verma-suraj/xelulu/Eillik/Untitled design.png

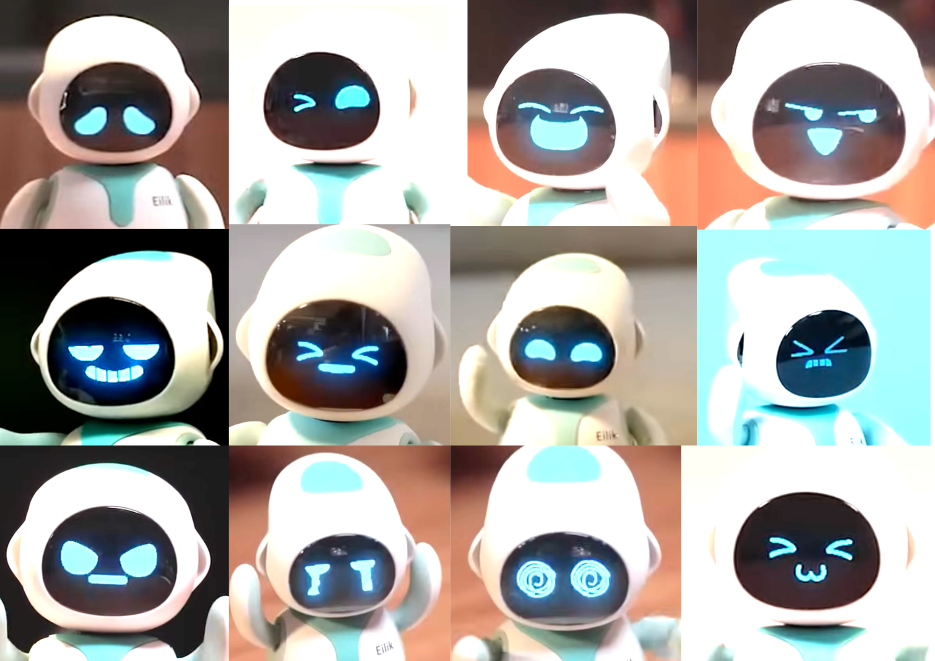
Eillik/Untitled design.png
