verma-suraj/xelulu/Sketch.png

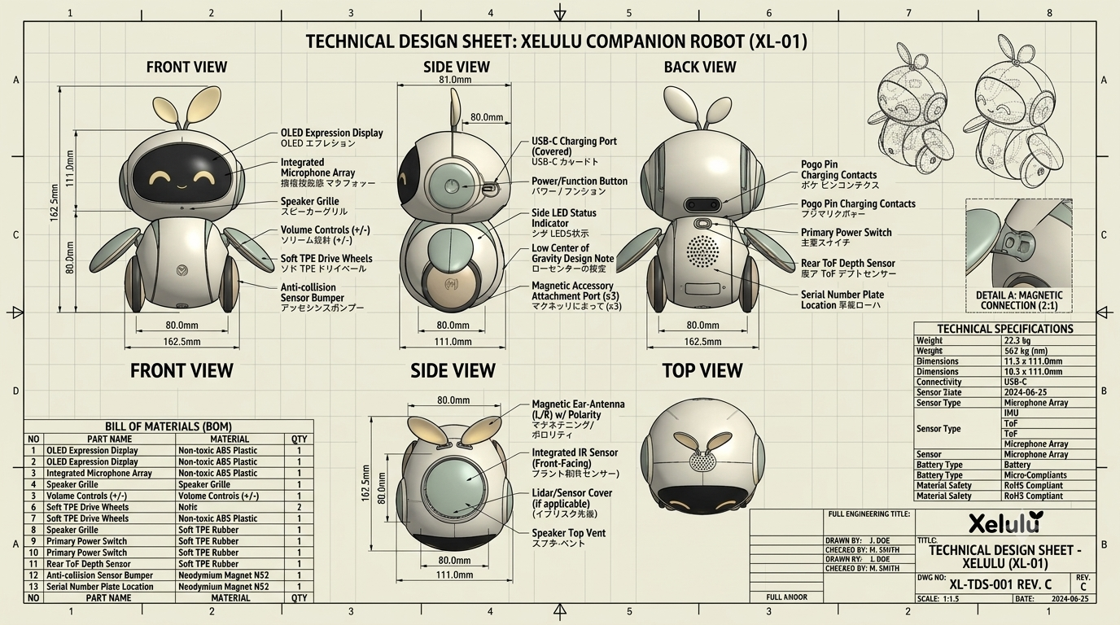
Sketch.png
