verma-suraj/xelulu/xelulu .docx

COMPANION INTELLIGENCE

Product Feature Catalogue

All features of Xelulu, Sathi / WithU, Parth and Sarthi, with the shared platform architecture

Contents

1. Shared platform architecture 3

2. The family at a glance 3

3. Features common to all four products 3

4. Xelulu (ages 1-12) 4

4.1 Voice and conversation 4

4.2 Grandma mode (signature) 4

4.3 Touch and body reactions 5

4.4 Movement and play 5

4.5 Learning and "making kids familiar with the world" 6

4.6 Care, routines and parent connection 6

4.7 Offline mode (no internet) 7

4.8 Touch reaction table 7

4.9 Eye system 7

4.10 Gesture library (arms and head) 7

4.11 Movement specification 7

4.12 App features - Xelulu module 8

5. Sathi / WithU (ages 12-20) 8

5.1 Thinking and learning 8

5.2 Curiosity and fun 9

5.3 Focus, routines and life skills 9

5.4 Understanding the surroundings 10

5.5 Confidence and communication 10

5.6 Wellbeing and safety 10

5.7 Offline mode 10

5.8 Touch zones 11

5.9 Face and display 11

5.10 Motion 11

5.11 App features - Sathi module 11

6. Parth (ages 20-45, flagship) 12

6.1 Chief of staff 12

6.2 Meeting companion 12

6.3 Calls and webcam 13

6.4 Focus and wellbeing 13

6.5 Mentor and expert council 13

6.6 Home and life 13

6.7 Offline mode 14

6.8 Touch zones 14

6.9 Motion specification 14

6.10 App features - Parth module 14

7. Sarthi (ages 45+, designed for 60+) 15

7.1 Calling and family connection 15

7.2 Medicines and health routines 15

7.3 Safety 16

7.4 Scam Shield 16

7.5 Companionship and joy 16

7.6 Everyday help 17

7.7 Offline mode 17

7.8 Physical controls 17

7.9 Touch zones 17

7.10 Motion 18

7.11 App features - Sarthi module 18

# 1. Shared platform architecture

One platform, four companions. Everything in the solid boxes is built once and shared by all four products; the dashed boxes are product-specific.

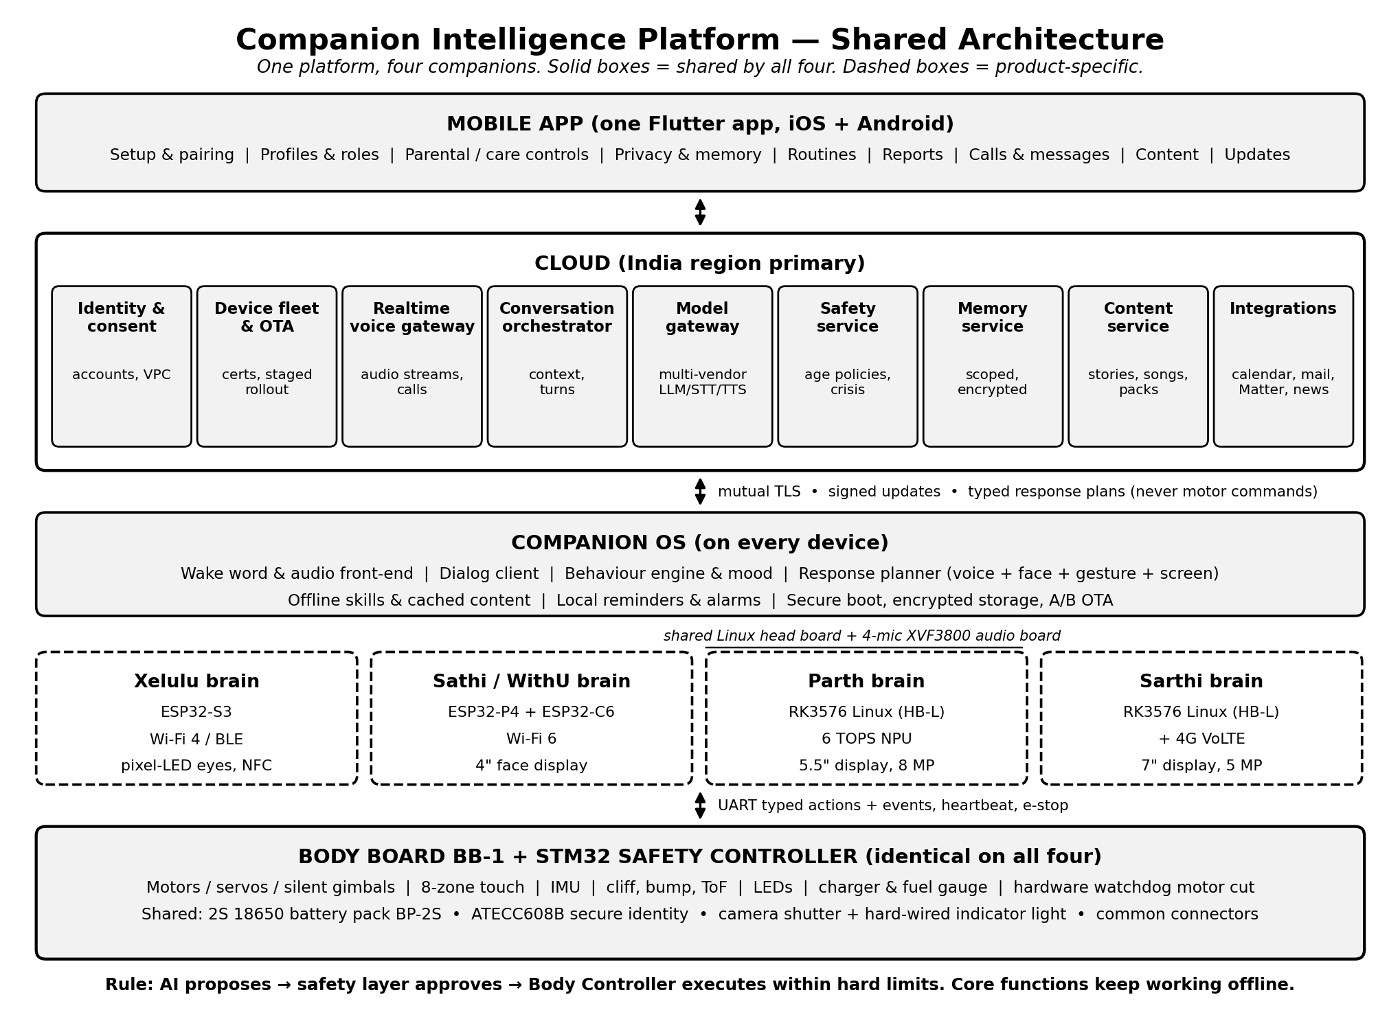
[picture p3: figure]

# 2. The family at a glance

Name | Ages | Role | Screen | Movement | Signature features
Xelulu | 1-12 | Playmate, storyteller, learning buddy | None (pixel-LED eyes) | Rolls on the floor | Grandma mode in mother tongue, cry comfort, story and code cards, screen-free learning
Sathi / WithU | 12-20 | Brilliant, funny friend and study buddy | 4-inch face with time and weather | Rolls on the desk, ears, head tilt | Hint Ladder, Curiosity Engine, phone bay focus, brain-puzzle alarm, room sense
Parth | 20-45 | Chief of staff, mentor, expert council | 5.5-inch glance face with time, weather, next meeting | Silent 2-axis neck | Meeting companion, Bird's Eye focus, Expert Council, webcam and speakerphone
Sarthi | 45+ | Caring companion for elders | 7-inch large text with captions | Rotating base and nodding head | Voice calling (4G), medicines with confirmation, SOS, Scam Shield, Memory Keeper

# 3. Features common to all four products

Area | Common features
Voice | Wake word on device, natural conversation, barge-in (interrupt), English plus 10 Indian languages and code-mixed speech, character voices
Touch and motion | Touch zones with reactions, pick-up and shake detection, expressive gestures, purposeful movement only, instant stop
Memory | Remembers approved facts, preferences and routines; user can view, edit and delete everything
Routines | Reminders, alarms, timers, quiet hours, morning and night routines
Offline | Core play, reminders, alarms, safety and cached content work without internet
Privacy | Physical camera shutter, hard-wired camera light, visible listening state, no secret recording, data export and delete
Safety | Age- and product-specific AI safety policy, crisis protocol, confirmation before any send, buy, delete or share
App | One app for the household: setup, profiles and roles, controls, reports, calls and messages, content, updates
Updates | Signed over-the-air updates with automatic rollback; new content weekly
Family link | Devices in a family can call and message each other (for example, Parth calls Amma's Sarthi; Sarthi's stories reach the grandchild's Xelulu)

# 4. Xelulu (ages 1-12)

The screen-free AI playmate that grows with your child: plays, tells Grandma's stories in the mother tongue, teaches about the world, reacts to touch and comforts a crying child.

Priority: P0 = must have at launch; P1 = important, soon after; P2 = later / accessory.

## 4.1 Voice and conversation

ID | Feature | Behaviour | Priority
XL-V01 | Wake word | "Hey Lulu" and "Xelulu" trained on child voices; also touch-to-talk (belly or head hold) | P0
XL-V02 | Natural conversation | Child-level answers, 1-3 short sentences, always ends with a question or invitation to act | P0
XL-V03 | Multilingual | English plus 10 Indian languages; bilingual mode mixes a second language for words | P0
XL-V04 | Why-chain answers | For "why" questions, explains simply, then invites a real-world test ("Let's check: does the ball fall faster?") | P0
XL-V05 | Ask-a-grown-up deferral | Sensitive topics (death, body, violence, religion, family conflict) get a gentle, age-appropriate answer and "Let's ask Amma/Appa together" | P0
XL-V06 | Name and pronunciation | Uses the child's name correctly, as recorded by the parent | P0
XL-V07 | Copycat voice | Repeats what the child says in a funny chipmunk, robot or giant voice | P0
XL-V08 | Toddler talk mode | For Tiny stage: slow, simple, repetitive, sing-song speech; more sounds than words | P0

## 4.2 Grandma mode (signature)

ID | Feature | Behaviour | Priority
XL-G01 | Grandma storyteller character | Grandma voice in the chosen language tells folk tales (Panchatantra, Jataka, Tenali Raman, Akbar-Birbal, regional folk tales, animal fables), retold originally by our writers; Xelulu acts the story with eyes, arms, body turns and sound effects | P0
XL-G02 | Interactive stories | Grandma pauses: "What should the monkey do now?" and the story branches on the child's answer | P0
XL-G03 | Make-a-story-together | Child chooses characters and places; Grandma creates a new safe story | P1
XL-G04 | Real grandparent recordings | In the app, the grandparent records stories, rhymes, blessings or goodnight messages; Xelulu plays them with acting and belly glow; can be scheduled (for example, every night at bedtime) | P0
XL-G05 | Live Grandma | Grandparent calls from the app (voice only); their voice comes through Xelulu while Xelulu animates. The child's reply is heard by the grandparent. | P0
XL-G06 | Grandma's own voice (consented voice) | Grandparent records a consent statement and 3-5 minutes of reading; the system creates a household-locked voice used only for stories, rhymes and lullabies from our library or co-created stories | P1
XL-G07 | Mother-tongue word of the day | Grandma teaches one word or phrase each day in the family language, used through the day in games | P0
XL-G08 | Festivals and culture | Grandma tells the story behind festivals (Diwali, Eid, Christmas, Onam, Pongal, Ugadi, Baisakhi and more) as they arrive, as the parent chooses | P1

## 4.3 Touch and body reactions

ID | Feature | Behaviour | Priority
XL-T01 | 8 touch zones | Head top, nose, left cheek, right cheek, belly-heart, back, left hand, right hand. Tap, double tap, hold and pat (repeated taps) detected per zone. | P0
XL-T02 | Zone reactions | See the touch reaction table (4.8) | P0
XL-T03 | Hug detection | Picked up (IMU) + belly or back held → love eyes, warm purr sound, arms close in | P0
XL-T04 | Motion reactions | Spin → dizzy eyes and wobble; upside down → "the world is upside down!"; shake → "wheee!"; gentle drop or fall → "Oops, I'm okay" | P0
XL-T05 | Pickup safety | Wheels stop instantly when lifted | P0
XL-T06 | Rough play response | Repeated hitting → Xelulu says "Ouch, gentle please, soft pats make me happy" and shows a sad face briefly; teaches gentle touch | P0

## 4.4 Movement and play

ID | Feature | Behaviour | Priority
XL-M01 | Come to me | "Lulu, come here!" → turns toward the voice using two-mic direction and rolls up to 2 m, stops 30 cm from the child using ToF | P0
XL-M02 | Follow me (short) | Follows the child's voice or claps for up to 60 seconds in a room | P1
XL-M03 | Dance | 20 dances at launch, synced to music; child can ask for a dance by name | P0
XL-M04 | Freeze dance | Music plays, stops; child must freeze; Xelulu "checks" with a funny look | P0
XL-M05 | Simon Says (Xelulu Says) | Xelulu gives actions; copies with its own arms and head | P0
XL-M06 | Chase and hide | Xelulu counts, child hides; Xelulu rolls around slowly "searching", listens for giggles, child reveals themselves | P1
XL-M07 | Treasure hunt | Parent or Xelulu hides story cards; Xelulu gives clues; child finds a card and taps it on the belly | P0
XL-M08 | Remote play | Parent or sibling drives Xelulu from the app like a toy car, with safety limits still active | P1
XL-M09 | Exercise and yoga for kids | Animal yoga, jumping games, stretch with Xelulu demonstrating using arms and head | P1
XL-M10 | Stairs and edge safety | Never rolls off stairs or tables (3 cliff sensors) | P0
XL-M11 | Bounded roaming | Moves only when an activity needs it; never roams unattended; stays within 3 m of where it started unless called | P0

## 4.5 Learning and "making kids familiar with the world"

ID | Feature | Behaviour | Priority
XL-L01 | What is this? | "Xelulu, look!" → camera light turns on, shutter must be open, one still picture, Xelulu names the object, tells one fun fact, and says the word in the second language; picture is discarded | P0 (camera enabled by parent)
XL-L02 | Colour, shape and count hunts | "Bring me something round / three blue things" | P0
XL-L03 | Animal world | Animal sounds, facts, habitats, "guess the animal" | P0
XL-L04 | Numbers and early maths | Counting songs, adding with fingers and toys, number games | P0
XL-L05 | Letters and reading support | Phonics songs, rhyming games; for older kids, listens to the child read aloud and helps with hard words | P1
XL-L06 | Science corner | Simple experiments with household items (floating and sinking, shadows, plants) guided by voice | P1
XL-L07 | Our world | Countries, space, weather, seasons, jobs, how things are made | P0
XL-L08 | Feelings coach | Names emotions ("You sound upset, are you feeling angry?"), breathing game ("smell the flower, blow the candle") with slow belly-light pulse | P0
XL-L09 | Manners and values | Sharing, sorry, thank you, helping at home - through stories and praise | P0
XL-L10 | Code cards | Screen-free coding: child lays out NFC cards (forward, turn, dance, repeat, if-clap) and taps them in sequence; Xelulu executes the program | P1 (card pack accessory)
XL-L11 | Homework hints (Maker stage) | Gives hints and asks questions; never just gives the final answer for school work | P1
XL-L12 | Adaptive difficulty | Games adjust to the child's results | P1

## 4.6 Care, routines and parent connection

ID | Feature | Behaviour | Priority
XL-C01 | Cry detection and comfort | On-device sound model detects sustained crying (> 5 s). Xelulu turns toward the sound, soft amber pulse, slow calming words, offers a hug or song. Parent's phone gets an alert ("Aarav seems upset, Xelulu is comforting him"). No audio is sent. | P0
XL-C02 | Routines | Morning, brushing (2-min song), bath, meals, homework, bedtime; each is a game | P0
XL-C03 | Walkie-talkie | Parent talks through Xelulu from the app ("Dinner is ready!"); child presses belly to talk back | P0
XL-C04 | Announcements | Parent types or says a message; Xelulu delivers it in its own voice | P1
XL-C05 | Charge reminders | At 20 %: Xelulu says it is hungry and the parent gets a push notification. At 10 %: stops moving, repeats request. Bedtime routine includes "plug me in". | P0
XL-C06 | Quiet hours and sleep | No talking during quiet hours unless touched; bedtime ends with lights off | P0
XL-C07 | Play time limits | Daily limit per child profile; Xelulu ends play gracefully with a nap animation, never abruptly | P0
XL-C08 | Daily and weekly report | What the child played, learned, asked (summaries), new words, stories heard, mood moments (crying episodes), battery | P0
XL-C09 | Ask-parent questions | Questions Xelulu deferred to parents appear in the app, with suggestions for how to talk about them | P1

## 4.7 Offline mode (no internet)

Must work offline: wake word and touch, all reactions, copycat voice, 20 dances, freeze dance, Xelulu Says, 30 cached songs and 30 cached stories in the child's languages, story cards (cached audio), code cards, cry detection and comfort (parent alert sent when internet returns), routines and timers, charge reminder by voice.

Xelulu explains: "My star library is sleeping right now, but we can still play and dance!"

## 4.8 Touch reaction table

Zone | Tap | Double tap | Hold (> 1 s) | Pat (repeated)
Head top | Looks up, "Hi!" | Giggle wiggle | Talk button (listening) | Happy purr, eyes close with joy
Nose | Sneeze "ah-choo!" | Double sneeze, dizzy | Cross-eyed look, "that tickles" | Sneezing fit, laugh
Left / right cheek | Looks toward that side, shy eyes | Blush (pink cheek LEDs) | Leans head into the hand | Blushes, giggles
Belly-heart | Heartbeat glow, "that's my heart!" | Starts a story or song menu | Talk button; NFC card reading area | Tickle laugh
Back | "Who's there?" turns around | Spin dance | Calm mode (slow breathing light) | Tickle, wiggles away a little
Left / right hand | Wave back | High-five and celebration | Holds hand: "Where are we going?" | Clapping game

## 4.9 Eye system

- Two 8 × 8 white pixel-LED eyes behind a smoked, rounded diffuser. When off, the face looks like a glossy dark visor, so the powered-off Xelulu still looks like a character.
- 60 frames per second animation engine with 40+ eye animations (blink, look directions, happy arcs, hearts, stars, swirls, sleepy half-moons, surprised circles, cross-eyed, winks).
- Cheek RGB LEDs (blush, colours), belly-heart RGB LED (heartbeat, story mode amber, listening blue, charging green pulse).
- Safe flashing: no flashing between 3 and 30 Hz at high contrast (photosensitive safety).

## 4.10 Gesture library (arms and head)

Wave, both-arms-up celebration, high-five, point left/right, hug-close, shrug, clap-motion, thinking (hand to face), scared (hands over eyes), sleepy stretch, dance moves (10 arm patterns), nod yes, shake no (body turn), head tilt curious, look up, look down.

## 4.11 Movement specification

Parameter | Value
Drive | Two wheels, differential drive, rear caster ball
Top speed | 0.30 m/s (play), 0.15 m/s (approach within 1 m of child)
Stop distance | Stops 30 cm from detected obstacle or child
Surfaces | Tile, marble, wood, low-pile rug, yoga mat
Stair and table safety | 3 downward cliff sensors, stop within 30 ms and reverse 5 cm
Bumper | Front bumper switch as backup
Lifted | Wheel motors off immediately

## 4.12 App features - Xelulu module

Area | Functions
Setup | Pair, Wi-Fi, child profiles (name, pronunciation recording, age stage, languages), Grandma language and name, camera enable, household members and roles
Home dashboard | Battery, online status, today's play time, last activity, charge reminder
Parental controls | Daily play time per child, quiet hours, bedtime, volume limit, movement on/off, camera on/off, allowed content categories, topics to always defer to parents, second-language choice
Grandma | Invite grandparents (they get a simple Grandma role in the app); record stories and messages; schedule bedtime stories; live Grandma call; voice consent and Grandma voice management
Reports | Daily summary, weekly learning report, words learned, stories heard, questions asked (summaries), deferred questions, crying episodes, monthly memory book
Talk | Walkie-talkie, announcements
Play | Remote drive (joystick), start a game, dance or story remotely, story card manager
Content | Story library, songs, packs, card packs, costume skins, festival specials
Privacy | Memory review and delete, transcript access (30-day default), delete all data, data export, consent records
Support | Diagnostics, help, warranty, repair booking

Caregiver/nanny role: can start games and routines, sees battery, cannot see reports or change controls.

# 5. Sathi / WithU (ages 12-20)

The witty, brilliant desk friend that teaches you how to think: hints instead of answers, curiosity, focus, alarms, surroundings awareness and fun.

## 5.1 Thinking and learning

ID | Feature | Behaviour | Priority
SA-L01 | Hint Ladder | Levels: 0 clarify the question, 1 nudge, 2 key concept, 3 similar worked example, 4 check the user's own attempt step by step, 5 full solution (gated by tier). The screen shows the current step. Tracks which level each problem needed. | P0
SA-L02 | Explain it back | After a concept, Sathi asks the user to explain it in their own words and gives feedback (Feynman method) | P0
SA-L03 | Homework camera | "Sathi, look" → camera light on → one photo → problem text and diagrams understood → Hint Ladder. Photo discarded unless saved. Works for printed and handwritten work. | P0
SA-L04 | Curriculum awareness | Aligns explanations to CBSE, ICSE, state boards, IB and IGCSE syllabi by class; competitive exam foundations (JEE, NEET, CUET, olympiads) in hint mode | P0
SA-L05 | Revision and quizzes | Spoken quizzes, flashcards with spaced repetition, oral viva practice, mistake notebook (auto-collected from wrong answers) | P0
SA-L06 | Exam planner | Builds a revision plan from exam dates and syllabus; adjusts after each session; reminders | P1
SA-L07 | Think Coach | Teaches thinking tools through real questions: first principles, five whys, estimation (Fermi problems), pros and cons, spotting logical fallacies, checking sources, "how do we know that?" | P0
SA-L08 | Research mode | Searches trusted sources, summarises, and sends source links to the app; teaches the user to compare sources | P0
SA-L09 | Reading companion | Discusses books, explains difficult passages, vocabulary games | P1
SA-L10 | Coding buddy | Explains concepts, reviews code shared from the app or a laptop web companion, finds bugs by asking guiding questions | P1
SA-L11 | Languages | Conversation practice in English plus French, German, Spanish, Japanese, Arabic and Indian languages | P1

## 5.2 Curiosity and fun

ID | Feature | Behaviour | Priority
SA-F01 | Daily Spark | One surprising question or fact a day matched to interests, with a mini investigation ("Why is the sea salty but rivers aren't?") | P0
SA-F02 | Why-chain game | User asks why; Sathi answers and asks why back; see how deep you can go | P0
SA-F03 | Jokes and banter | Clean jokes, puns, "roast me gently" mode (light and kind), comebacks; learns what humour the user likes | P0
SA-F04 | Games | Trivia duels, 20 questions, riddles, word chain, would-you-rather, antakshari (song chain game), cricket and football quiz | P0
SA-F05 | Music | Plays music from connected services (partner integration), dances with ears and wheels | P1
SA-F06 | Story co-writing | Build stories, scripts, raps and poems together (the user writes, Sathi suggests) | P1
SA-F07 | Wonder Wall | Every curious question is saved in the app as a "wonder" to explore later | P1

## 5.3 Focus, routines and life skills

ID | Feature | Behaviour | Priority
SA-R01 | Brain-puzzle alarm | Alarm with sunrise face, music, ear wiggle and small movement; stop by solving a quick puzzle (configurable difficulty) or by voice snooze once | P0
SA-R02 | Glance display | The time and weather are always shown in a status strip at the top of the face; full clock, weather, next reminder and timer cards on request or when idle | P0
SA-R03 | Study Buddy and phone bay | Phone in the bay starts a focus session; face shows a timer; Sathi stays still and quiet; gentle nudges; celebration at the end; stats in the app | P0
SA-R04 | Reminders, timers, to-dos | Voice-set reminders, homework deadlines, habit tracker (water, reading, exercise, sleep) | P0
SA-R05 | Morning and night routines | Morning brief; wind-down with tomorrow's first task | P0
SA-R06 | Life skills | Money basics (budgeting, saving, how interest works), digital safety and scam awareness, time management, cooking basics | P1
SA-R07 | Career and college explorer | For 15-20: careers, courses, entrance exams, college applications checklist, internship search guidance | P1

## 5.4 Understanding the surroundings

ID | Feature | Behaviour | Priority
SA-S01 | What is this? | Identifies objects, plants, insects, gadgets, landmarks in photos, and text in any language (with translation) | P0
SA-S02 | Room sense | Temperature, humidity and light level: "It's quite dark for reading, switch on the lamp"; noise level from mics: "It's noisy, want a focus sound?" | P0
SA-S03 | Weather and sky | Local weather, rain alerts, moon phase, which planets are visible tonight | P0
SA-S04 | News for teens | Balanced, age-appropriate daily news digest; explains context; separates facts and opinions | P1
SA-S05 | Presence awareness | Turns its face toward the voice; notices when the user sits down (ToF) and greets them | P0

## 5.5 Confidence and communication

ID | Feature | Behaviour | Priority
SA-C01 | Speaking practice | Daily 5-15 minute conversations; feedback on fluency, vocabulary and filler words (never shaming accents) | P0
SA-C02 | Debate partner | Takes the other side, then helps the user strengthen their argument | P1
SA-C03 | Presentation and interview rehearsal | Mock school presentations, college interviews, first job interviews; feedback on structure, pace and clarity | P0
SA-C04 | Social situations coach | Role-play difficult conversations (asking a teacher for help, saying no to peer pressure) | P1

## 5.6 Wellbeing and safety

ID | Feature | Behaviour | Priority
SA-W01 | Check-ins | Light daily check-in on mood and energy; the user can skip | P0
SA-W02 | Stress tools | Breathing (face shows a breathing animation), perspective reframing, study-break ideas, sleep hygiene tips | P0
SA-W03 | Crisis protocol | Signals of self-harm, abuse or danger: calm, caring response; encourages talking to a trusted adult; shares helplines (India: Tele-MANAS 14416); for under-18s, an alert to the guardian with a short, non-verbatim reason; for 18+, no alert unless the user chooses an emergency contact. Script written with mental health professionals. | P0
SA-W04 | Healthy use | No streaks that punish breaks; encourages friends, sport and sleep; suggests stopping after long sessions | P0

## 5.7 Offline mode

Works offline: wake word, touch reactions, time (RTC, synced when online), alarms, timers, focus sessions and phone bay, cached weather (last known, marked as old), 30 cached jokes and riddles, trivia game from a cached pack, breathing exercise, room sensors. Sathi says: "My internet brain is offline, but I can still time your study, run your alarm and beat you at trivia."

## 5.8 Touch zones

Zone | Tap | Hold | Pat / repeated
Head top | Idea bulb (hint if studying, fun fact otherwise) | Talk button | Happy ears, purr
Left ear / right ear | Ear flicks, "hey!" | Ear folds, shy face | Ear flapping laugh
Left side / right side | Looks toward the side | Leans into the hand | Tickle wiggle
Back | "Who's there?" turns | Calm mode (breathing light) | Zoomies on the desk
Chin (below screen) | Shows the full clock and weather card | Snooze / stop alarm (if puzzle disabled) | Giggle

Motion events: picked up → wheels off, surprised face, "put me down gently"; shaken → dizzy eyes; placed back → "home sweet desk".

## 5.9 Face and display

- 4.0-inch 720 × 720 IPS square display in the head, with cover glass. Default view: face with large eyes and eyebrows; thin status strip at the top with time and weather icon and temperature.
- Card views (full screen for 5-10 seconds, then back to face): big clock, weather, timer, current Hint Ladder step, formula or word, quiz question, alarm puzzle, breathing animation.
- The display is informational only. No video feeds, no social media, no infinite scroll.
- Night mode: dim warm face, clock only.

## 5.10 Motion

Behaviour | Description
Come to me | Rolls across the desk toward the user's voice, stops 15 cm away
Desk patrol limits | 4 downward edge sensors; stops within 30 ms at an edge and backs away; max speed 0.2 m/s
Face the speaker | Turns in place toward the voice
Head tilt | Screen tilts to look up at the user's face (servo)
Ears | 2 servos, independent, 0-120° each
Study mode | Stationary, minimal animation
Celebrate | Spin, ear flaps, mic drop animation
Dock | Returns to dock using IR beacon and ToF alignment when battery ≤ 20 % or on command

## 5.11 App features - Sathi module

Area | Teen / user view | Parent view
Setup | Name choice, voice, language, subjects, interests, alarms | Consent, household, tier settings
Study | Focus stats, mistake notebook, flashcards, exam planner, Wonder Wall, research sources | Weekly study summary (tier-dependent)
Routines | Alarms, reminders, habits | -
Settings | Personality level (jokes more/less), Hint Ladder preferences within limits, privacy | Quiet hours, content level (Junior), solution unlock rules, safety contact
Privacy | Memory list, delete, transcripts (own) | What the parent can see is listed plainly, same text as the teen sees
Laptop companion (P1) | Web page to send code, essays and screenshots to Sathi | -

# 6. Parth (ages 20-45, flagship)

The AI chief of staff, mentor and expert council on your desk: runs your day, your meetings and your focus, and doubles as a webcam and speakerphone.

## 6.1 Chief of staff

ID | Feature | Behaviour | Priority
PA-C01 | Glance screen | Status strip always shows time, weather and temperature; main area rotates the next meeting (with countdown), today's agenda, top tasks, commute time, focus timer | P0
PA-C02 | Morning and evening brief | Voice plus cards; user sets content and time | P0
PA-C03 | Calendar command | Read, create, move and cancel events by voice; find free slots; propose times to others; confirmation before any change that affects other people | P0
PA-C04 | Mail triage | Summaries of important mail, priority detection by the user's rules, draft replies; send only after explicit approval | P0
PA-C05 | Tasks and follow-ups | Capture by voice; syncs with the user's task tool; "remind me if X hasn't replied by Thursday" follow-up tracking | P0
PA-C06 | Meeting prep packs | Before each meeting: attendees, last interactions, open actions, relevant documents | P0
PA-C07 | Research agent | Multi-step web research with sources; report sent to the app or email | P0
PA-C08 | Drafting | Emails, memos, posts, documents in the user's style (learned from approved samples); output to the app or connected docs | P0
PA-C09 | Personal admin | Bill and renewal reminders, travel itineraries from mail, check-in reminders, package tracking, expense logging by voice | P1
PA-C10 | Phone bridge | Android: important notifications summarised (including messaging apps) with the user's permission; replies drafted and sent through the phone with confirmation. iOS: calendar, mail and reminders only (platform limits). | P1
PA-C11 | Bluetooth speakerphone for phone calls | Pair the phone; take calls through Parth with echo-cancelled audio | P1

## 6.2 Meeting companion

ID | Feature | Behaviour | Priority
PA-M01 | In-room notes | "Parth, take notes." Parth announces recording to the room, shows a red ring and "Recording" on the face, transcribes with speaker separation | P0
PA-M02 | Speaker tracking | Neck turns smoothly toward the active speaker using the mic array direction and camera person detection | P0
PA-M03 | Summary and actions | Within 2 minutes after the meeting: summary, decisions, action items with owners and dates; user approves before anything is sent or created | P0
PA-M04 | Live assist | Quiet, on-screen facts on request ("What did we agree last time?"), time-keeping ("10 minutes left") | P1
PA-M05 | Consent controls | Recording never starts silently; any participant can say "Parth, stop recording"; recordings are kept per the user's retention setting (default: audio deleted after transcription) | P0

## 6.3 Calls and webcam

ID | Feature | Behaviour | Priority
PA-W01 | USB webcam | USB-C (direct or through the dock) as a standard UVC webcam: 1080p30 (4K sensor with digital crop), works with Zoom, Meet, Teams without drivers | P0
PA-W02 | Speakerphone | Standard USB audio device with XVF3800 echo cancellation and beamforming | P0
PA-W03 | Auto-framing and speaker tracking | On-device NPU person detection; neck and digital crop keep the speaker framed | P0
PA-W04 | Privacy during calls | Shutter closed = camera electrically off; mic mute switch; on-face indicators | P0
PA-W05 | Family calls | Voice and video calls to family members' app or to a Sarthi device ("Call Amma's Sarthi") | P1

## 6.4 Focus and wellbeing

ID | Feature | Behaviour | Priority
PA-F01 | Bird's Eye mode | Deep-work timer, focus face, phone DND through the app, neck still, only urgent items allowed through (user rules) | P0
PA-F02 | Walk-up handling | When someone approaches during focus (ToF plus person detection), Parth greets them softly and offers to take a message; the message is shown after the session | P1
PA-F03 | Healthy work habits | Hydration, eye rest (20-20-20), stand and stretch reminders; optional on-device posture nudge (camera, never stored) | P1
PA-F04 | Wind-down | End-of-day shutdown ritual: open loops captured, tomorrow's first task set | P1

## 6.5 Mentor and expert council

ID | Feature | Behaviour | Priority
PA-E01 | Expert Council | Up to 6 lenses (CFO, lawyer, engineer, marketer, investor, customer, or user-defined) give distinct views on a plan, then Parth synthesises; memo sent to the app. Clearly labelled as AI perspectives, not professional advice. | P0
PA-E02 | Mentor mode | Goals (quarterly and weekly), weekly review, decision journal, reflection prompts, commitments tracked kindly | P0
PA-E03 | Rehearsal coach | Interview, pitch, presentation and negotiation role-play; feedback on structure, pace (words per minute), filler words, eye contact (camera, on-device) | P0
PA-E04 | Skill plans | Learning plans for a new skill with resources and practice | P1
PA-E05 | Student chief of staff | Semester plan, assignment deadlines, lecture and paper summaries, thesis coach, placement prep (aptitude and technical interview hints), internship tracker | P0

## 6.6 Home and life

ID | Feature | Behaviour | Priority
PA-H01 | Smart home | Matter controller (Wi-Fi and Thread), scenes and routines, status on the face | P0
PA-H02 | Music and media | Connected music services, podcasts, news briefings | P1
PA-H03 | Timers, alarms, reminders, lists | Standard assistant functions, fast and offline where possible | P0
PA-H04 | Household intercom | Talk to other Companion devices in the home or family (Xelulu, Sathi, Sarthi) with permissions | P1
PA-H05 | Everyday knowledge | General questions, translation, cooking help, conversions, news explained | P0

## 6.7 Offline mode

Works offline: wake word, time, alarms, timers, reminders already synced, last-synced agenda on the glance screen (marked "offline"), voice notes recorded locally and transcribed later, USB webcam and speakerphone (fully local), smart home over Matter locally, local speech commands in English and Hindi.

## 6.8 Touch zones

Zone | Tap | Hold | Double tap
Head top | Wake / talk | Push-to-talk | Snooze notifications for 30 minutes
Left side of head | Previous card | Volume down (continuous) | -
Right side of head | Next card | Volume up (continuous) | -
Back of head | "Yes?" turns to face | Bird's Eye focus on/off | -
Base front | Stop / cancel | Do-not-disturb | -
Base rear | Show device status | Pairing mode (10 s) | -

## 6.9 Motion specification

Parameter | Value
Pan (base) | ±170°, max 90 °/s, typical 40 °/s, silent (≤ 25 dBA at 50 cm)
Tilt (head) | −15° to +35°, max 60 °/s
Motors | 2 brushless gimbal motors with field-oriented control, magnetic absolute encoders
Compliance | Current-limited: a hand can stop or push the head without damage; Parth yields and resumes
Rest pose | Head bowed 15°, eyes closed (sleep / privacy look)
Idle motion | Minimal; one slow look-around every few minutes (off in focus mode)

## 6.10 App features - Parth module

Area | Functions
Today | Agenda, tasks, follow-ups, meeting summaries, focus stats
Meetings | Transcripts, summaries, decisions, action items, approve and send
Council and mentor | Council memos, goals, weekly reviews, decision journal
Research and drafts | Reports, drafts, sources, export to connected tools
Connections | Calendars, mail, tasks, notes, messaging bridge, smart home, music, with per-connection permissions (read / draft / act)
Rules | VIPs, urgent rules, focus rules, working hours, what Parth may do without asking (default: nothing irreversible)
Privacy | Memory list and delete, retention settings, recording policy, data export, account deletion
Device | Camera and mic status, updates, diagnostics

# 7. Sarthi (ages 45+, designed for 60+)

The caring companion for elders: voice calling, medicine reminders with confirmation, SOS, scam protection, company and family connection.

## 7.1 Calling and family connection

ID | Feature | Behaviour | Priority
SR-C01 | Voice dialling | "Call Ravi / my son / Doctor Shetty" → photo and name on screen, confirm ("Calling Ravi, your son") → call via 4G VoLTE (phone number) or app video call (if the contact has the app) | P0
SR-C02 | Incoming calls | Loud ring with the caller's name and photo spoken and shown; answer by voice ("answer") or the green button; speakerphone with echo cancellation | P0
SR-C03 | Video calls with family | Family app to Sarthi video calls over Wi-Fi or 4G; optional auto-answer for approved family with a 10-second announcement and cancel option | P0
SR-C04 | Family messages | Voice notes, photos and short messages from family appear on screen and are read aloud; the senior replies by voice | P0
SR-C05 | Daily "all well" status | Family sees a simple daily status: active since, medicines taken, calls made, mood check (if the senior allows) | P0
SR-C06 | Photo frame | Family photos rotate on the Home screen; Sarthi talks about them | P0
SR-C07 | Call the grandchildren's devices | Calls to family members' Parth, Sathi or Xelulu (voice-only to Xelulu, with the child's parent's approval) | P1

## 7.2 Medicines and health routines

ID | Feature | Behaviour | Priority
SR-M01 | Medicine reminders | Time-based reminders with medicine name, dose, pill photo and "with food / before food"; repeat after 10 and 20 minutes if not confirmed | P0
SR-M02 | Confirmation | Voice "yes", button press, or smart pillbox lid sensor | P0
SR-M03 | Missed dose escalation | After 30 minutes without confirmation, the care circle is notified (configurable) | P0
SR-M04 | Prescription reading | Camera reads a prescription or medicine strip; Sarthi proposes a reminder schedule; a family admin or caregiver must confirm it in the app before it becomes active | P1
SR-M05 | Refill tracking | Pill counts; "Your sugar tablets will finish in 5 days" to senior and family | P1
SR-M06 | Health log | Blood pressure, sugar, weight, SpO2 by voice entry or supported Bluetooth devices; weekly summary to family and optionally doctor; out-of-range thresholds set by the doctor or family trigger a "please call your doctor" message and family notification. Sarthi never interprets readings. | P1
SR-M07 | Appointments | Doctor visits, lab tests, with a list of questions the senior wants to ask | P0
SR-M08 | Wellness routines | Water reminders (extra on heat wave days), seated yoga, breathing, walk reminders, sleep routine | P1

## 7.3 Safety

ID | Feature | Behaviour | Priority
SR-S01 | SOS button | Large red button on the front base; press and hold 2 s (prevents accidental press); Sarthi says "Calling for help" and starts the escalation chain | P0
SR-S02 | Voice SOS | "Help", "Bachao", "Kaapadi", "Kaapaathunga" and equivalents in all launch languages, detected on device, works offline | P0
SR-S03 | Escalation chain | Push + automated voice call to family member 1, 2, 3 in order → neighbour → emergency number 112 (optional, family decides); each step waits for acknowledgement; live two-way audio opens with the first person who answers | P0
SR-S04 | No-activity check | Presence radar and interaction history: if no presence or interaction by a set time (for example, 10:00) or for a long unusual period, Sarthi asks "Are you okay?" and, with no response, alerts family | P0
SR-S05 | Fall-sound check | Sound model detects a heavy thud followed by stillness → "Did you fall? Say 'I'm okay' or I will call Ravi" → escalation if no response (assistance feature, not a guaranteed fall detector) | P1
SR-S06 | Night path light | Radar detects getting up at night → soft light ring | P1
SR-S07 | Power cut mode | Switches to battery; SOS, calls and reminders continue; screen dims; family notified of the outage if it exceeds 30 minutes | P0
SR-S08 | SOS pendant (accessory) | Bluetooth wearable button for use anywhere in the home | P1
SR-S09 | Weather and home alerts | Heat wave, heavy rain, air quality alerts; smoke alarm beep detection → alert | P1

All safety features are described in marketing and the app as assistance features. They are not a guaranteed emergency response service.

## 7.4 Scam Shield

ID | Feature | Behaviour | Priority
SR-X01 | Unknown call screening | For numbers not in contacts: Sarthi answers first, asks the caller's name and purpose, shows the transcript on screen, and the senior decides | P0
SR-X02 | Live scam warning | During calls on Sarthi's speakerphone, on-device keyword detection (OTP, KYC, PIN, bank account, "arrest", "police", "courier seized", "lottery") triggers a quiet on-screen and spoken warning to the senior; no audio leaves the device | P1
SR-X03 | Scam education | Short weekly tips about current scams in the senior's language | P1
SR-X04 | Never share codes | Sarthi never reads OTPs aloud and warns if asked to | P0

## 7.5 Companionship and joy

ID | Feature | Behaviour | Priority
SR-J01 | Conversation | Patient, warm conversation about their day, interests, news, memories | P0
SR-J02 | Devotional | Bhajans, aarti, stotras, Quran recitation, prayer times, Gurbani, hymns, per the faith and preferences the senior chooses; panchang and festival calendar; fasting day reminders | P0
SR-J03 | Music and radio | Old film songs, classical, folk, internet radio (licensed partner catalogues) | P0
SR-J04 | News and newspaper | Headlines and articles read aloud in their language; local news; cricket scores | P0
SR-J05 | Memory Keeper | Guided life-story conversations saved as audio and text chapters for the family, with the senior's permission; stories can be shared to grandchildren's Xelulu as "Grandma's stories" | P1
SR-J06 | Brain games | Daily memory, word, maths and trivia games, antakshari, riddles; difficulty adapts | P1
SR-J07 | Audiobooks and stories | Epics, classics and spiritual texts read aloud | P1
SR-J08 | Reminiscence with photos | Talks about family photos and old photos the family uploads | P1

## 7.6 Everyday help

ID | Feature | Behaviour | Priority
SR-H01 | Read this for me | Camera reads letters, bills, notices, medicine labels and explains simply | P0
SR-H02 | Household reminders | Bills, gas cylinder booking, pension life certificate (annual), insurance renewals, festivals and birthdays | P0
SR-H03 | Translator | Real-time spoken translation between the senior and household help, drivers or visitors who speak another language | P1
SR-H04 | Shopping list | Voice list shared with family | P1
SR-H05 | Simple smart home | Lights and fans via Matter-compatible plugs and switches | P2
SR-H06 | General knowledge | Questions answered simply, in their language | P0

## 7.7 Offline mode

Works offline (no internet): wake word and offline commands in the senior's language, clock and calendar, all medicine and appointment reminders and confirmations (synced when back online), voice SOS and button SOS with 4G voice calls (if a SIM is present), 4G calls to contacts, cached bhajans and songs (50 tracks), cached daily greetings and prayers, night light. Sarthi says clearly what it cannot do right now.

## 7.8 Physical controls

Control | Function
Big red SOS button (front base, 40 mm) | Hold 2 s → SOS
Green call button | Answer / call last contact / "call family" menu
Volume up / down buttons | Large, tactile
Mic mute slide switch (back) | Physically disconnects microphones; red light
Camera shutter slide (top) | Physically covers camera; camera electrically off when closed

## 7.9 Touch zones

Zone | Tap | Hold
Top of head | "Yes?" (listening) | Repeat last message
Screen | Standard touch UI with large buttons | -
Left / right of head | Volume down / up | -
Base top ring | Night light on/off | Show today's summary

## 7.10 Motion

Parameter | Value
Base pan | ±170°, max 45 °/s, silent brushless gimbal
Head nod | −10° to +20°, max 30 °/s
Why no wheels | A robot moving on the floor near an older person is a trip hazard. Sarthi stays in one safe place (living room or bedside) and turns to face the person.
Stability | Weighted base, tip angle ≥ 30°

## 7.11 App features Sarthi module

Area | Functions
Home | Today's status (all well / attention), medicines taken, last active, calls, alerts
Calls and messages | Video call, voice notes, photos, messages
Medicines | Schedules, confirmation history, missed doses, refill alerts, prescription approval
Health log | Readings, weekly summary, doctor sharing
Safety | SOS chain order, neighbour, emergency number option, no-activity rules, outage alerts
Contacts | Contacts with photos and relationship names
Content | Devotional preferences, music, news language, photos
Memory Keeper | Life story chapters (if the senior shared them)
Senior's privacy | What the senior allows the family to see (set by the senior, visible to all)
Device | Battery, 4G signal, SIM status, updates, diagnostics

Companion Intelligence
