verma-suraj/xelulu/Eillik/Animation sheet.png

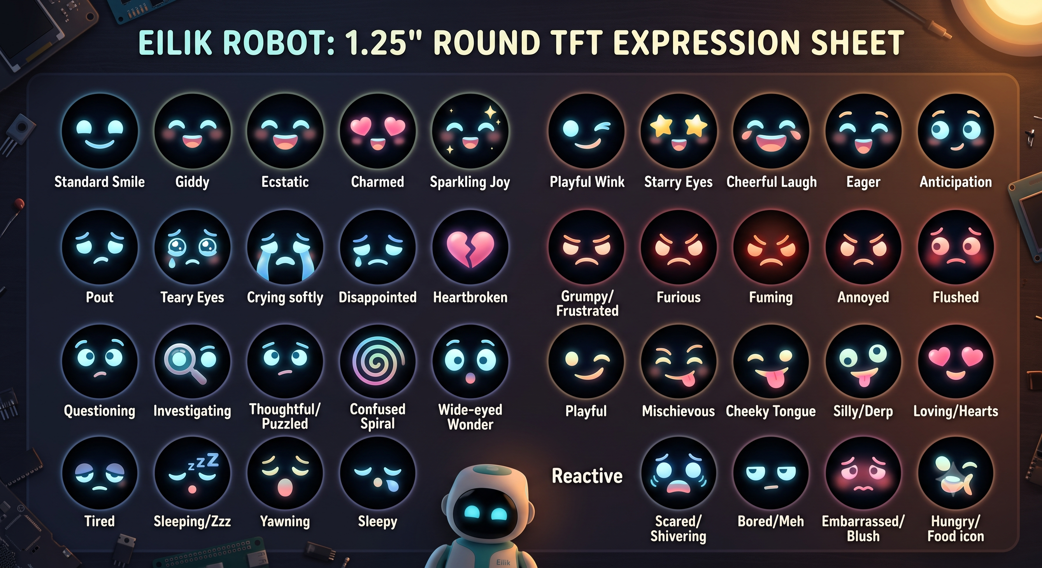
Eillik/Animation sheet.png
