verma-suraj/xelulu/Eillik/Emotion screenshots/Annoyed.png

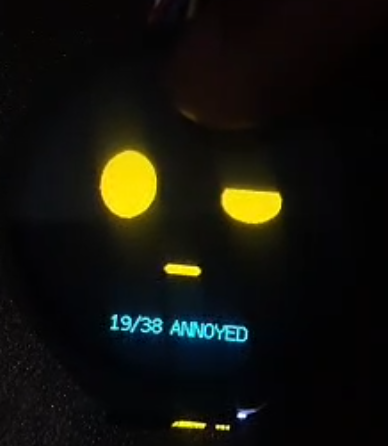
Eillik/Emotion screenshots/Annoyed.png
