verma-suraj/xelulu/Eillik/Emotion screenshots/Anticipation.png

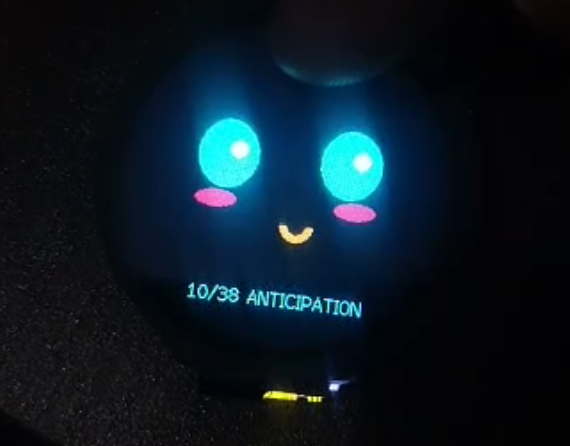
Eillik/Emotion screenshots/Anticipation.png
