verma-suraj/xelulu/Eillik/Emotion screenshots/Bored.png

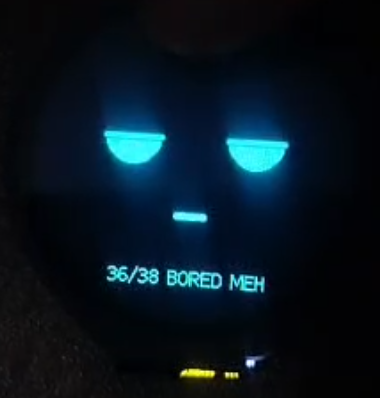
Eillik/Emotion screenshots/Bored.png
