verma-suraj/xelulu/Eillik/Emotion screenshots/Cheeky tongue.png

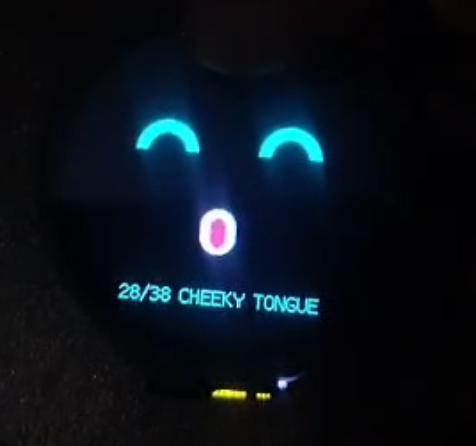
Eillik/Emotion screenshots/Cheeky tongue.png
