verma-suraj/xelulu/Eillik/Emotion screenshots/cheerful laugh.png

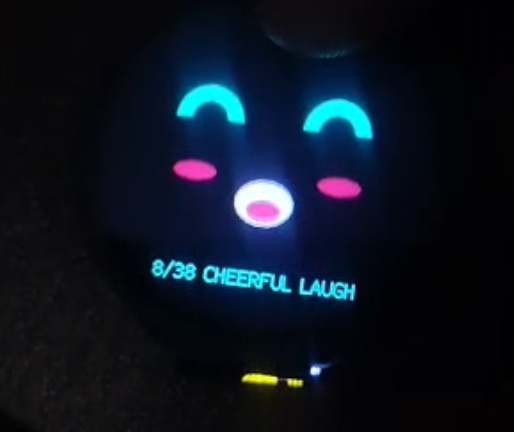
Eillik/Emotion screenshots/cheerful laugh.png
