verma-suraj/xelulu/Eillik/Emotion screenshots/Confused spiral.png

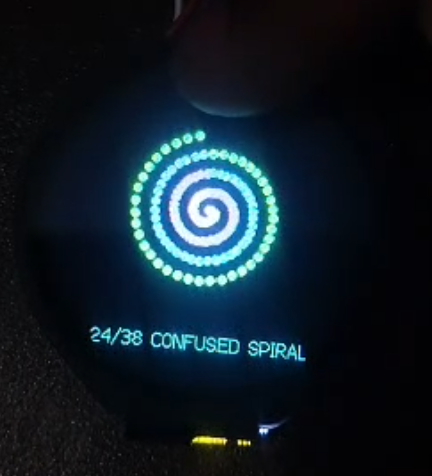
Eillik/Emotion screenshots/Confused spiral.png
