verma-suraj/xelulu/Eillik/Emotion screenshots/Disappointed.png

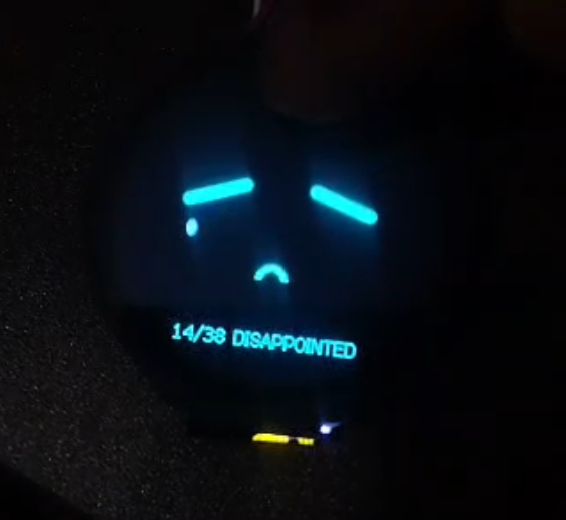
Eillik/Emotion screenshots/Disappointed.png
