verma-suraj/xelulu/Eillik/Emotion screenshots/Ecstatic.png

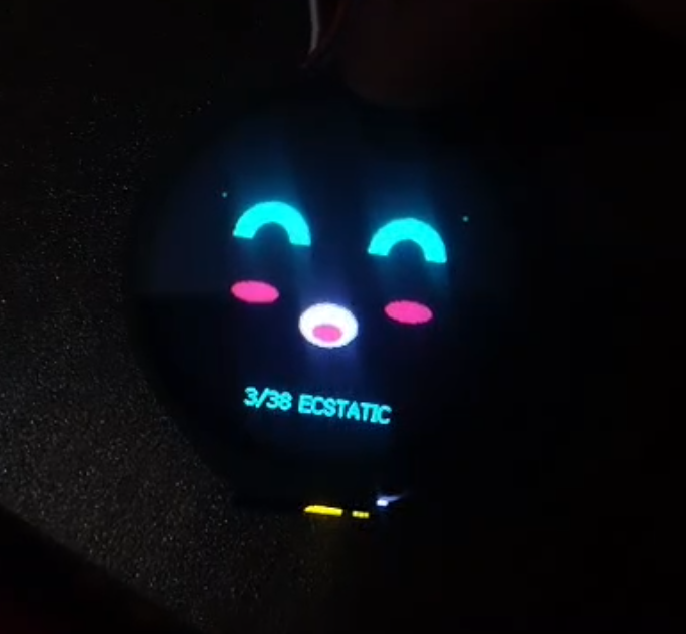
Eillik/Emotion screenshots/Ecstatic.png
