verma-suraj/xelulu/Eillik/Emotion screenshots/Embarresed.png

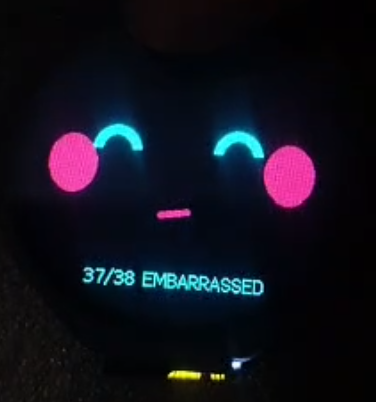
Eillik/Emotion screenshots/Embarresed.png
