verma-suraj/xelulu/Eillik/Emotion screenshots/Flushed.png

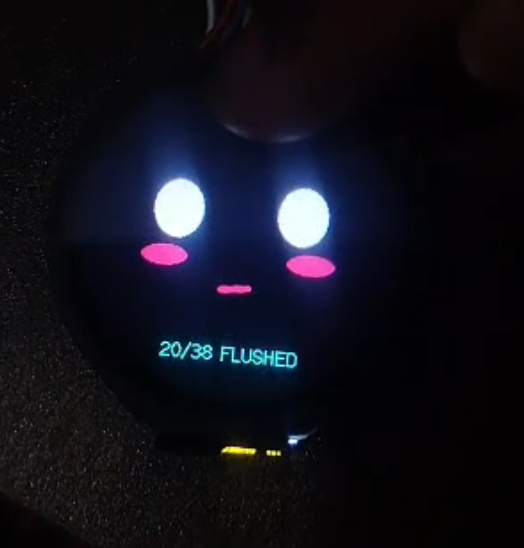
Eillik/Emotion screenshots/Flushed.png
