verma-suraj/xelulu/Eillik/Emotion screenshots/Fuming.png

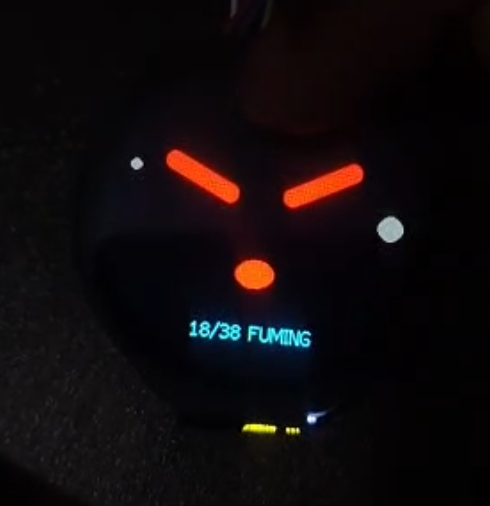
Eillik/Emotion screenshots/Fuming.png
