verma-suraj/xelulu/Eillik/Emotion screenshots/Furious.png

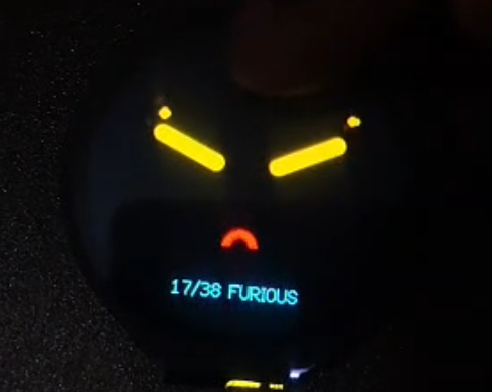
Eillik/Emotion screenshots/Furious.png
