verma-suraj/xelulu/Eillik/Emotion screenshots/Giddy.png

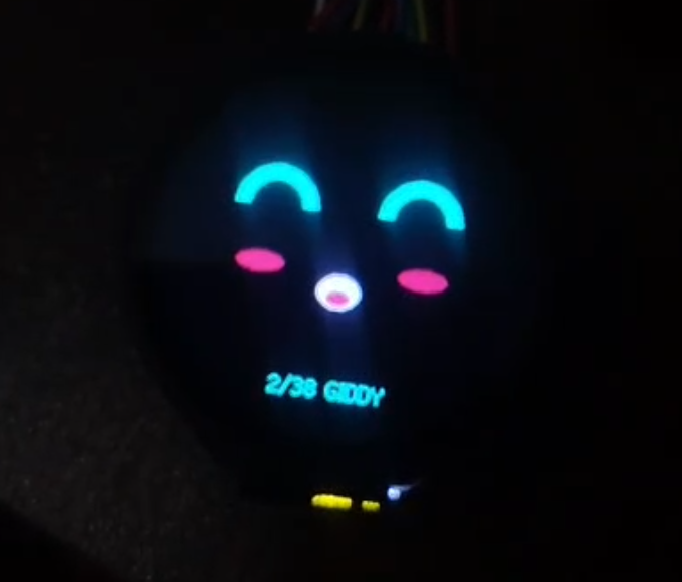
Eillik/Emotion screenshots/Giddy.png
