verma-suraj/xelulu/Eillik/Emotion screenshots/Grumpy.png

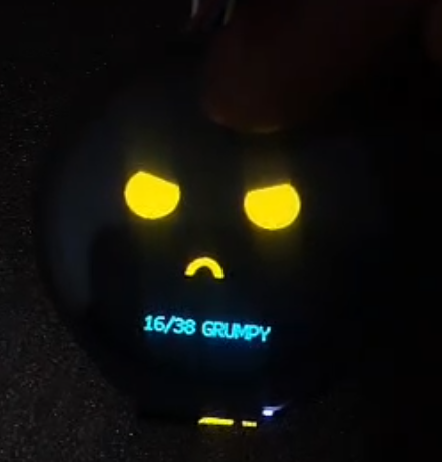
Eillik/Emotion screenshots/Grumpy.png
