verma-suraj/xelulu/Eillik/Emotion screenshots/Heartbroken.png

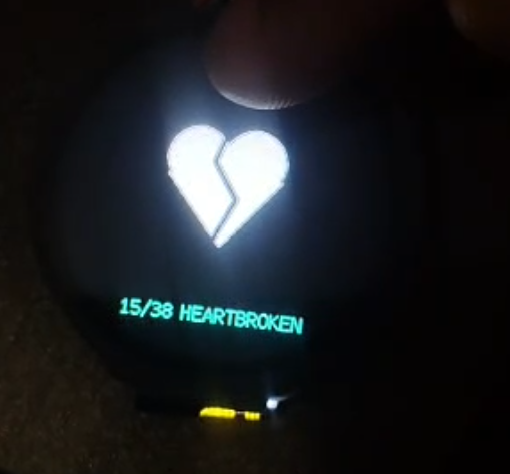
Eillik/Emotion screenshots/Heartbroken.png
