verma-suraj/xelulu/Eillik/Emotion screenshots/hungry.png

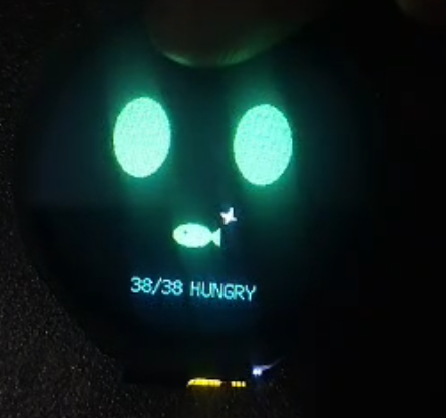
Eillik/Emotion screenshots/hungry.png
