verma-suraj/xelulu/Eillik/Emotion screenshots/investigating.png

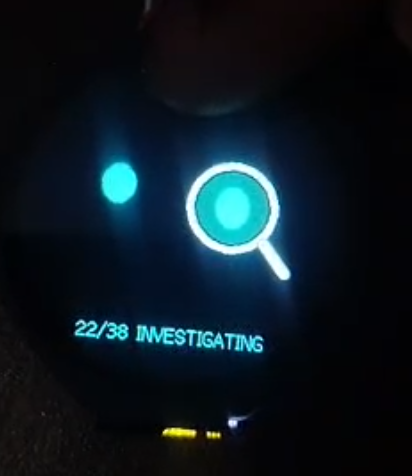
Eillik/Emotion screenshots/investigating.png
