verma-suraj/xelulu/Eillik/Emotion screenshots/Loving.png

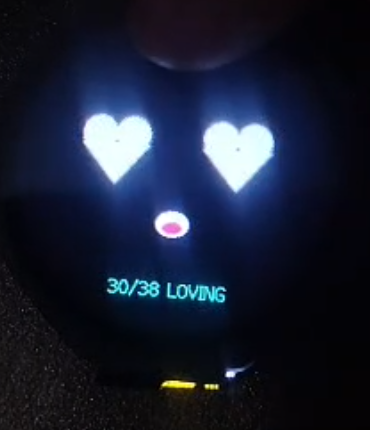
Eillik/Emotion screenshots/Loving.png
