verma-suraj/xelulu/Eillik/Emotion screenshots/Mischievous.png

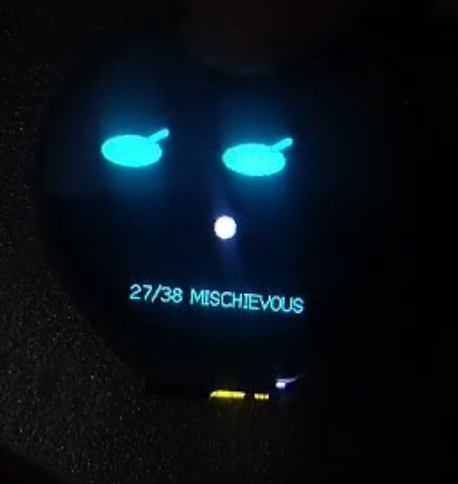
Eillik/Emotion screenshots/Mischievous.png
