verma-suraj/xelulu/Eillik/Emotion screenshots/Playful wink.png

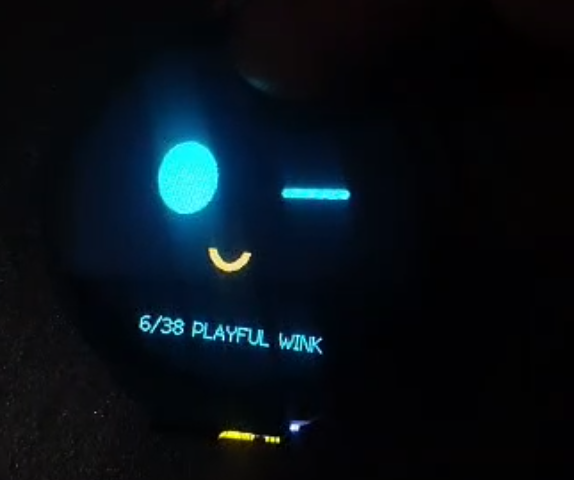
Eillik/Emotion screenshots/Playful wink.png
