verma-suraj/xelulu/Eillik/Emotion screenshots/playful.png

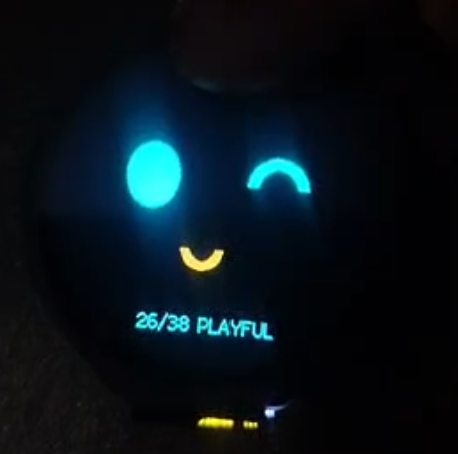
Eillik/Emotion screenshots/playful.png
