verma-suraj/xelulu/Eillik/Emotion screenshots/pout.png

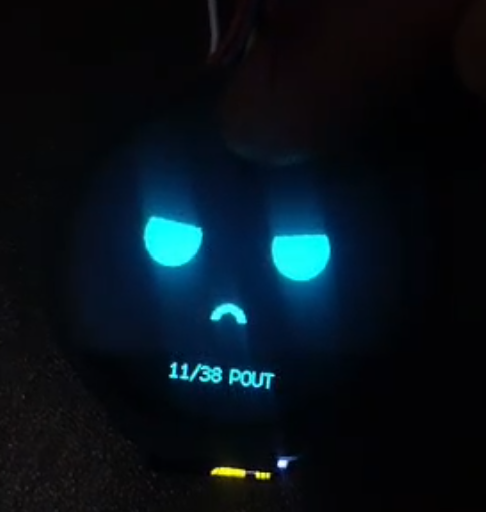
Eillik/Emotion screenshots/pout.png
