verma-suraj/xelulu/Eillik/Emotion screenshots/Questioning.png

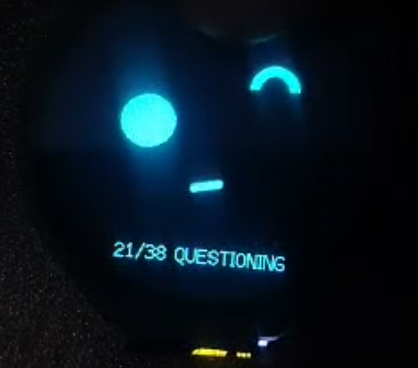
Eillik/Emotion screenshots/Questioning.png
