verma-suraj/xelulu/Eillik/Emotion screenshots/Scared.png

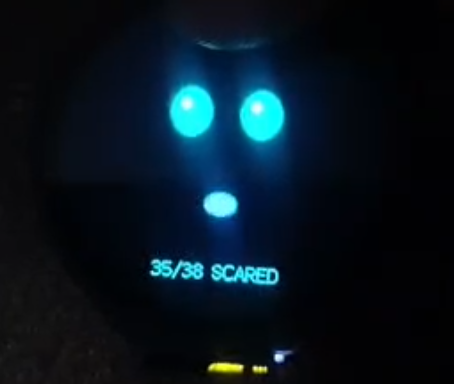
Eillik/Emotion screenshots/Scared.png
