verma-suraj/xelulu/Eillik/Emotion screenshots/Sleeping.png

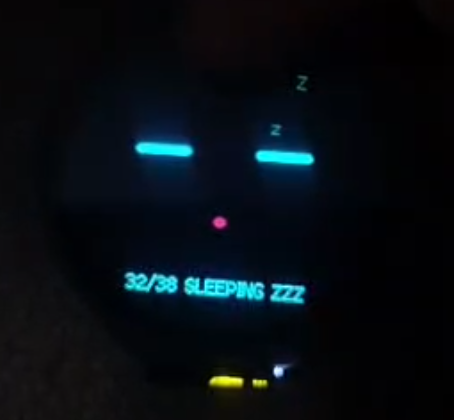
Eillik/Emotion screenshots/Sleeping.png
