verma-suraj/xelulu/Eillik/Emotion screenshots/Sleepy.png

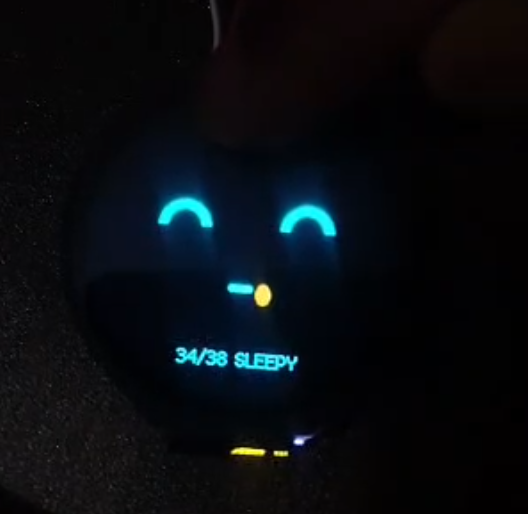
Eillik/Emotion screenshots/Sleepy.png
