verma-suraj/xelulu/Eillik/Emotion screenshots/Smile.png

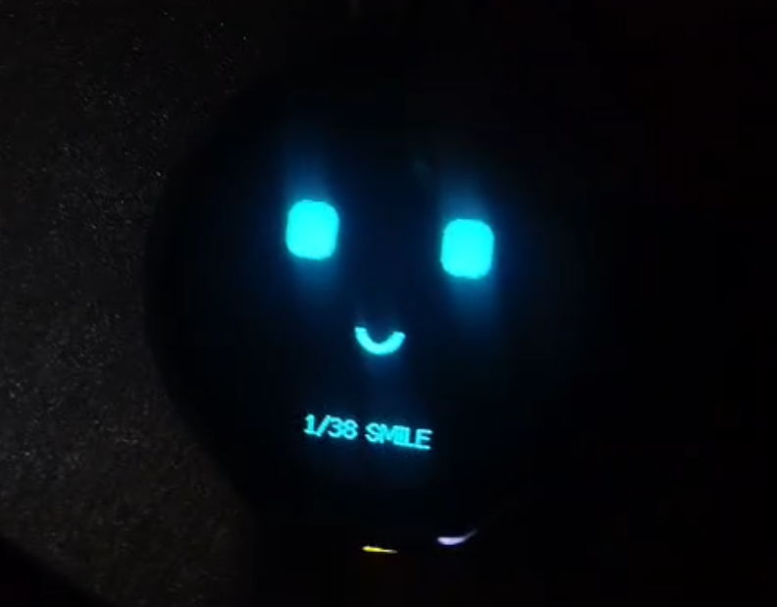
Eillik/Emotion screenshots/Smile.png
