verma-suraj/xelulu/Eillik/Emotion screenshots/Sparkling joy.png

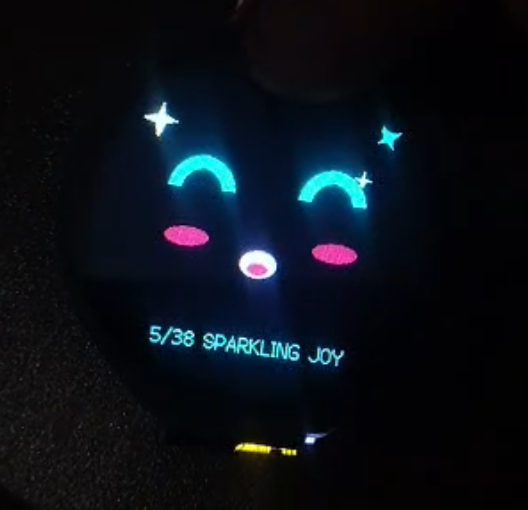
Eillik/Emotion screenshots/Sparkling joy.png
