verma-suraj/xelulu/Eillik/Emotion screenshots/teary eyes.png

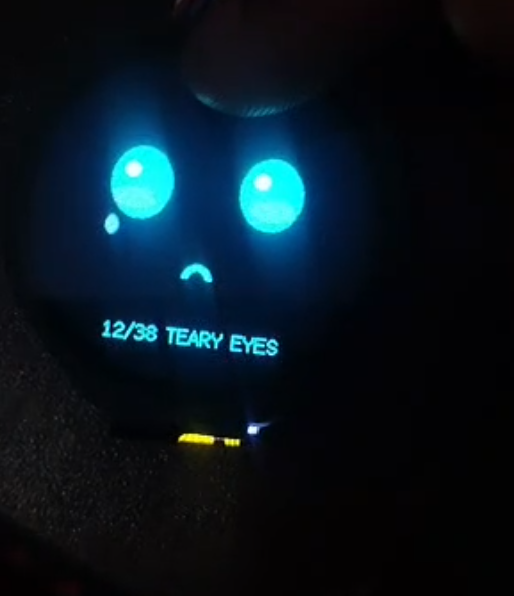
Eillik/Emotion screenshots/teary eyes.png
