verma-suraj/xelulu/Eillik/Emotion screenshots/thoughtfu;.png

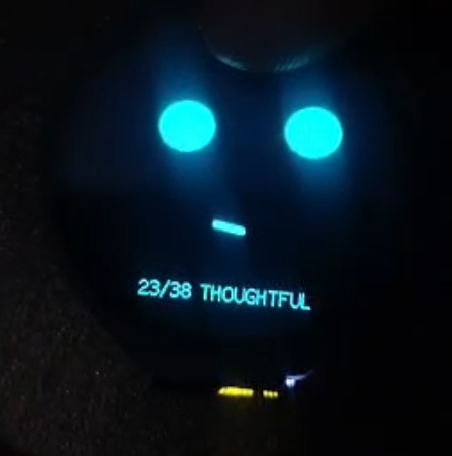
Eillik/Emotion screenshots/thoughtfu;.png
