verma-suraj/xelulu/Eillik/Emotion screenshots/tired.png

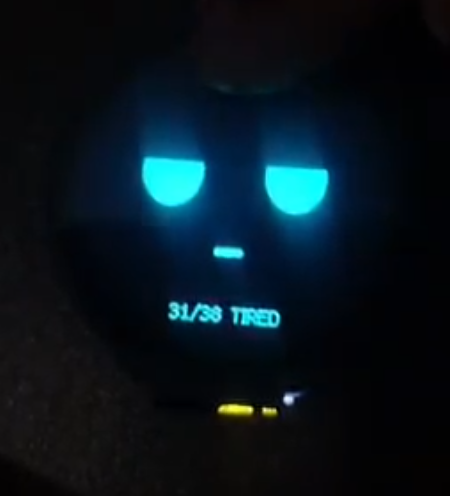
Eillik/Emotion screenshots/tired.png
