verma-suraj/xelulu/Eillik/Emotion screenshots/Wonder.png

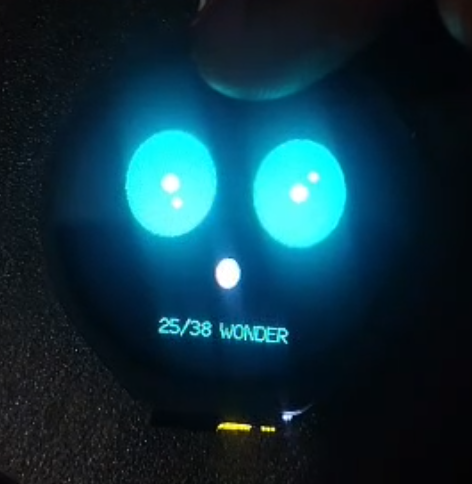
Eillik/Emotion screenshots/Wonder.png
