verma-suraj/xelulu/Eillik/Screenshot 2026-07-09 004320.png

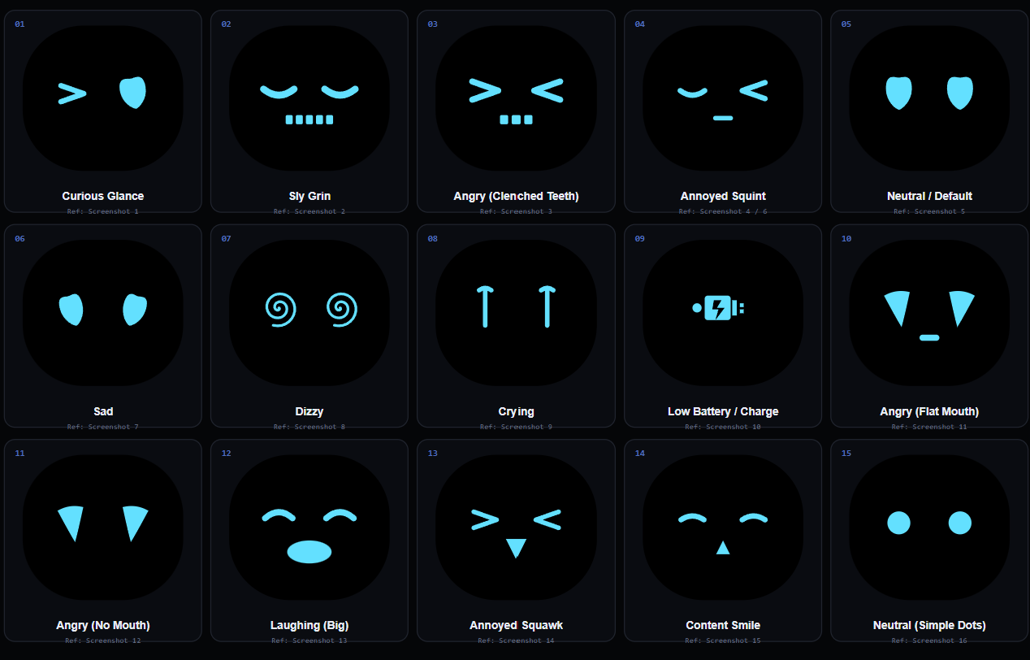
Eillik/Screenshot 2026-07-09 004320.png
