verma-suraj/xelulu/Eillik/Screenshot 2026-07-09 004344.png

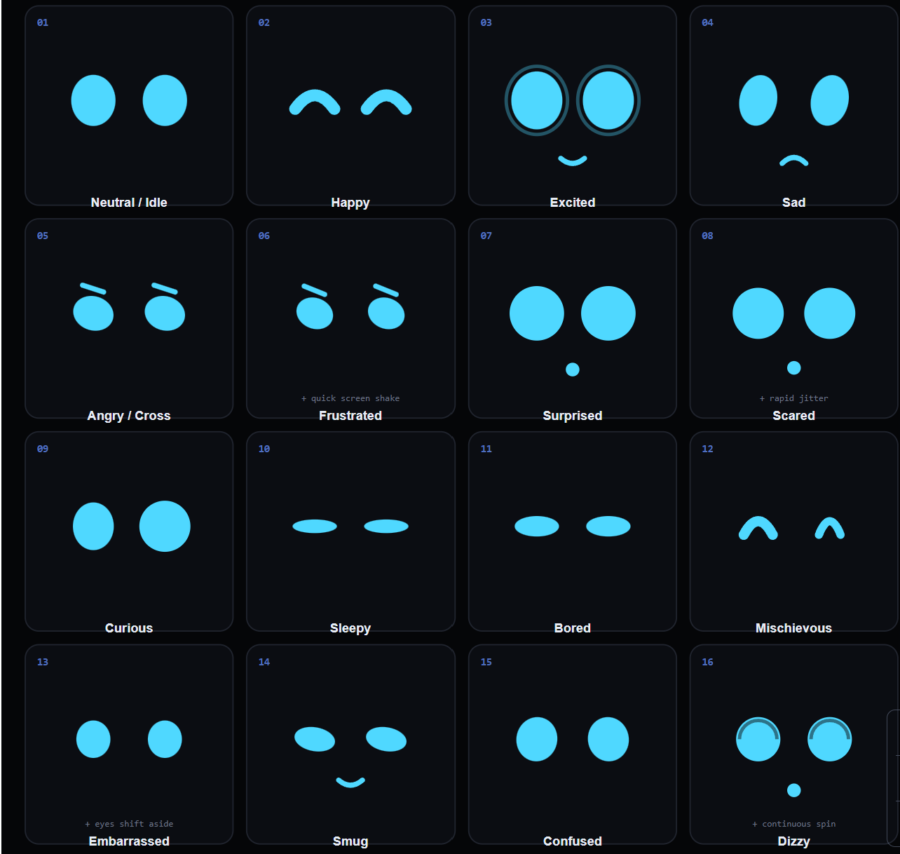
Eillik/Screenshot 2026-07-09 004344.png
