verma-suraj/xelulu/parth.jpeg

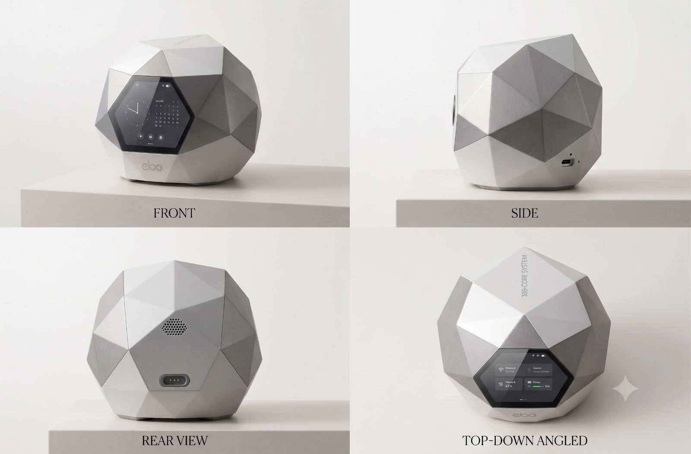
parth.jpeg
