verma-suraj/xelulu/Sarthi.jpeg

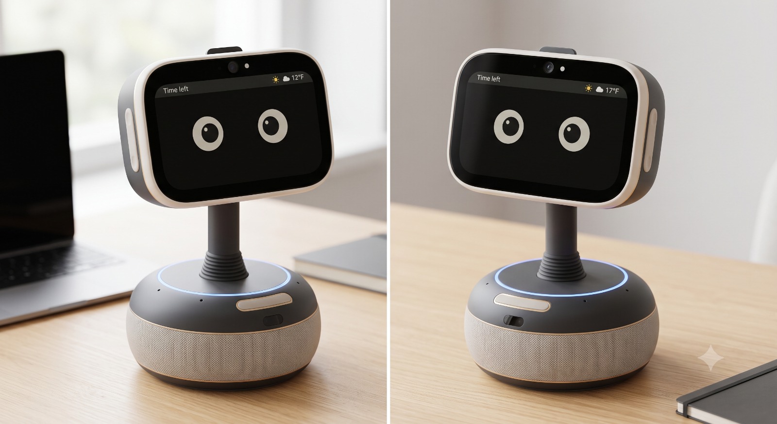
Sarthi.jpeg
