verma-suraj/xelulu/Xelulu.jpeg

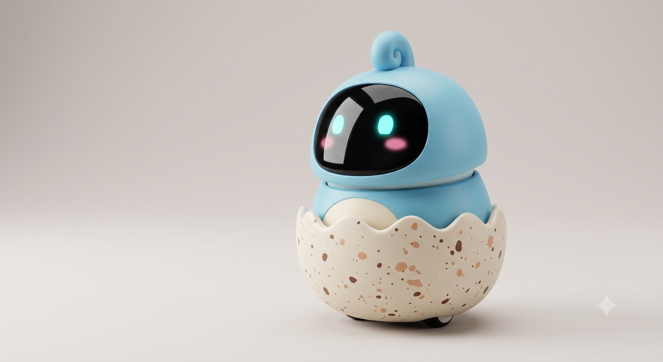
Xelulu.jpeg
