verma-suraj/xelulu/Xelulu_report_attachments_2026-11-01/01_matrix_simulator_28of28.png

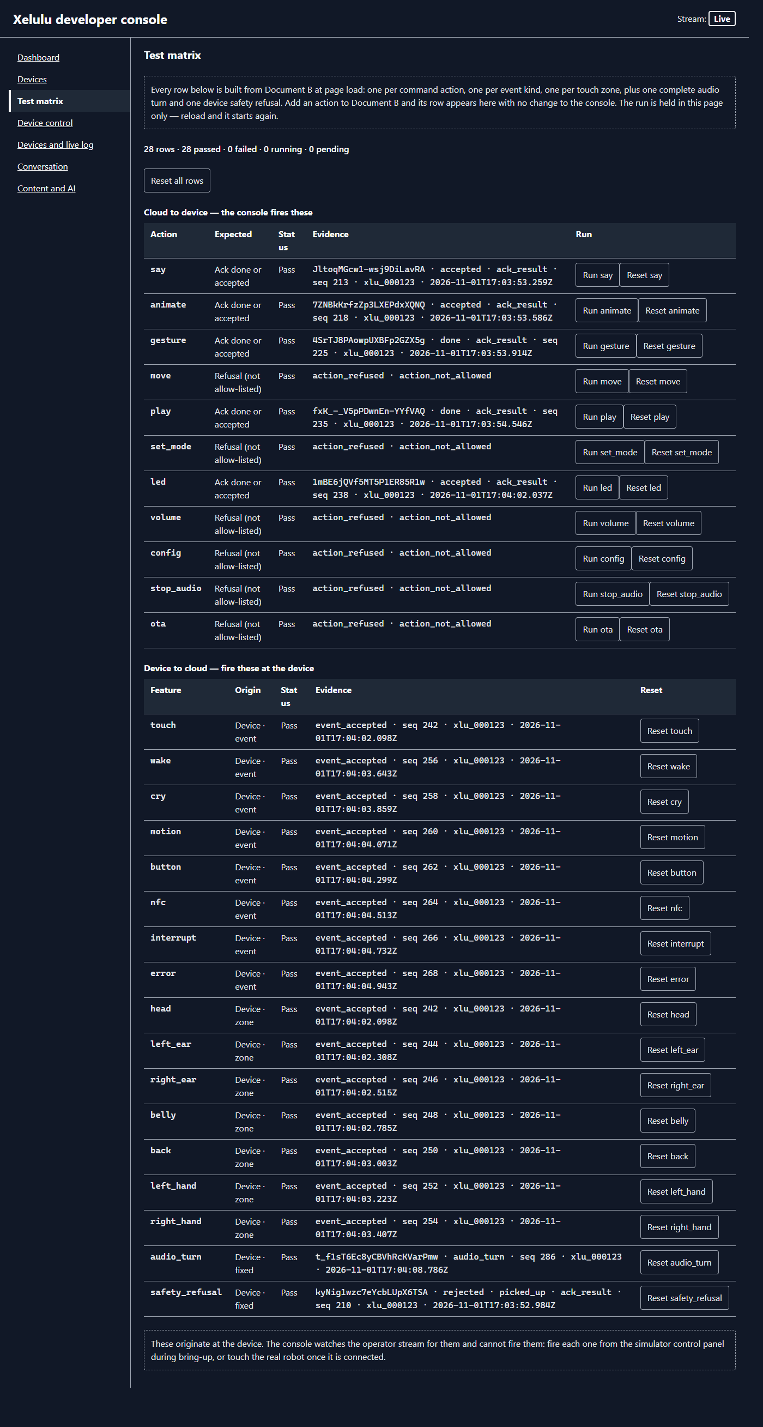
Xelulu_report_attachments_2026-11-01/01_matrix_simulator_28of28.png
