verma-suraj/xelulu/Xelulu_report_attachments_2026-11-01/02_matrix_robot_21of28.png

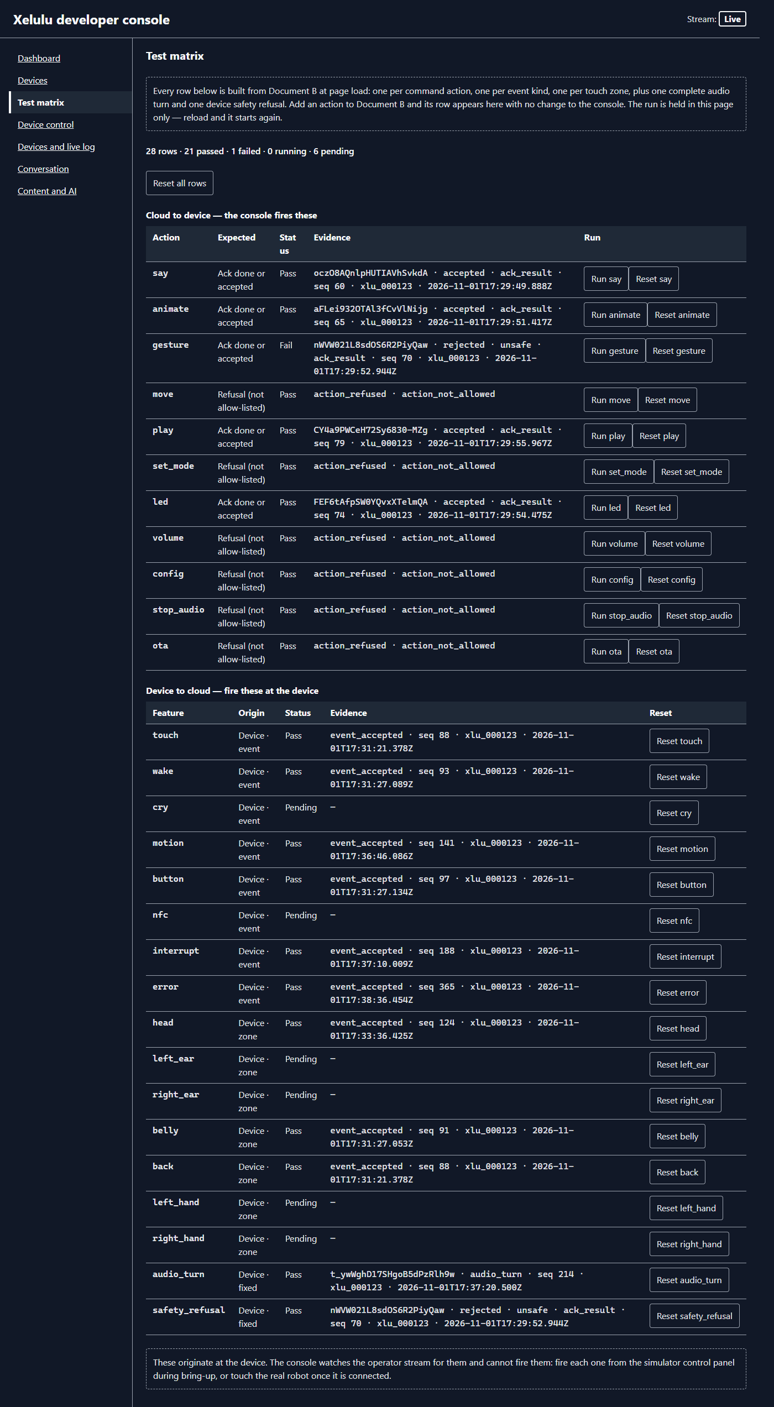
Xelulu_report_attachments_2026-11-01/02_matrix_robot_21of28.png
