verma-suraj/xelulu/Xelulu_report_attachments_2026-11-01/03_dashboard.png

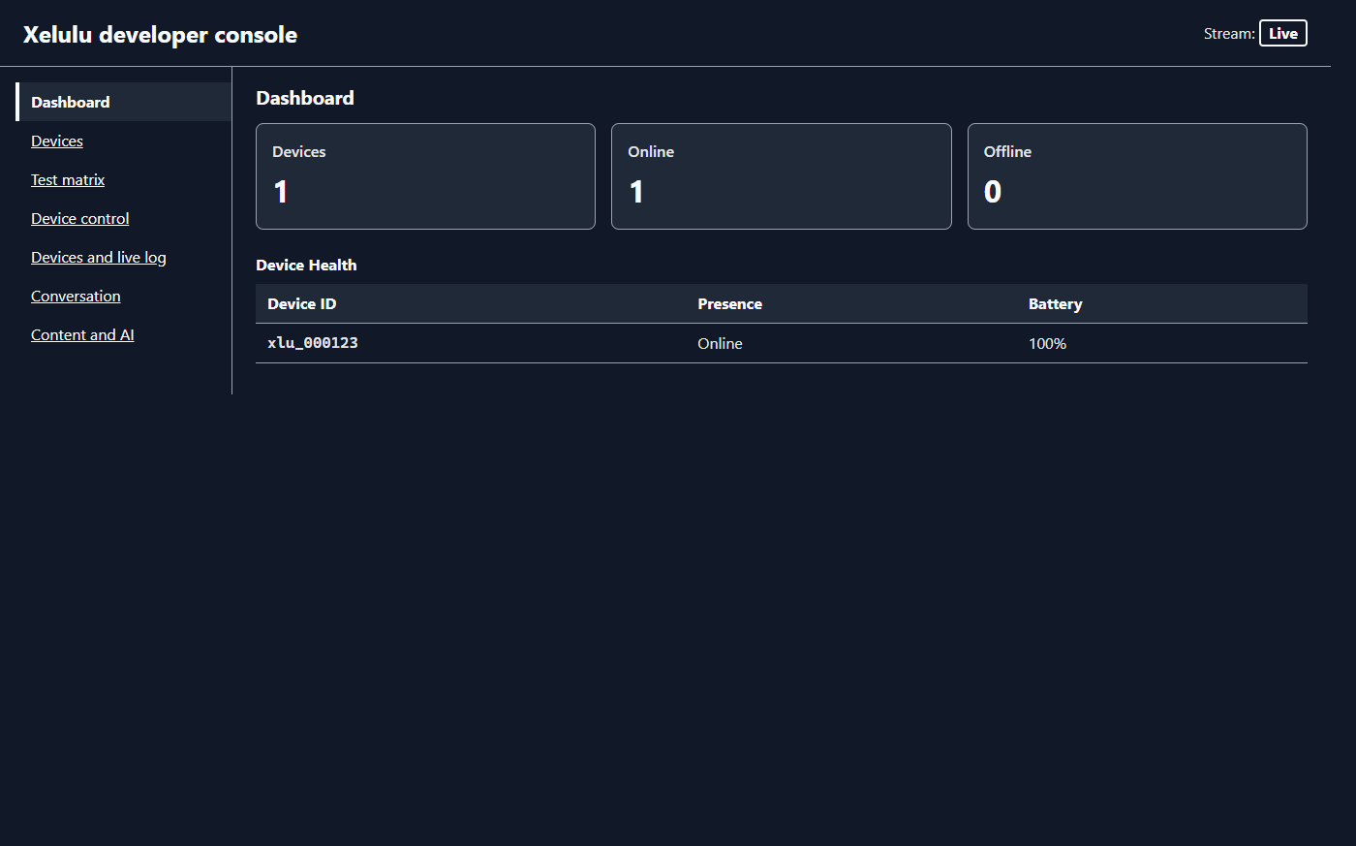
Xelulu_report_attachments_2026-11-01/03_dashboard.png
