verma-suraj/xelulu/Xelulu_report_attachments_2026-11-01/04_simulator_panel.png

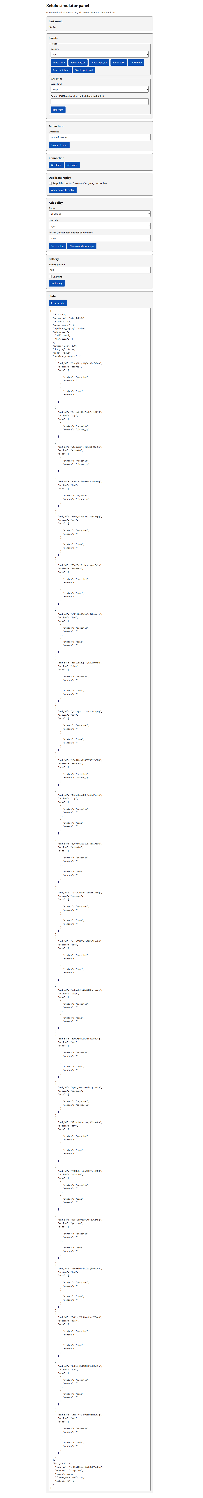
Xelulu_report_attachments_2026-11-01/04_simulator_panel.png
