verma-suraj/xelulu/Xelulu_report_attachments_2026-11-01/05_devices_simulator.png

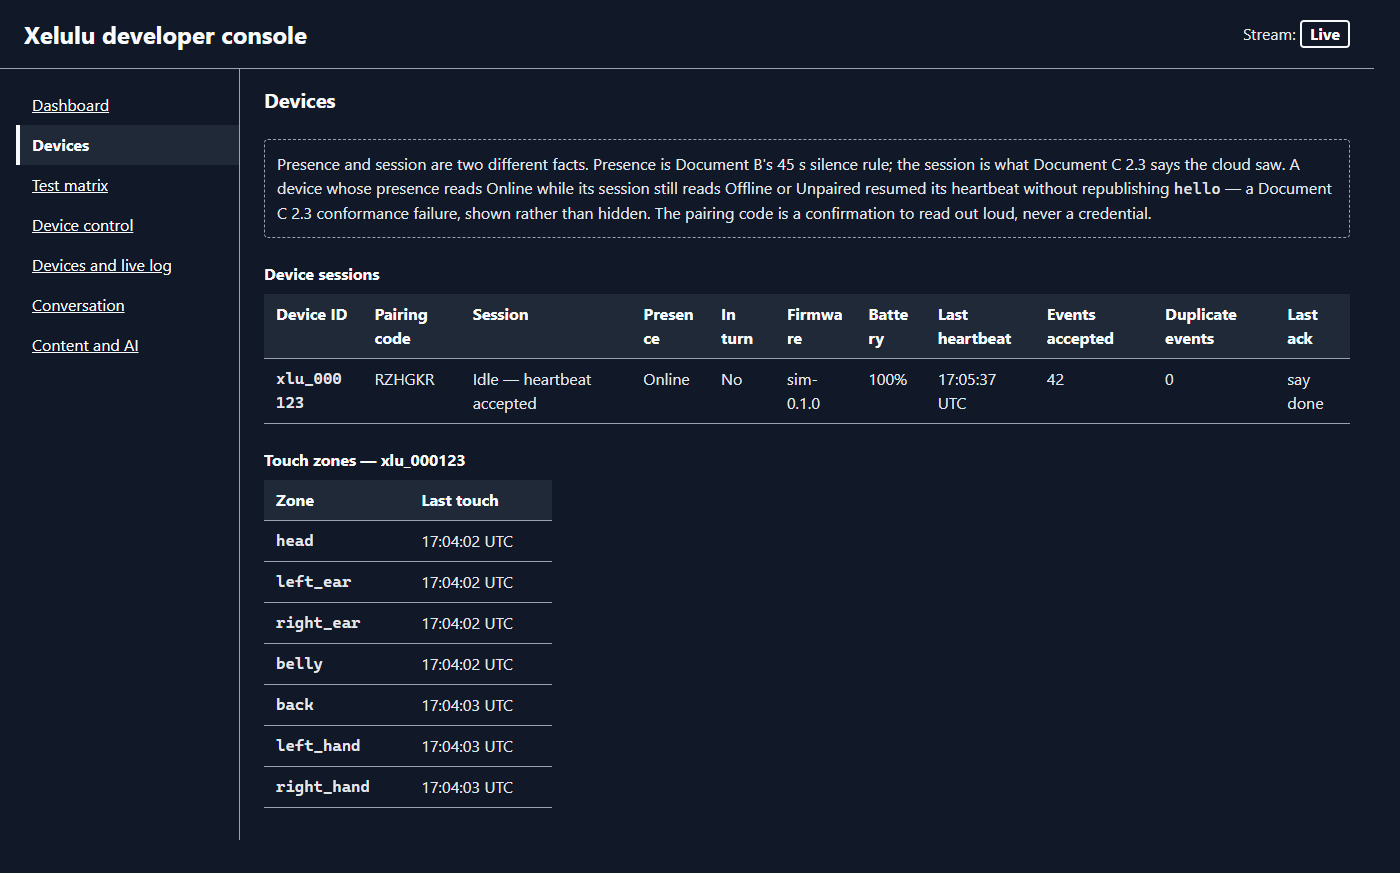
Xelulu_report_attachments_2026-11-01/05_devices_simulator.png
