verma-suraj/xelulu/Xelulu_report_attachments_2026-11-01/07_device_control.png

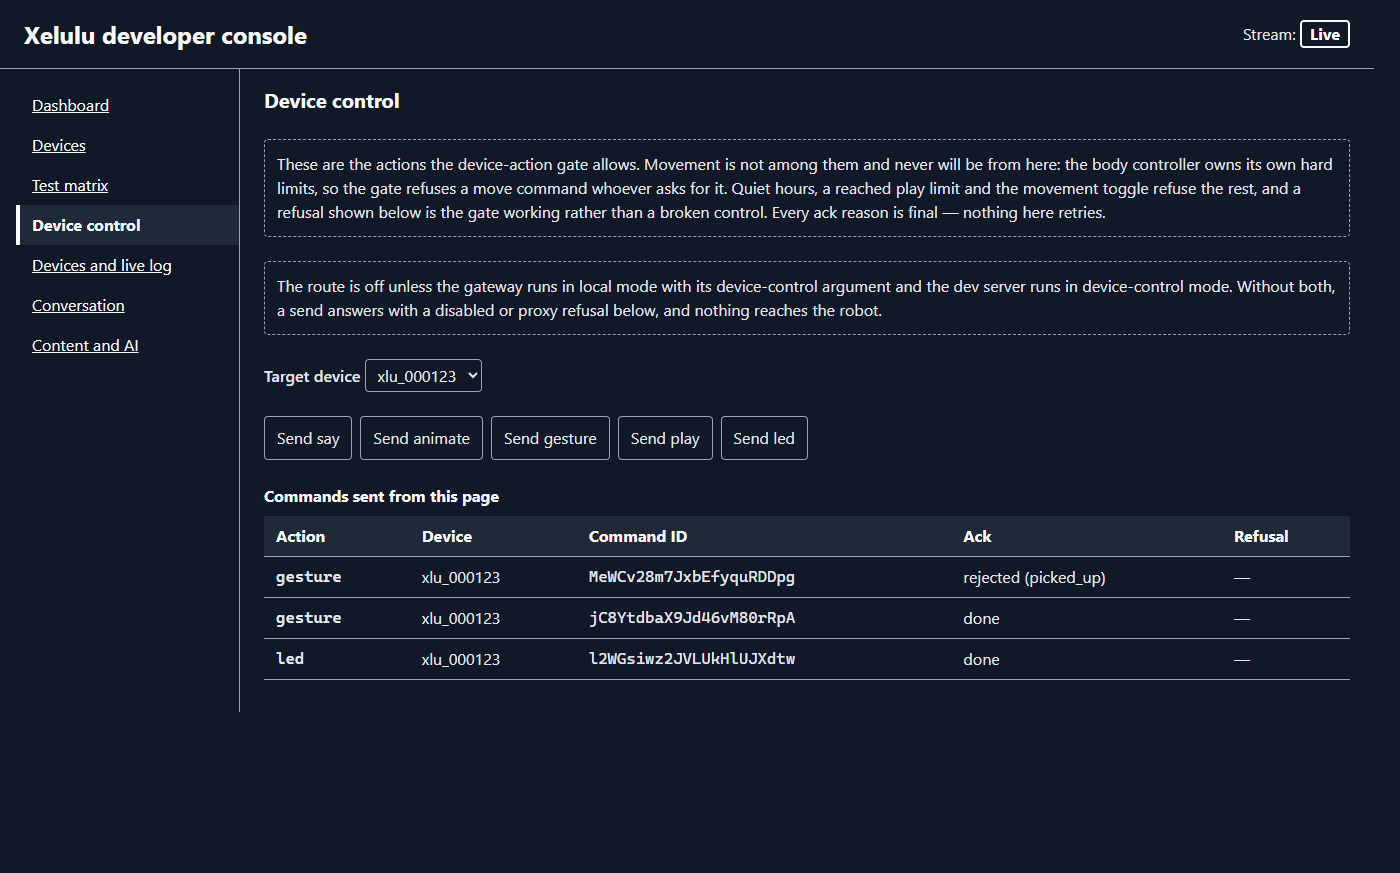
Xelulu_report_attachments_2026-11-01/07_device_control.png
