verma-suraj/xelulu/Xelulu_report_attachments_2026-11-01/08_conversation_text_hidden.png

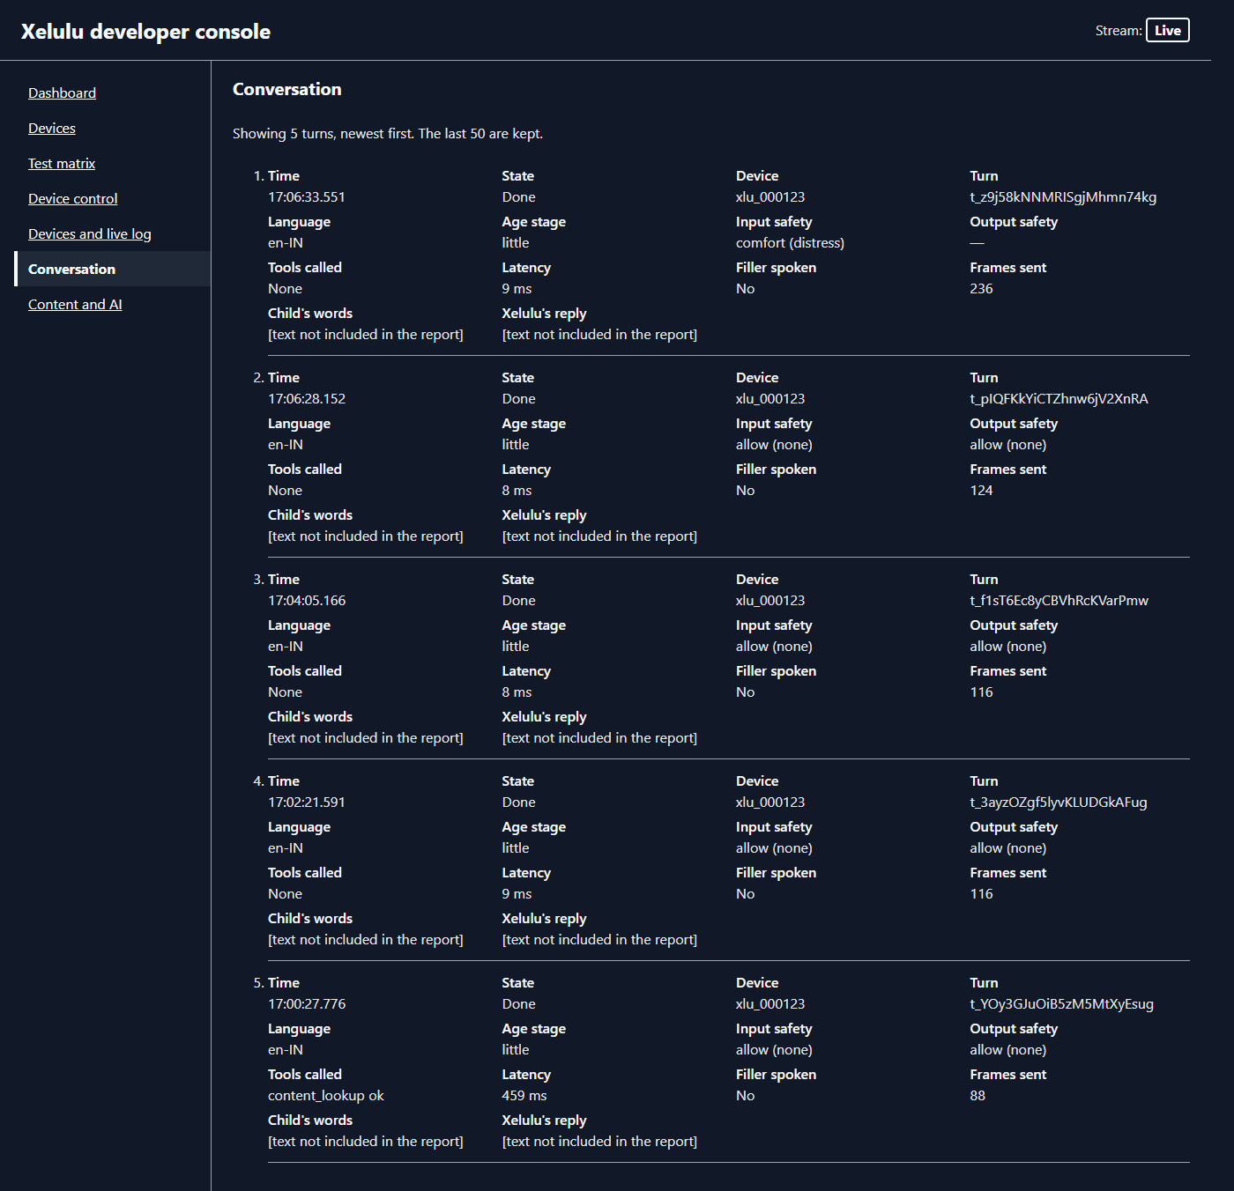
Xelulu_report_attachments_2026-11-01/08_conversation_text_hidden.png
