verma-suraj/xelulu/Xelulu_report_attachments_2026-11-01/10_content_guard_refused_draft.png

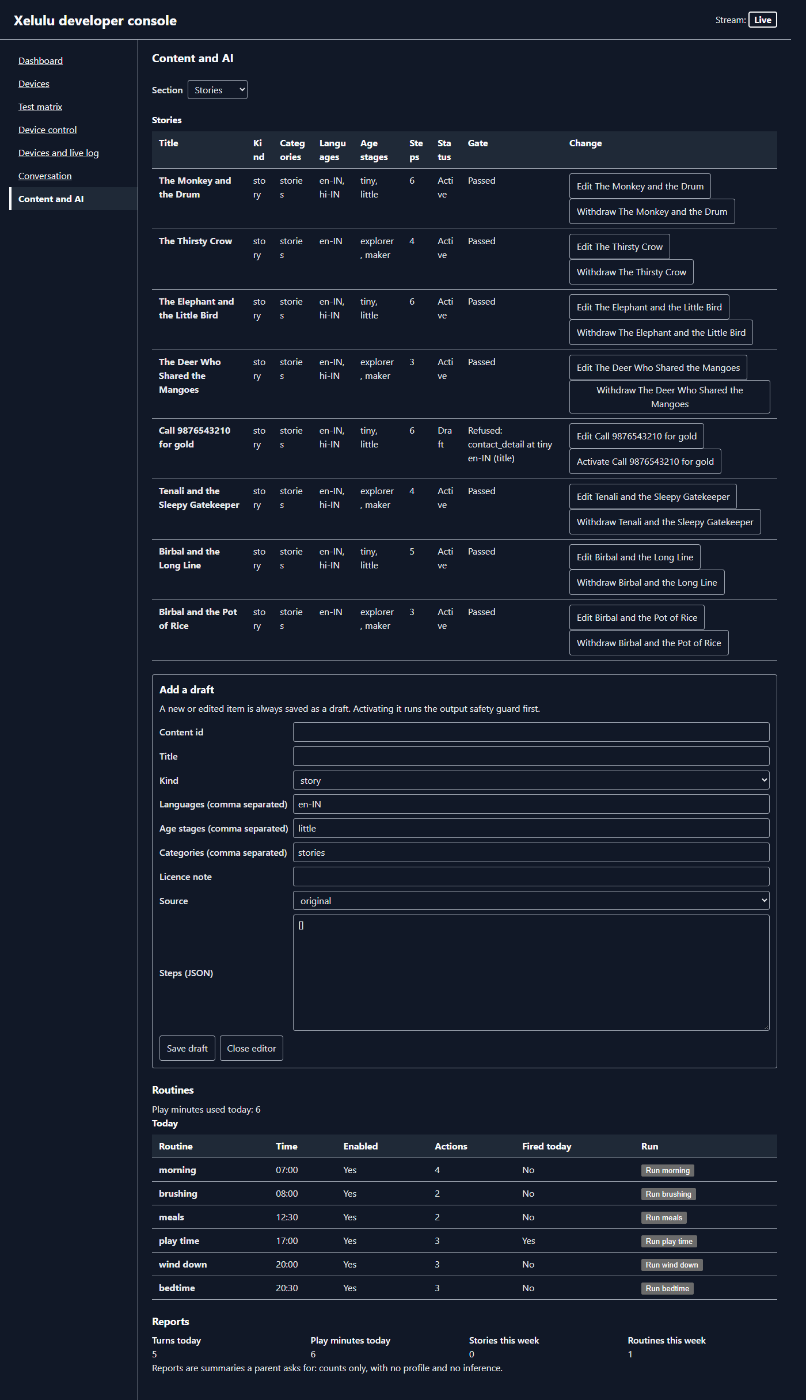
Xelulu_report_attachments_2026-11-01/10_content_guard_refused_draft.png
