verma-suraj/xelulu/Parth_BOM_ESP32S3.xlsx

Sheet: Parth BOM (ESP32-S3)
Parth - P0 BOM (ESP32-S3 cloud gateway, no camera)
Static desk companion. ESP32-S3 = gateway only (all AI in cloud). No camera. BT-Classic module handles phone calls (ESP is BLE-only). All parts IN STOCK across Robu + Robocraze, checked 14-Oct-2026 - re-confirm at order.
# | Category | Part | SKU | Qty | Unit Rs | Total Rs | Stock | Vendor | Use | Specs / notes | Buy link
1 | Gateway MCU | 7Semi ESP32-S3-DevBoardC-1 N8R8 (8MB flash + 8MB PSRAM) | - | 1 | 949 | 949 | In Stock | Robocraze | The gateway: Wi-Fi to cloud, drives the UART display + I2S audio, no local AI | ESP32-S3, 8MB flash, 8MB PSRAM, Wi-Fi + BLE, dual USB-C | Open link (https://robocraze.com/products/7semi-esp32-s3-dev-boardc-1-n8r8-wifi-bluetooth-dual-usb-c-rgb-led)
2 | Touch display | SmartElex 3.5in HMI Display, Resistive Touch, 320x480 (UART) | R213369 | 1 | 1419 | 1419 | In Stock | Robu | The glance screen + cards. Renders its own GUI from the micro-SD; the ESP drives it over a 4-pin UART (you design screens in the HMI tool). Offloads all graphics from the gateway. | 3.5in 320x480 RGB565, resistive touch, UART 115200, 5V, micro-SD, Type-C | Open link (https://robu.in/product/smartelex-basic-3-5-tft-hmi-display-with-resistive-touch/)
3 | Microphone | INMP441 I2S MEMS Microphone | - | 1 | 135 | 135 | In Stock | Robocraze | Voice capture -> streamed to cloud STT (wake word, commands, meeting notes) | I2S digital MEMS | Open link (https://robocraze.com/products/inmp441-mems-high-precision-omnidirectional-microphone-module-i2s)
4 | Speaker amp | SmartElex MAX98357A I2S Amplifier | R196218 | 1 | 194 | 194 | In Stock | Robu | Plays cloud TTS / briefings / music | I2S DAC+amp, up to 3.2W | Open link (https://robu.in/product/smartelex-i2s-audio-breakout-max98357a/)
5 | Speaker | 28mm 8 ohm Speaker (in a sealed shell cavity) | R262698 | 1 | 39 | 39 | In Stock | Robu | Audio out; loudness from amp + cavity | 28mm 8 ohm (a bigger driver gives better desk sound) | Open link (https://robu.in/product/0-5w-8ohm-trumpet-speaker-diameter-28mm/)
6 | BT calls module | Bluetooth Audio Board with USB/TF + Microphone (hands-free) | R263793 | 1 | 289 | 289 | In Stock | Robu | External BT-Classic module for phone-call audio - ESP32-S3 is BLE-only and cannot do HFP. Has an onboard mic for hands-free. CONFIRM it answers/ends calls (HFP); if not, use a BK8000L module (source externally). | BT-Classic audio + onboard mic, call buttons | Open link (https://robu.in/product/amplifier-bluetooth-board-audio-with-usb-tf-card-with-microphone/)
7 | Clock | DS3231 RTC Module (I2C, AT24C32) | 11496 | 1 | 125 | 125 | In Stock | Robu | Keeps time/alarms when offline | DS3231 I2C RTC + coin cell | Open link (https://robu.in/product/ds3231-rtc-module-precise-real-time-clock-i2c-at24c32/)
8 | Power | 5V 3A USB-C Power Supply (mains - static device) | - | 1 | 300 | 300 | Common | Robu / any | Mains powered desk device; feeds ESP32 (5V) + display + amp | 5V 3A USB-C adapter | Open link (https://robu.in/?s=5V+3A+usb+c+power+supply)
9 | Touch zones [OPTIONAL] | TTP223 Capacitive Touch Module x3 (head/base taps) | - | 3 | 35 | 105 | In Stock | Robu / any | Physical taps (wake, volume). Optional - the touch display covers most interaction | TTP223 digital-out, 3x GPIO | Open link (https://robu.in/?s=TTP223)
10 | Misc | Mic-mute switch + status LED + jumper wires | - | 1 | 80 | 80 | Common | Robu / any | Hardware mic-mute (privacy), status LED, inter-board wiring | Generic | Open link (https://robu.in/?s=jumper+wire)
 |  |  |  |  | Subtotal | 3530 |  |  | Excl [OPTIONAL] rows. Well under the Rs5000 budget target.

Sheet: Notes
Parth (ESP32-S3) - Notes & Scope
Role of the ESP32-S3 | Pure GATEWAY - no local AI. Streams mic audio to the cloud (STT->LLM->TTS), plays TTS back, and drives the HMI display. Same gateway contract as the Xelulu software spec.
Display | SmartElex 3.5in HMI (resistive touch, 320x480, UART). It is a smart display - it renders its own GUI from images on its micro-SD, and the ESP just sends values/commands over a 4-pin UART. This offloads all graphics from the gateway MCU and makes 'good graphics' easy (design screens in the HMI editor).
Two vendors | Parts split by live stock: ESP32-S3 (7Semi N8R8) + INMP441 from Robocraze (both OOS on Robu right now); display, amp, speaker, BT module, RTC from Robu. Re-confirm each at order - stock moves.
What this version does | Chief-of-staff (calendar/mail/tasks/research/drafting), briefings, glance screen + cards, meeting AUDIO notes, timers/reminders/lists, knowledge/translation, council, mentor, smart home (Matter-over-Wi-Fi), phone calls via the BT module.
What is DROPPED | Camera / webcam / video calls (no camera this version), on-camera auto-framing + posture/eye-contact coaching. Do video in the phone app, or move to an SBC build later.
Calls (BT module) | ESP32-S3 is BLE-only (no Bluetooth-Classic/HFP), so phone-call audio runs through the external BT module (onboard mic = hands-free). ESP controls it over UART and mutes its own audio during a call. CONFIRM the module supports HFP call answer/hang-up; if it is A2DP-only, swap for a BK8000L module (AliExpress/Amazon).
Smart home | Matter-over-Wi-Fi only (ESP32-S3 has no 802.15.4 Thread radio). Fine for P0.
Power | Mains-powered static device: 5V/3A USB-C supply. No battery. DS3231 keeps time offline.
MCU note | 7Semi board is N8R8 (8MB flash) vs the N16R8 we first spec'd - 8MB flash is plenty for a gateway (firmware only; content lives in the cloud and on the display's SD). 8MB PSRAM retained.
