verma-suraj/xelulu/Parth_BOM_ESP32S3_v4.xlsx

Sheet: Parth BOM (ESP32-S3)
Parth - P0 BOM (ESP32-S3 cloud gateway, battery-powered, no camera)
Static desk companion, BATTERY powered. ESP32-S3 = gateway only (all AI in cloud). No camera. BT-Classic module handles phone calls. v5 adds the HMI micro-SD (the display needs it to show anything), a 1S protection PCB + inline fuse for the Li-ion pack, and a CR2032 for the RTC. Every part verified on its product page and IN STOCK - except the N16R8 board (OOS on Robu+Robocraze; sourced from Graylogix - verify at checkout; verified N8R8 fallback included).
# | Category | Part | SKU | Qty | Unit Rs | Total Rs | Stock | Vendor | Use | Specs / notes | Buy link
1 | Gateway MCU | ESP32-S3-DevKitC-1 N16R8 (16MB flash + 8MB PSRAM) | - | 1 | 515 | 515 | In stock (listing) - verify at checkout | Graylogix | The gateway: Wi-Fi to cloud, drives the UART display + I2S audio. No local AI. | ESP32-S3 N16R8, 16MB flash, 8MB PSRAM, Wi-Fi+BLE. Robu + Robocraze are OOS for N16R8 - hence a 3rd vendor. | Open link (https://www.graylogix.in/product/node-mcu-esp32-s3-n16r8-devkit)
2 | Gateway MCU [VERIFIED FALLBACK] | 7Semi ESP32-S3-Dev-BoardC-1 N8R8 | - | 1 | 949 | 949 | In Stock (verified) | Robocraze | Use if N16R8 is unavailable: 8MB flash is plenty for a GATEWAY (no local AI - firmware only). | ESP32-S3 N8R8, 8MB flash + 8MB PSRAM, dual USB-C | Open link (https://robocraze.com/products/7semi-esp32-s3-dev-boardc-1-n8r8-wifi-bluetooth-dual-usb-c-rgb-led)
3 | Touch display | SmartElex 3.5in HMI Display, Resistive Touch, 320x480 (UART) | R213369 | 1 | 1419 | 1419 | In Stock | Robu | Glance screen + cards. Renders its own GUI from the micro-SD; the ESP drives it over a 4-pin UART. Offloads all graphics from the gateway. | 3.5in 320x480 RGB565, resistive touch, UART 115200, 5V 650mA, micro-SD, Type-C | Open link (https://robu.in/product/smartelex-basic-3-5-tft-hmi-display-with-resistive-touch/)
4 | MicroSD card | MicroSD Card 16GB Class 10 (for HMI GUI assets) | - | 1 | 199 | 199 | In Stock | Robu | REQUIRED by the SmartElex HMI - stores its GUI pages/images; the display loads them on power-up. Without this the screen has no UI. | 16GB Class 10, FAT32 | Open link (https://robu.in/?s=microsd+16gb+class+10)
5 | Microphone | INMP441 I2S MEMS Microphone | - | 1 | 135 | 135 | In Stock | Robocraze | Voice capture -> streamed to cloud STT (wake word, commands, meeting notes) | I2S digital MEMS | Open link (https://robocraze.com/products/inmp441-mems-high-precision-omnidirectional-microphone-module-i2s)
6 | Speaker amp | SmartElex MAX98357A I2S Amplifier | R196218 | 1 | 194 | 194 | In Stock | Robu | Plays cloud TTS / briefings / music | I2S DAC+amp, up to 3.2W | Open link (https://robu.in/product/smartelex-i2s-audio-breakout-max98357a/)
7 | Speaker | 30mm 8 ohm Speaker GSPK3005TN (with cable) | R256738 | 1 | 91 | 91 | In Stock | Robu | Audio out; loudness from amp + sealed cavity | 30mm 8 ohm, JST cable | Open link (https://robu.in/product/gspk3005tn-8r0-5w-l300s-2-54t/)
8 | BT calls module | Bluetooth Audio Board with USB/TF + Microphone (hands-free) | R263793 | 1 | 289 | 289 | In Stock | Robu | External BT-Classic module for phone-call audio - ESP32-S3 is BLE-only and cannot do HFP. Has an onboard mic. CONFIRM it answers/ends calls (HFP); else use a BK8000L module. | BT-Classic audio + onboard mic, call buttons | Open link (https://robu.in/product/amplifier-bluetooth-board-audio-with-usb-tf-card-with-microphone/)
9 | Clock | DS3231 RTC Module (without battery) | - | 1 | 209 | 209 | In Stock | Robocraze | Keeps time/alarms during a power cut (Wi-Fi NTP re-syncs on boot). | DS3231 I2C RTC | Open link (https://robocraze.com/products/ds3231-real-time-clock-module-for-raspberry-pi-without-battery)
10 | Clock backup | CR2032 3V Lithium Coin Cell (for DS3231) | - | 1 | 25 | 25 | In Stock | Robu | Backup for the RTC - keeps it ticking across power-offs and battery swaps | CR2032 3V lithium | Open link (https://robu.in/?s=cr2032)
11 | Battery (main power) | LG INR18650MJ1 3400mAh 18650 Li-Ion | 1098719 | 2 | 409 | 818 | In Stock | Robu | MAIN POWER. 2 cells in PARALLEL = 1S2P ~6800mAh (~4-5h runtime; the 3.5in backlight is the main drain). 1 cell = ~2h, cheaper. | 3.7V 3400mAh 18650 | Open link (https://robu.in/product/lg-18650-mj1-3400mah-3c-li-ion-battery/)
12 | Charge + 5V boost | 10W 5V Charge and Discharge Booster Module | R260472 | 1 | 459 | 459 | In Stock | Robu | Charges the 1S pack AND boosts to the stable 5V rail that runs the ESP + display + amp. Supports run-while-charging. | 5V output, 10W (~2A), charge + discharge | Open link (https://robu.in/product/10w-charge-and-discharge-booster-module-output-5v/)
13 | Charge port | USB Type-C Breakout (sink, with CC resistors) | R122667 | 1 | 99 | 99 | In Stock | Robu | Type-C charging socket feeding 5V into the charge+boost module | USB-C female, CC pulldowns for 5V sink | Open link (https://robu.in/product/usb-type-c-breakout-board-downstream-connection/)
14 | Battery holder | 2 x 18650 Cell Box with Wire (wire cells in PARALLEL = 1S2P) | R260089 | 1 | 89 | 89 | In Stock | Robu | Holds the 2 cells. Wire them in PARALLEL (both + together, both - together) for 1S2P. | 2x 18650, leaded | Open link (https://robu.in/product/2-x-18650-blm-cell-box-with-wire-without-cover-2/)
15 | Power switch | KCD1-8-101 Rocker Switch SPST (6A) | R133123 | 1 | 17 | 17 | In Stock | Robu | Main ON/OFF on the battery line | SPST, 6A rocker | Open link (https://robu.in/product/kcd1-8-101-rocker-switch-spst-2pinon-off/)
16 | Battery protection | 1S Li-ion Protection PCB (DW01A + 8205A, 3A) | - | 1 | 30 | 30 | In Stock | Robu | In series between the 1S2P pack and the booster. Raises the discharge cutoff to a cell-friendly ~2.75-2.9V (the IP5306 inside the booster cuts out around 2.5V, which shortens cell life). Protects the LG MJ1 pack from over-discharge and short-circuit. | 1S, 3A continuous, DW01A+8205A | Open link (https://robu.in/?s=1s+li-ion+protection+board)
17 | Safety fuse | 2A Inline Fuse + Holder (on the battery line) | - | 1 | 35 | 35 | In Stock | Robu | Hard short-circuit protection on the pack. 1S2P LG MJ1 cells can dump >20A into a dead short - the protection PCB trips first, this is backup. | 2-3A automotive mini blade or 5x20mm + inline holder | Open link (https://robu.in/?s=fuse+holder+inline)
18 | Touch zones [OPTIONAL] | TTP223 Capacitive Touch Module x3 (head/base taps) | - | 3 | 35 | 105 | In Stock | Robu | Physical taps (wake, volume). Optional - the touch display covers most interaction. | TTP223 digital-out, 3x GPIO | Open link (https://robu.in/?s=TTP223)
19 | Misc | Mic-mute switch + status LED + jumper wires | - | 1 | 80 | 80 | Common | Robu | Hardware mic-mute (privacy), status LED, inter-board wiring | Generic | Open link (https://robu.in/?s=jumper+wire)
 |  |  |  |  | Subtotal | 4703 |  |  | Excl [OPTIONAL]/[FALLBACK] rows. Under the Rs5000 budget.

Sheet: Notes
Parth (ESP32-S3) - Notes & Scope
N16R8 availability | N16R8 dev boards are OUT OF STOCK on Robu, Robocraze, Probots and Compoindia right now (each checked on its product page). They are listed at Graylogix (Rs515) and Amazon (ROBOTICSSIGN ~Rs1190) - the sheet uses Graylogix; verify stock at checkout. If you cannot get N16R8, the 7Semi N8R8 (Robocraze, verified in stock, Rs949) is a drop-in: for a pure GATEWAY (no local AI) 8MB flash is plenty - the extra flash of N16R8 is only useful for local models/assets, which this device does not run.
Power - battery (your change) | Main power is a 1S2P 18650 pack (2x LG MJ1 in PARALLEL = 3.7V ~6800mAh). The 10W Charge+Discharge module charges the pack (via the Type-C port) AND boosts to the 5V rail for the ESP + display + amp. No wall adapter. Runtime ~4-5h (the 3.5in backlight dominates); drop to 1 cell for ~2h and lower cost, or add cells for more.
Battery protection (v5) | Added a 1S protection PCB (DW01A+8205A) in SERIES between the pack and the booster, plus an inline 2A fuse. Why: the IP5306 inside the booster module has built-in 1S protection, but its over-discharge cutoff sits around ~2.5V - too low for cell health. The protection PCB raises the cutoff to ~2.75-2.9V and acts as a hard short-circuit cut-off. Wire order: pack B+ -> fuse -> PCB(B+) ... PCB(P+) -> switch -> booster(BAT+). Pack B- -> PCB(B-), PCB(P-) -> booster(BAT-).
HMI micro-SD (v5) | The SmartElex 3.5in HMI is a smart display: its GUI pages/images live on its own micro-SD card and it loads them on power-up. The display will not show anything without the card. 16GB Class 10 FAT32 is standard.
Role of the ESP32-S3 | Pure GATEWAY - no local AI. Streams mic audio to the cloud (STT->LLM->TTS), plays TTS back, and drives the HMI display over UART. Same gateway contract as the Xelulu software spec.
Display | SmartElex 3.5in HMI (resistive touch, 320x480, UART). A smart display - it renders its own GUI from images on its micro-SD, and the ESP just sends values over a 4-pin UART. Offloads all graphics from the gateway and makes good-looking screens easy (design them in the HMI editor).
What this version does | Chief-of-staff (calendar/mail/tasks/research/drafting), briefings, glance screen + cards, meeting AUDIO notes, timers/reminders/lists, knowledge/translation, council, mentor, smart home (Matter-over-Wi-Fi), phone calls via the BT module.
What is DROPPED | Camera / webcam / video calls (no camera this version), on-camera auto-framing + posture/eye-contact coaching. Do video in the phone app, or move to an SBC build later.
Calls (BT module) | ESP32-S3 is BLE-only (no Bluetooth-Classic/HFP). The external BT module (onboard mic = hands-free) handles phone-call audio; the ESP controls it over UART. CONFIRM it supports HFP (answer/hang-up); if A2DP-only, swap for a BK8000L module.
Two+ vendors | Split by live stock: ESP32-S3 N16R8 from Graylogix; mic + RTC from Robocraze; display, amp, speaker, BT module, battery, power, switch from Robu. Re-confirm each at order - stock moves fast.
