verma-suraj/xelulu/Xelulu_BOM_OOS_Replacements.xlsx

Xelulu - Out-of-Stock Items & In-Stock Replacements
In-stock replacements for the 5 OOS parts + a perf board. All verified on their Robu product pages 05-Oct-2026. [ROUND ALT]/[TRIAL ALT] rows are optional (not in the subtotal). Re-confirm at order - Robu stock churns fast.
# | Replaces (OOS item) | OOS SKU | In-stock replacement | SKU | Qty | Unit Rs | Total Rs | Stock | Notes | Buy link
1 | Face display (2.1in round) | R123199 | SmartElex 2 inch IPS TFT LCD 240x320 SPI (ST7789P3) | R257748 | 1 | 909 | 909 | In Stock | Bigger, rectangular - mounts behind the visor mask. RECOMMENDED replacement. | Open link (https://robu.in/product/smartelex-2-inch-ips-tft-lcd-module/)
2 | Face display (round option) | R123199 | GoldenMorning GC9A01 1.28in ROUND 240x240 SPI [ROUND ALT] | R123209 | 1 | 509 | 509 | In Stock | Use only if you want an actual round display - but small (32mm). | Open link (https://robu.in/product/goldenmorning-gc9a01-7p-240x240-spi-1-28-inch-round-display-module/)
3 | ToF sensor (VL53L0X) | 699621 | GY-53 VL53L0X Laser ToF Distance Sensor | 130217 | 4 | 579 | 2316 | In Stock | Same VL53L0X chip, I2C (2 front + 2 cliff). Bigger/pricier than the compact one but in stock. | Open link (https://robu.in/product/gy-53-vl53l0x-laser-tof-flight-time-ranging-sensor-module-serial-port-pwm-output/)
4 | I2S microphone (INMP441) | 975775 | GY-SPH0645LM4H I2S MEMS Microphone | R263799 | 2 | 539 | 1078 | In Stock | I2S digital MEMS, dual mic. Note: SPH0645 is left-justified I2S = a one-line config change vs INMP441. | Open link (https://robu.in/product/gy-sph0645lm4h-i2s-digital-audio-interfaces-mems-microphone-sensor/)
5 | Speaker (D57 57mm) | R266499 | 28mm 8 ohm Trumpet Speaker | R262698 | 1 | 39 | 39 | In Stock | Compact driver; loudness from the amp + a sealed shell cavity. | Open link (https://robu.in/product/0-5w-8ohm-trumpet-speaker-diameter-28mm/)
6 | Speaker (louder option) | R266499 | GSPK3005TN 30mm 8 ohm Speaker (w/ cable) [TRIAL ALT] | R256738 | 1 | 91 | 91 | In Stock | 2nd driver to trial for a bit more volume. | Open link (https://robu.in/product/gspk3005tn-8r0-5w-l300s-2-54t/)
7 | Servo bus buffer (74HC125) | R186666 | 1k Resistor (replaces the buffer) - 74HC125 optional when restocked | (1k res) | 1 | 10 | 10 | In Stock (resistor) | The 74HC125 is OPTIONAL: a 1k resistor does the half-duplex job (ESP32 TX ->1k-> servo signal, signal -> RX). All 74HC125 variants are OOS on Robu now; source 74HC125/74LVC125 later or from another vendor. | Open link (https://robu.in/?s=74HC125)
8 | Perf board (for assembly) | (new) | 7 x 9 cm Universal PCB Prototype Board (double-sided) | 44231 | 1 | 59 | 59 | In Stock | To mount/solder the modules together for the build. | Open link (https://robu.in/product/79-cm-universal-pcb-prototype-board-double-sided/)
 |  |  |  |  |  | Subtotal | 4411 |  | Primary replacements only (ex [ROUND ALT]/[TRIAL ALT]).
