verma-suraj/xelulu/Xelulu_BOM_v5_2S.xlsx

Sheet: Xelulu BOM
Xelulu - Hardware Bill of Materials (BOM)
P0 prototype - mostly Robu.in; servo controller (FE-URT-1) from Evelta.in. 2S (7.4V) power. Stock checked 05-Oct-2026 (Robu stock moves fast - re-confirm at order). Prices incl. GST, approx.
# | Category | Component / Part (buyable name) | SKU | Qty | Unit Rs | Total Rs | Stock (05 Oct 26) | Use in Xelulu | Key specs | Interface / pins | Buy link | Vendor
1 | Compute | ESP32-S3 Devkit (ESP32-S3-WROOM-1 N16R8, 16MB Flash + 8MB PSRAM) | R263505 | 1 | 839 | 839 | Listed in stock (product page had a site error - re-check at order) | Brain: face animation, audio, wake word, motion, Wi-Fi/BLE | Dual-core LX7 240MHz, 512KB SRAM, 8MB PSRAM, 16MB flash, Wi-Fi4+BLE5 | USB-UART; drives all buses | Open link (https://robu.in/product/esp32-s3-devkit-esp32-s3-wroom-1-n16r8/) | Robu.in
2 | Compute | uEDesign uES3 ESP32-S3 WROOM1 N16R8 Dev Board | R264648 | 1 | 720 | 720 | In Stock | Drop-in backup if the Espressif devkit is unavailable | Same ESP32-S3-WROOM-1 N16R8 | USB-UART | Open link (https://robu.in/product/uedesign-ues3-esp32-s3-wroom1-n16r8-microcontroller-development-board/) | Robu.in
3 | Display | SmartElex 2 inch IPS TFT LCD 240x320 SPI (ST7789P3) | R257748 | 1 | 909 | 909 | In Stock | The face / all expressions, mounted behind the dark visor mask. IPS = wide angle; eye-safety in driver (see Notes) | 2.0in IPS, 240x320, ST7789P3, 400cd/m2, 4-wire SPI | SPI (SCLK,MOSI,CS,DC,RST,BL) | Open link (https://robu.in/product/smartelex-2-inch-ips-tft-lcd-module/) | Robu.in
4 | Display | GoldenMorning 2.1 inch Round IPS 480x480 SPI / DWIN 2.1in round | R123199 | 1 | 1969 | 1969 | Out of Stock (buy when restocked) | Preferred round face look; currently OOS everywhere. SmartElex 2in is the in-stock stand-in | 2.1in round IPS 480x480 | SPI (GoldenMorning) / UART (DWIN DGUS) | Open link (https://robu.in/product/goldenmorning-round-circle-tft-screen-display-480x480-spi-2-1-inch-round-tft-lcd-display/) | Robu.in
5 | Drive | N20 6V 200RPM Micro Metal Gear Motor With Encoder | 476696 | 2 | 589 | 1178 | In Stock | Two driven wheels (differential drive) + odometry | 6V 200RPM, metal gearbox, quadrature encoder | TB6612 PWM + encoder A/B (PCNT) | Open link (https://robu.in/product/n20-6v-200rpm-micro-metal-gear-motor-with-encoder/) | Robu.in
6 | Drive | 34mm Mini Car N20 Motor Rubber Small Wheel | 699504 | 2 | 59 | 118 | In Stock | Wheels for the two N20 drive motors | 34mm rubber tyre, N20 D-shaft | Mechanical | Open link (https://robu.in/product/34mm-mini-car-n20-motor-wheel-rubber-small-wheel/) | Robu.in
7 | Drive | MINI 3PI Car N20 Caster Robot Ball Wheel | 62858 | 2 | 39 | 78 | In Stock | Two casters for stability (front + rear) | Small N20 ball caster | Mechanical (passive) | Open link (https://robu.in/product/mini-3pi-car-n20-caster-robot-ball-wheel/) | Robu.in
8 | Drive | Motor Driver TB6612FNG Module (Ultra Small) | 43846 | 1 | 149 | 149 | In Stock | Drives the two N20 drive motors (efficient MOSFET H-bridge) | TB6612FNG, 1.2A cont / 3.2A peak per ch, 2.5-13.5V | PWMA/AIN1/AIN2 + PWMB/BIN1/BIN2 + STBY | Open link (https://robu.in/product/motor-driver-tb6612fng-module-performance-ultra-small-volume-3-pi-matching-performance-ultra-l298n/) | Robu.in
9 | Actuators | Waveshare SC09 2.3kg Dual-axis Serial Bus Servo, Two-way Feedback | 1592663 | 3 | 1088 | 3264 | In Stock | Head pan (1) + two arms (2); precise closed-loop angle control. All 3 share ONE serial bus | 4.8-8.4V (runs at 5V), angle 300deg/1024 (~0.29deg), position+load feedback | Serial bus (half-duplex, daisy-chained) | Open link (https://robu.in/product/waveshare-2-3kg-dual-axis-serial-bus-servo/) | Robu.in
10 | Actuators | SN74HC125N buffer (or just a 1k resistor) - ESP32 UART to the servo bus | R186666 | 1 | 130 | 130 | In Stock | No controller module needed in the robot. The SC09 bus is half-duplex: ESP32 TX -> 1k resistor -> servo signal wire, servo signal -> ESP32 RX, and power the servos from the 5V/6V rail. A 74HC125 buffer makes it cleaner/more robust. Assign each servo a unique bus ID once (from the ESP32, or the optional FE-URT-1). | SN74HC125N DIP-14 (or 1k resistor); ESP32 half-duplex UART | ESP32 UART <-> servo bus | Open link (https://robu.in/product/sn74hc125n-texas-instruments-buffer-74hc125-2-v-to-6-v-dip-14/) | Robu.in
11 | Actuators | Feetech FE-URT-1 (USB bus programmer - PC setup/ID-assignment only) | FE-URT-1 | 1 | 1160 | 1160 | Evelta.in - optional | OPTIONAL bench tool: easiest way to assign servo IDs + test from a PC before assembly. NOT needed in the robot - the ESP32 can set IDs and drive the bus directly. | Feetech FE-URT-1, 4.8-25V, USB+TTL | PC <-> servo bus (setup only) | Open link (https://evelta.com/feetech/) | Evelta.in
12 | Sensing | VL53L0X TOF Laser Distance Sensor (compact ~25x13mm) | 699621 | 4 | 119 | 476 | In Stock | 2x front (collision, come-to-me, stop at 30cm) + 2x downward (cliff/edge) | VL53L0X, ~30-2000mm, I2C, small | I2C (all 4 via TCA9548A mux) | Open link (https://robu.in/product/vl53l0x-tof-based-lidar-laser-distance-sensor/) | Robu.in
13 | Sensing | CJMCU TCA9548A I2C 8-Channel Multiplexer | 421239 | 1 | 79 | 79 | In Stock | Lets the 4 identical ToF sensors share one I2C bus | 8-channel I2C switch, 5V tolerant | I2C | Open link (https://robu.in/product/cjmcu-tca9548a-i2c-8-channel-multiple-extensions-development-board/) | Robu.in
14 | Sensing | GY-87 (MPU6050) 10DOF Sensor Module | 12038 | 1 | 459 | 459 | In Stock | Tilt + shake + pickup/hug + fall detection | MPU6050 accel+gyro (GY-87 adds mag+baro), I2C | I2C | Open link (https://robu.in/product/mpu6050hmc5883lbmp180-10dof-3-axis-gyro-3-axis-acceleration-3-axis-magnetic-field-air-pres/) | Robu.in
15 | Sensing | Adafruit MPR121 12-Key Capacitive Touch (I2C) | R176053 | 1 | 1389 | 1389 | In Stock | All 5 touch zones (head, back, belly, 2 hands) via one I2C chip | 12 electrodes, I2C | I2C + IRQ | Open link (https://robu.in/product/adafruit-capacitive-touch-sensor-breakout-mpr121/) | Robu.in
16 | Sensing | TTP223 Capacitive Touch Module x5 (one per zone) | (common) | 5 | 35 | 175 | In Stock (ubiquitous) | Cheaper touch: 5 single-zone modules instead of MPR121; uses 5 GPIO | TTP223, digital out, 2.0-5.5V | 5x GPIO | Open link (https://robu.in/?s=TTP223) | Robu.in
17 | Audio | INMP441 MEMS Omnidirectional Microphone Module (I2S) | 975775 | 2 | 149 | 298 | In Stock | Dual mic: wake word + sound-direction for 'come to me' | I2S digital MEMS | I2S-RX (shared bus, L/R) | Open link (https://robu.in/product/inmp441-mems-high-precision-omnidirectional-microphone-module-i2s/) | Robu.in
18 | Audio | SmartElex I2S Audio Breakout - MAX98357A | R196218 | 1 | 194 | 194 | In Stock | Drives the speaker: voice, songs, stories, SFX | I2S DAC+amp, up to ~3.2W | I2S-TX | Open link (https://robu.in/product/smartelex-i2s-audio-breakout-max98357a/) | Robu.in
19 | Audio | 28mm 8 ohm Trumpet Speaker | R262698 | 1 | 39 | 39 | In Stock | Loudness from amp (up to 3.2W) + sealed back-cavity in the shell (laptop trick) | 28mm round, 8 ohm | Analog (from amp) | Open link (https://robu.in/product/0-5w-8ohm-trumpet-speaker-diameter-28mm/) | Robu.in
20 | Audio | GSPK3005TN 30mm 8 ohm Round Speaker (w/ cable) | R256738 | 1 | 91 | 91 | In Stock | 2nd option for sound trials | 30mm round, 8 ohm, 85dB, JST cable | Analog (from amp) | Open link (https://robu.in/product/gspk3005tn-8r0-5w-l300s-2-54t/) | Robu.in
21 | Audio | D57 57mm 8 ohm 92dB Round Speaker | R266499 | 1 | 116 | 116 | Out of Stock (restock) | 3rd option - highest sensitivity (92dB) if more volume needed | 57mm round, 8 ohm, 92dB | Analog (from amp) | Open link (https://robu.in/product/d57h13mm-8-ohm-05w-92plus-minus3db-round-speaker/) | Robu.in
22 | Storage | DFRobot Fermion MicroSD Card Module | R123771 | 1 | 499 | 499 | In Stock | Holds the offline cached library (30 songs + 30 stories, animations) | SPI microSD breakout | SPI (shared, own CS) | Open link (https://robu.in/product/dfrobot-fermion-microsd-card-module-for-arduino-breakout/) | Robu.in
23 | Power | Type-C to 2S 8.4V 4A Booster Charger Module | 1794301 | 1 | 329 | 329 | In Stock | Charges the 2S pack from any 5V Type-C charger (boosts 5V to 8.4V, 4A CC/CV). Charge while off/idle. | Type-C in, 8.4V 4A out, for 2S | Type-C -> battery | Open link (https://robu.in/product/18650-polymer-lithium-ion-charger-type-c-to-2s-8-4v-4a-booster-module/) | Robu.in
24 | Power | 2S 20A 18650 Lithium Battery Protection Board (BMS) | 618338 | 1 | 149 | 149 | In Stock | Protects the series pack: over-charge / over-discharge / short-circuit (balance optional with matched cells) | 2S, 20A, 7.4/8.4V | Across the 2S pack | Open link (https://robu.in/product/2s-20a-18650-lithium-battery-protection-board/) | Robu.in
25 | Power | XY-3606 DC-DC Buck Converter 5V 5A (7-30V in) | 975683 | 1 | 139 | 139 | In Stock | Steps 2S (7.4-8.4V) down to the 5V rail for display, amp, motors (TB6612), servos (SC09 @5V, within 4.8-8.4V) and logic. 5A = sufficient current (fixes the 2A concern) | 5V out, 5A, DC-DC buck | 2S -> 5V rail | Open link (https://robu.in/product/24v-12v-to-5v-5a-power-module-dc-dc-xy-3606-power-converter/) | Robu.in
26 | Power | AMS1117-3.3 LDO Module (5V -> 3.3V, 800mA) | 28373 | 1 | 19 | 19 | In Stock | Clean 3.3V rail for sensors/display logic (keeps the ESP32 board's own LDO unloaded) | AMS1117-3.3, 5V->3.3V, up to 800mA | 3.3V rail | Open link (https://robu.in/product/ams1117-3-3v-power-supply-module/) | Robu.in
27 | Power | LG INR18650MJ1 3400mAh Li-Ion 3.6V | 1098719 | 2 | 409 | 818 | In Stock | 2 cells in SERIES = 2S 7.4V ~3400mAh (~25Wh), ~6-8h. For LONGER life use 4 cells (2S2P, ~6800mAh, ~12-16h) | 3.6V 3400mAh 18650, ~12.2Wh each | Battery (2S series) | Open link (https://robu.in/product/lg-18650-mj1-3400mah-3c-li-ion-battery/) | Robu.in
28 | Power | KCD1-8-101 Rocker Switch SPST (6A) | R133123 | 1 | 17 | 17 | In Stock | Main ON/OFF on the battery line (breaks battery->system) | SPST, 6A rating, panel-mount rocker | Battery line | Open link (https://robu.in/product/kcd1-8-101-rocker-switch-spst-2pinon-off/) | Robu.in
29 | Consumables | 2 x 18650 Cell Box with Wire (SERIES = 2S) | R260089 | 1 | 89 | 89 | Verify at order | Holds the 2 cells in series for 2S (a standard 2-slot holder IS series - correct here). BMS solders across the pack. | 2x 18650, leaded | Battery (2S) | Open link (https://robu.in/product/2-x-18650-blm-cell-box-with-wire-without-cover-2/) | Robu.in
30 | Consumables | Dupont Jumper Wire 40pc sets - F-F + M-F + M-M (3 sets) | 7449 | 3 | 60 | 180 | Verify at order | Signal/prototype connections between the boards | 20cm, 2.54mm, 40pin each | Wiring | Open link (https://robu.in/product/20cm-dupont-wire-color-jumper-cable-2-54mm-1p-1p-female-female-40pcs/) | Robu.in
31 | Consumables | 24AWG 2-Core Silicone Wire (Red-Black) | R164423 | 1 | 99 | 99 | Verify at order | Battery / motor / 5V power runs (flexible, heat-resistant) | 24AWG, 2-core, silicone, 600V | Power wiring | Open link (https://robu.in/product/24awg-multicore-insulated-cable2-cores-silicone/) | Robu.in
32 | Consumables | 127pc Black Heat Shrink Tube Assortment Kit | R267290 | 1 | 146 | 146 | Verify at order | Insulate solder joints / battery + motor wires | Assorted diameters | Wiring | Open link (https://robu.in/product/127pcs-black-heat-shrinkable-tube-kit-plastic-bag/) | Robu.in
33 | Consumables | Solder Wire 0.5mm 50g (+ get rosin flux) | 51943 | 1 | 289 | 289 | Verify at order | Soldering the amp/display/switch/speaker/BMS/headers | 0.5mm, 50g | Assembly | Open link (https://robu.in/product/solder-wire-0-5mm-50g-b-type-35-tin-content/) | Robu.in
34 | Consumables | 460pc JST XH2.54 Connector Kit (2/3/4-pin) | R256633 | 1 | 329 | 329 | Verify at order | Detachable plugs for battery, motors, servos, display | JST-XH 2.54mm, 2/3/4P housings + crimps | Wiring | Open link (https://robu.in/product/460pcs-jst-xh2-54mm-2-3-4p-connector-terminal-kit/) | Robu.in
35 | Consumables | Double-sided foam tape + zip ties + M2 screws/standoffs (assorted) | - | 1 | 200 | 200 | Buy locally / any vendor | Mounting boards/motors/display inside the shell; strain relief | Assorted | Mechanical | Open link (https://robu.in/?s=m2+standoff) | Local/any
 |  |  |  |  | Subtotal (1 unit) | 12901 |  | Primary parts only (ex BACKUP/UPGRADE/ALT/TRIAL rows). Includes consumables. 2S power + FE-URT-1 servo controller.

Sheet: Notes & Decisions
Xelulu BOM - Notes, Power Plan & Open Decisions
Architecture | One ESP32-S3 runs everything. Conversation/STT/TTS are cloud-streamed, so no Linux SoC needed - compact, cheap, low-power. On-device: wake word (ESP-SR), cry detection, 60fps sprite face (LVGL), audio, motion.
Servos - no controller needed | You do NOT need a controller module in the robot. The SC09 is a half-duplex serial-bus servo: wire ESP32 TX -> 1k resistor -> servo signal, servo signal -> ESP32 RX, power servos from the 5V/6V rail, chain all 3 on the one bus. A 74HC125 buffer (Rs130) makes it cleaner. Each servo needs a unique bus ID (1/2/3) - set once from the ESP32, or more easily with the OPTIONAL Feetech FE-URT-1 (Evelta, ~Rs1160) + Feetech PC software. The FE-URT-1 is a bench convenience, not a build part.
Touch sensitivity - configurable | Yes: the MPR121 is an I2C controller with PER-ZONE programmable touch/release thresholds, filtering and baseline tracking - tune each pad in firmware (e.g. head vs belly vs hands, or for different shell thickness). That tunability is why it beats the simpler TTP223 (sensitivity fixed by a hardware capacitor).
Power - 2S recommended (why) | Recommend 2S (7.4V), not 1S. Everything runs off a 5V rail at ~3-5A peak (audio+motors+servos+display together). A BUCK from 7.4V delivers that cleanly/efficiently; a BOOST from 1S (3.7V) at the same current runs hot, sags, and injects noise into the audio/sensor rail (bad with a speaker on the same supply), and pulls ~5A from the cell to make 3A at 5V. 2S + buck = cleaner, lower-worry. (1S2P + a 5V 5A boost is possible for fewest parts, but it's the weaker rail.)
Power rails - 2S build | 2x LG MJ1 in SERIES = 7.4V + a 2S BMS. A 5V/5A buck (XY-3606) feeds display, amp, microSD, motors (TB6612) and servos (SC09 runs fine at 5V, within 4.8-8.4V); AMS1117-3.3 makes 3.3V for sensors. 5A at 5V fixes the earlier 2A shortfall. Want servos/motors stronger? Add a 6V buck off the 2S.
Charging (2S, Type-C) | Type-C -> 2S 8.4V 4A Booster Charger: plug any 5V Type-C charger, it boosts to 8.4V and CC/CV-charges the 2S pack at up to 4A. Charges while the robot is off/idle (fine for the bedtime 'plug me in'). The old 1S '5V charge+boost' idea is dropped - it could not supply enough current for 2S.
Consumables (build end-to-end) | Added: 18650 2-cell holder (SERIES = 2S), Dupont jumpers (F-F/M-F/M-M), 24AWG silicone power wire, heat-shrink kit, solder (+flux), JST-XH connector kit, and mounting misc (foam tape/zip ties/M2 standoffs). You'll also want a soldering iron, wire stripper/cutter and a small screwdriver set (tools, not in BOM). Consumable prices are approximate - these are generic and widely stocked.
Switches (you asked) | Main power = KCD1 SPST rocker (6A) on the battery line (hard ON/OFF). The ESP32 devkit already has EN(reset) + BOOT buttons for programming. Touch-to-talk uses the belly touch zone, so no separate talk button is needed.
Battery life | 2x LG MJ1 3400mAh in 1S2P = ~6800mAh (~24.5Wh). Mixed bursty play avg ~3.5-4.5W -> ~6-8h; idle much longer. Add a 3rd cell (1S3P ~10200mAh) for more. Needs a 2-slot 18650 holder (add in CAD).
Servo = best angle control | SC09 serial-bus servo: closed-loop, 300deg/1024 (~0.29deg) accuracy, position+load feedback, 4.8-8.4V (runs at 5V). Quiet (not silent-silent); angle control is excellent and torque is plenty for light arms/head.
Display + eye safety | 2.0in IPS (ST7789) behind the dark visor - good graphics, wide viewing angle. The round 2.1in 480x480 (nicer face) is OOS everywhere right now; buy when restocked. Eye-safety is in OUR driver: (1) flicker-free backlight (constant DC or >20kHz PWM); (2) brightness capped + auto-dim; (3) warm/low-blue gentle palette; (4) no flashing 3-30Hz.
Speaker (small + loud) | 3 drivers listed for trials (28mm in stock, 30mm in stock, 57mm/92dB on restock). Real loudness = MAX98357 amp (up to 3.2W) + a SEALED back-cavity printed into the shell (how laptops get loud from tiny drivers). Pick the one that sounds best in the enclosure.
Touch | Primary = Adafruit MPR121 (1 I2C chip, all 5 zones) - the cheap MPR121 clones were all OOS, so this is the in-stock single-chip option (Rs1389). Cheap alt = 5x TTP223 modules (~Rs35 each, ubiquitous) using 5 GPIO - swap in to cut cost.
Stock reality | Robu's stock moves fast and its search listings are NOT reliable for stock - every part here was checked on its product page on 05-Oct-2026. Re-confirm the cart when you actually order; OOS rows (orange) have in-stock stand-ins already chosen as the primary.
I2C bus (shared) | IMU + MPR121 touch + TCA9548A (-> 4 ToF). Servos on the serial bus (not I2C), motors on TB6612 PWM.
Collision / cliff | 2x VL53L0X front + 2x VL53L0X down (qty 4, one line), all behind the TCA9548A mux. No bumper. Validate cliff on your actual floor surfaces.
DECISION STILL OPEN - NFC | Treasure-hunt (XL-M07, P0) + code cards (P1) need an NFC reader (PN532, I2C) under the belly. Not in this BOM yet - include for P0 or defer? Only remaining hardware decision.
Prototype vs production | Every line is a dev board / breakout - correct for the prototype. Production = a custom PCB integrating these ICs (ESP32-S3, TB6612, MPR121, MAX98357, ...) into one compact board, with the servo half-duplex buffer and rails on-board.
