verma-suraj/xelulu/Parts/Bla_Bla/ball-caster-12mm-2.snapshot.7/casterballwheel.JPG

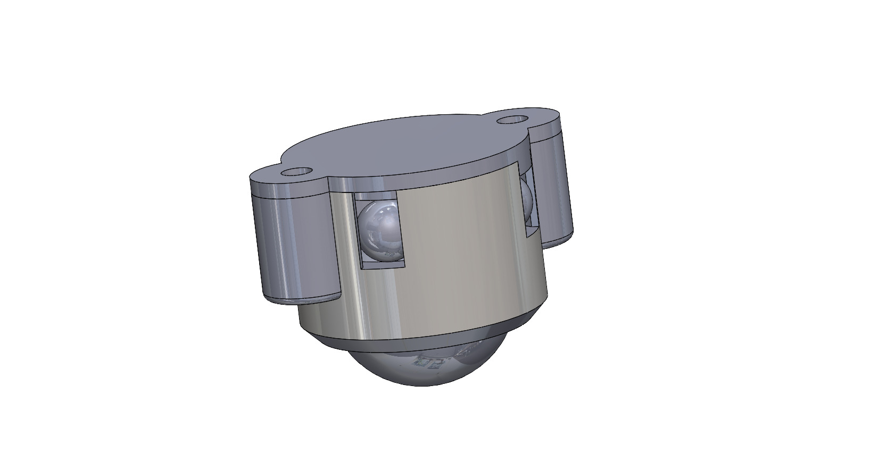
Parts/Bla_Bla/ball-caster-12mm-2.snapshot.7/casterballwheel.JPG
