verma-suraj/xelulu/Parts/Bla_Bla/SC09-Servo-details-size.jpg

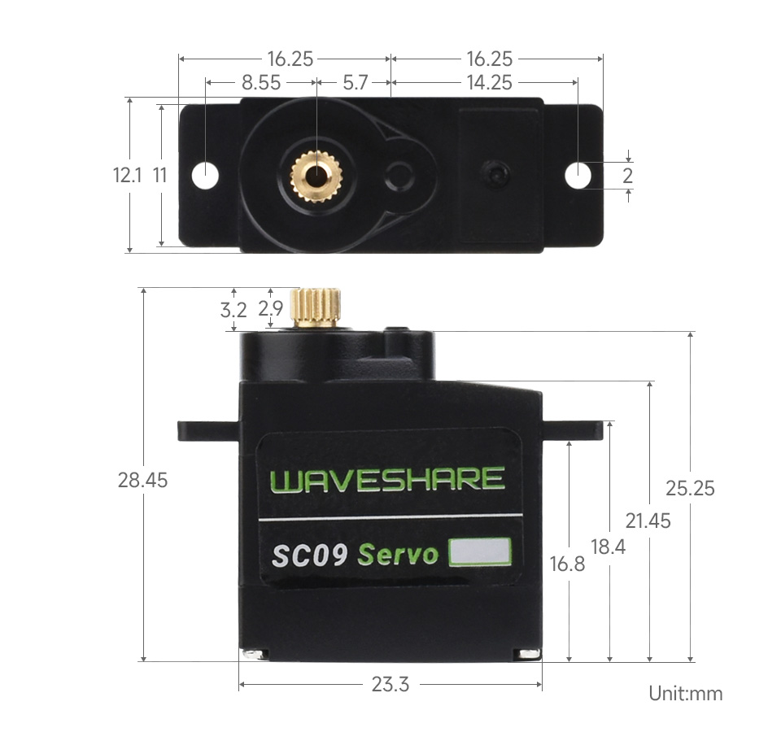
Parts/Bla_Bla/SC09-Servo-details-size.jpg
