verma-suraj/xelulu/Parts/{76B17839-15DD-4251-8FE0-5554E5CCB7D2}.png

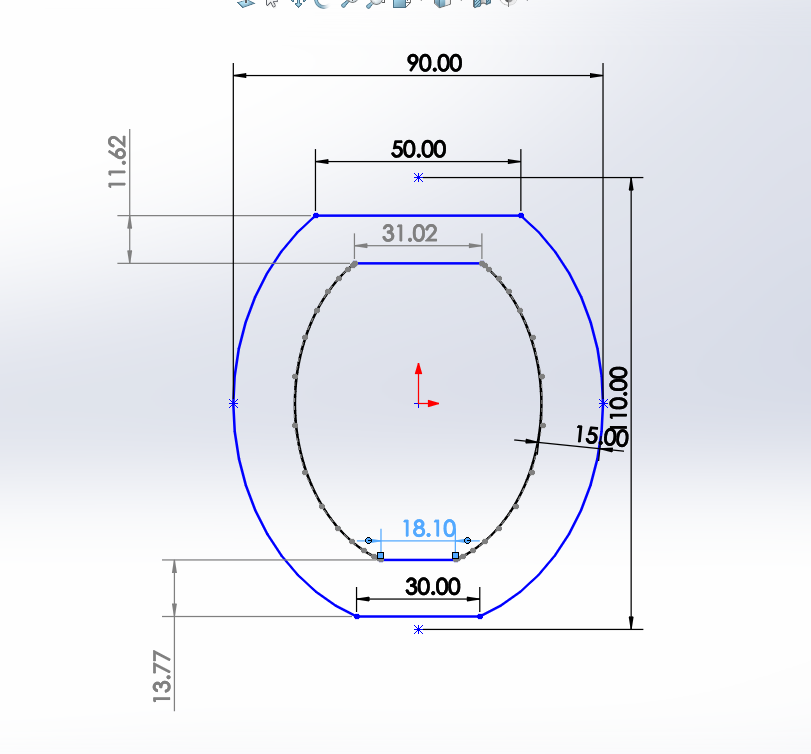
Parts/{76B17839-15DD-4251-8FE0-5554E5CCB7D2}.png
