verma-suraj/xelulu/Parts/Bla_Bla/ball-caster-12mm-2.snapshot.7/Main.SLDASM

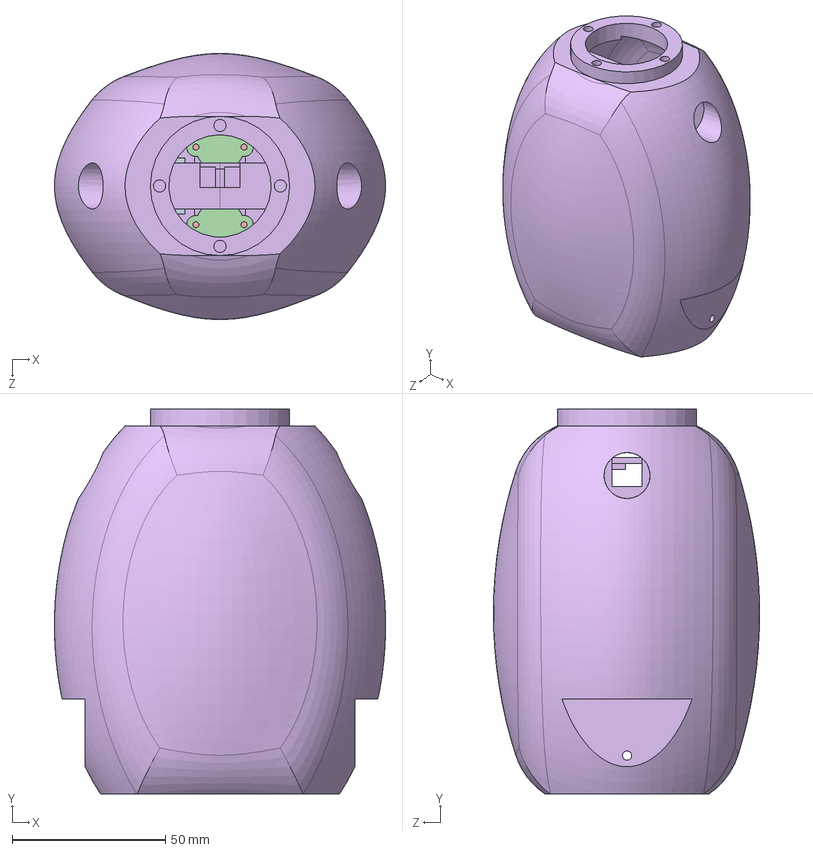
[picture p61: CAD file, 2026-11-01]
Parts/Bla_Bla/ball-caster-12mm-2.snapshot.7/Main.SLDASM
108.0 x 125.5 x 86.8 mm
bn
casterballwheelbody x 2
casterballwheellid x 2
4mmball x 8
12mmball x 2
MotorMount_Bottom
