verma-suraj/xelulu/Parts/Assem5.SLDASM

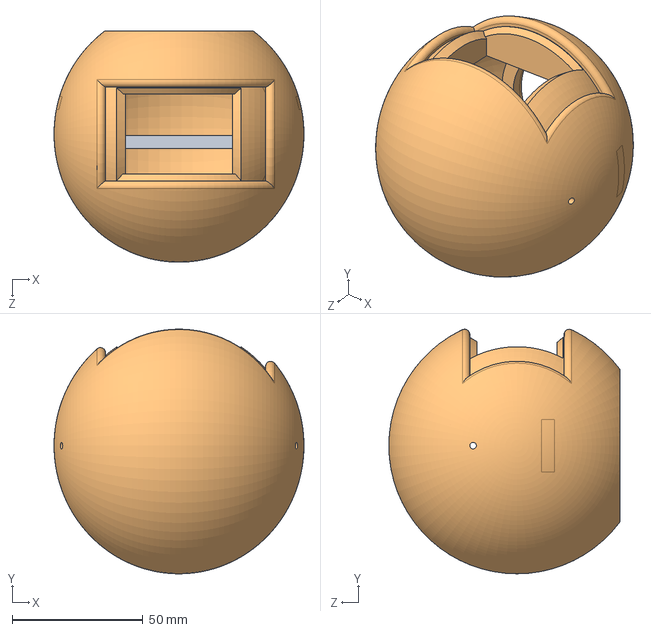
[picture p62: CAD file, 2026-11-01]
Parts/Assem5.SLDASM
95.5 x 93.4 x 88.4 mm
Head
ServoMount_Head
