verma-suraj/xelulu/Parts/Final/Final.SLDASM

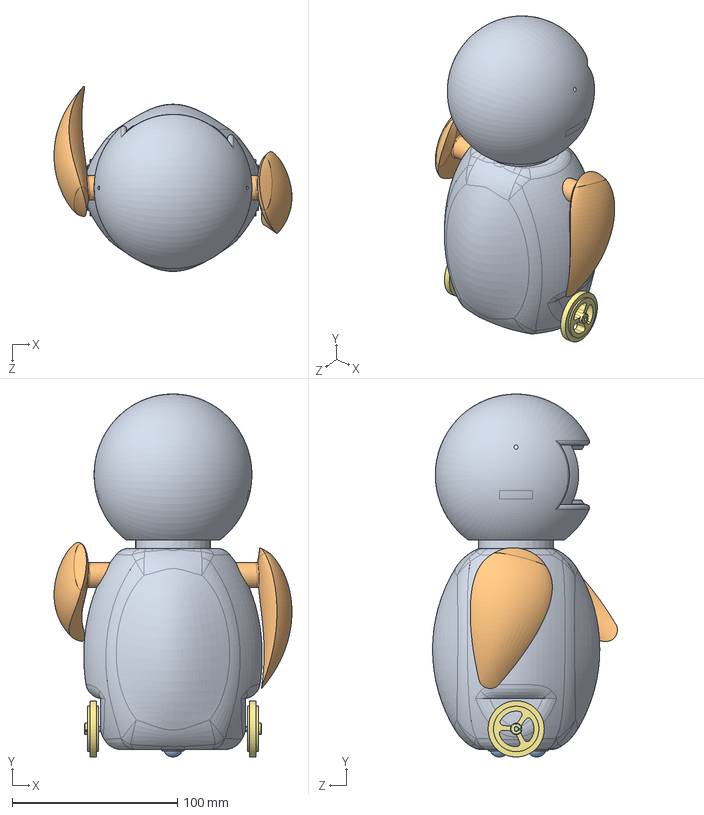
[picture p63: CAD file, 2026-11-01]
Parts/Final/Final.SLDASM
143.9 x 219.6 x 111.9 mm
N20 DC MOTOR x 2
Roda 34 mm x 2
casterballwheelbody x 2
casterballwheellid x 2
4mmball x 8
12mmball x 2
Arms x 2
Head
