verma-suraj/xelulu/Parts/Bla_Bla/ball-caster-12mm-2.snapshot.7/casterballwheel.SLDASM

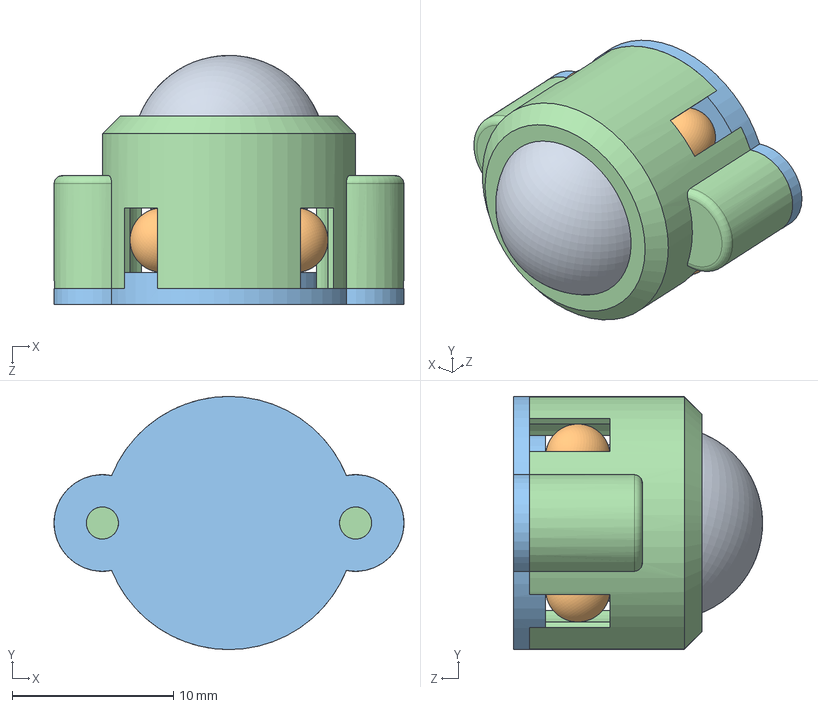
[picture p64: CAD file, 2026-11-01]
Parts/Bla_Bla/ball-caster-12mm-2.snapshot.7/casterballwheel.SLDASM
21.7 x 15.7 x 15.5 mm
casterballwheelbody
casterballwheellid
4mmball x 4
12mmball
