verma-suraj/xelulu/Parts/Assem1.SLDASM

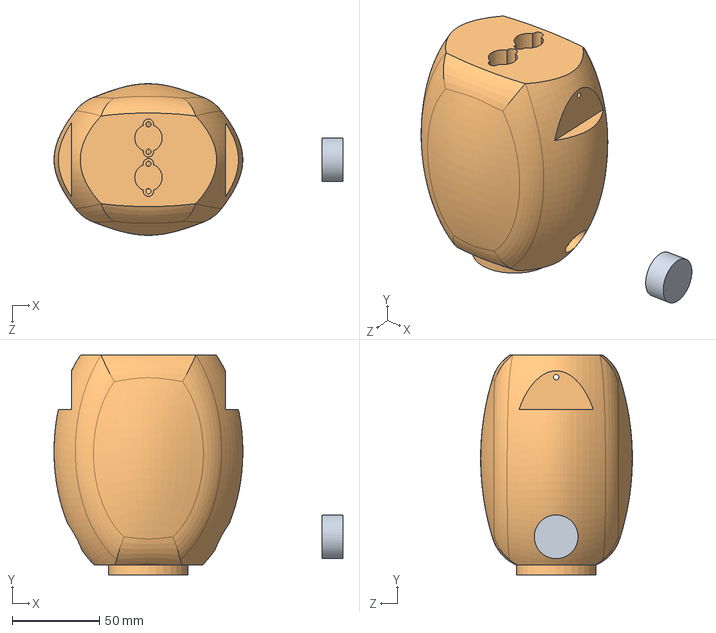
[picture p65: CAD file, 2026-11-01]
Parts/Assem1.SLDASM
165.2 x 125.5 x 86.8 mm
bn
idk x 2
