verma-suraj/xelulu/Parts/Main.SLDASM

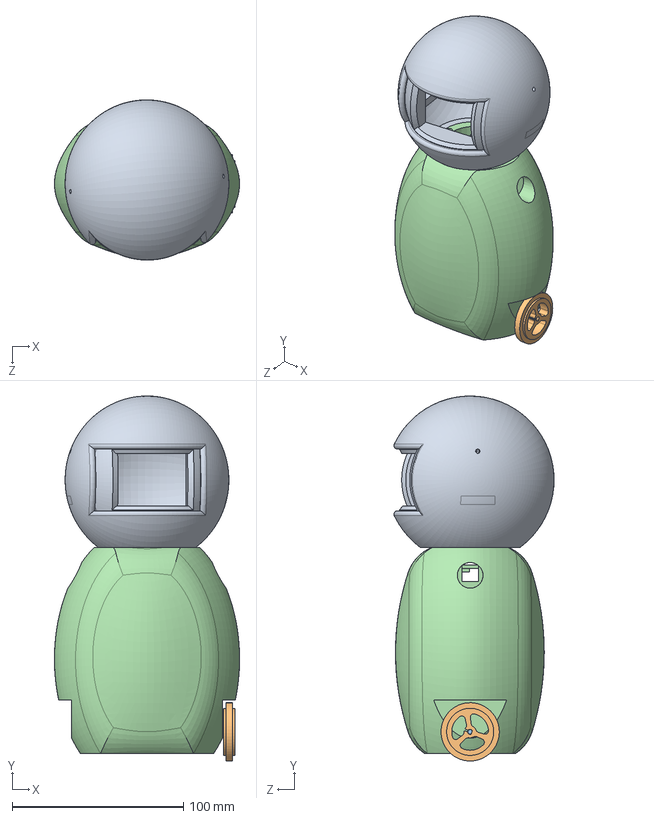
[picture p66: CAD file, 2026-11-01]
Parts/Main.SLDASM
108.0 x 212.8 x 93.4 mm
bn
N20 DC MOTOR
Roda 34 mm
Head
