verma-suraj/xelulu/Parts/Assem2.SLDASM

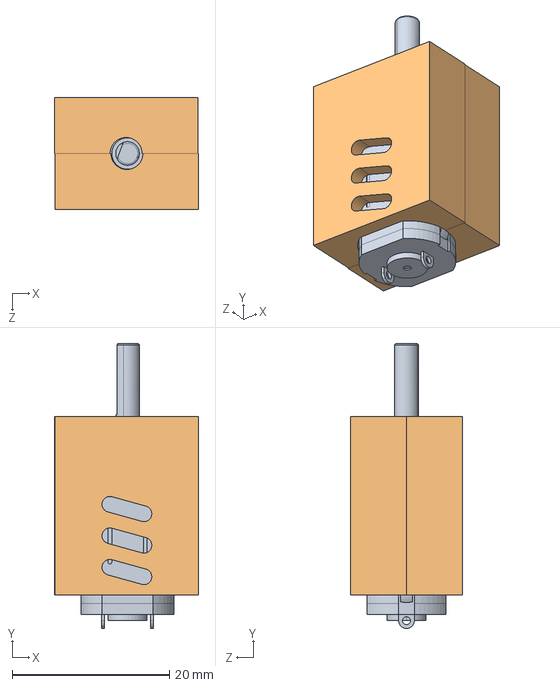
[picture p67: CAD file, 2026-11-01]
Parts/Assem2.SLDASM
18.3 x 36.2 x 14.2 mm
MotorMount_Bottom x 2
N20 DC MOTOR
