verma-suraj/xelulu/Parts/Bla_Bla/MotorMount_Bottom.STL

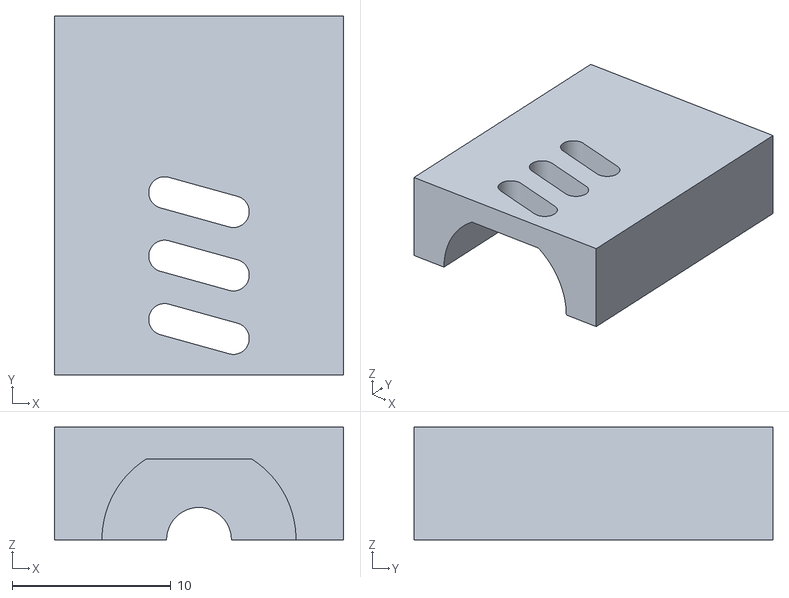
[picture p68: CAD file, 2026-11-01]
Parts/Bla_Bla/MotorMount_Bottom.STL
18.2 x 22.6 x 7.10
