verma-suraj/xelulu/Parts/Bla_Bla/STl/Belly.STL

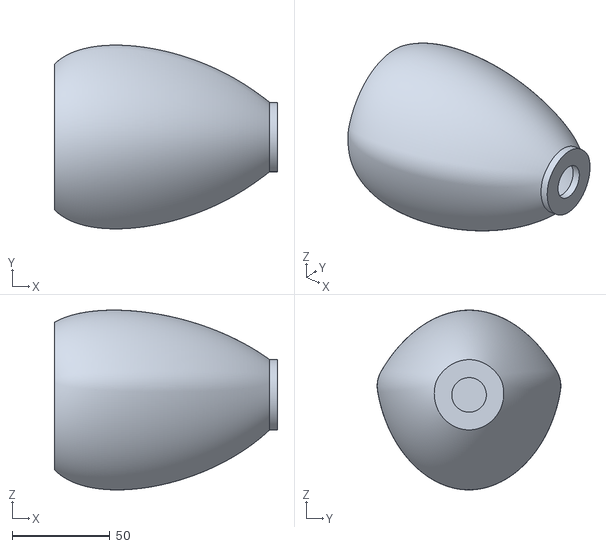
[picture p69: CAD file, 2026-11-01]
Parts/Bla_Bla/STl/Belly.STL
114.0 x 93.9 x 91.9
