verma-suraj/xelulu/Parts/Final/N20 DC MOTOR.SLDPRT

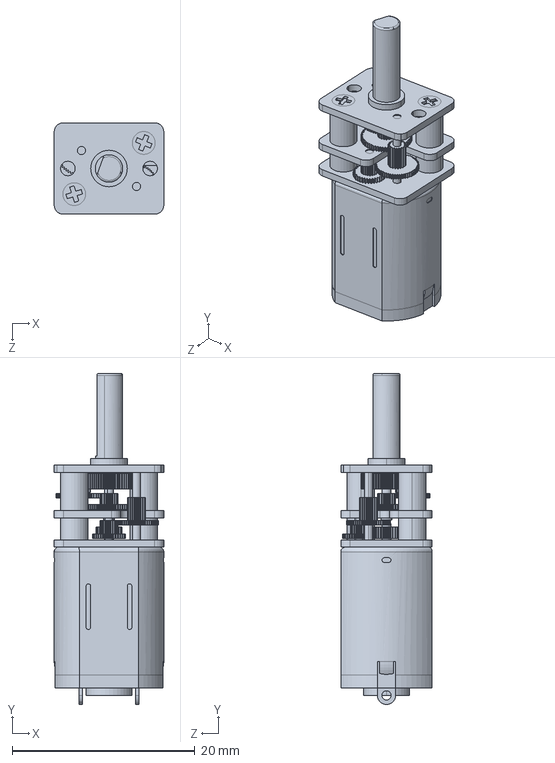
[picture p70: CAD file, 2026-11-01]
Parts/Final/N20 DC MOTOR.SLDPRT
12.0 x 36.2 x 10.0 mm
