verma-suraj/xelulu/Parts/STL/head_front2.STL

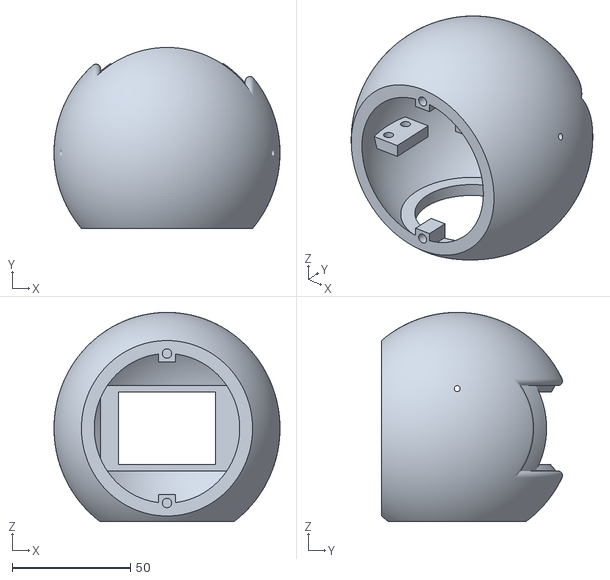
[picture p71: CAD file, 2026-11-01]
Parts/STL/head_front2.STL
95.5 x 76.5 x 88.4
