verma-suraj/xelulu/Parts/Bla_Bla/ball-caster-12mm-2.snapshot.7/casterballwheelbody.SLDPRT

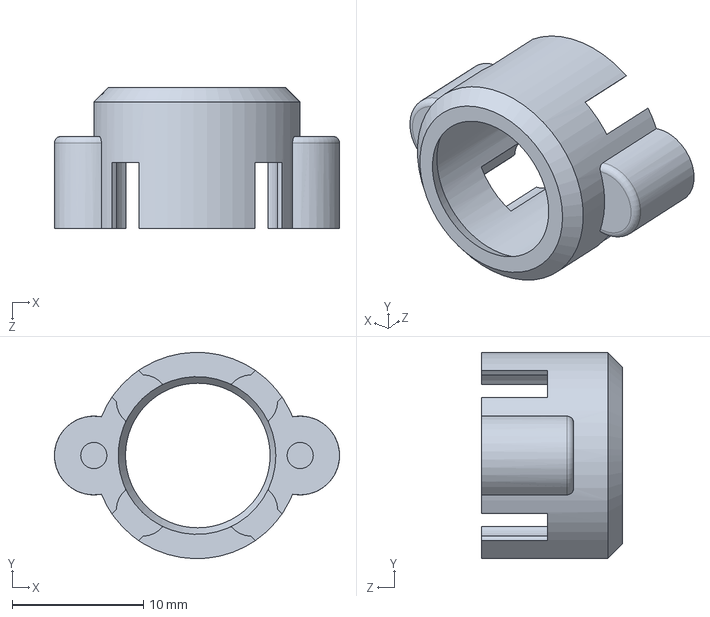
[picture p72: CAD file, 2026-11-01]
Parts/Bla_Bla/ball-caster-12mm-2.snapshot.7/casterballwheelbody.SLDPRT
21.7 x 15.7 x 10.7 mm
