verma-suraj/xelulu/Parts/Final/Mount1.SLDPRT

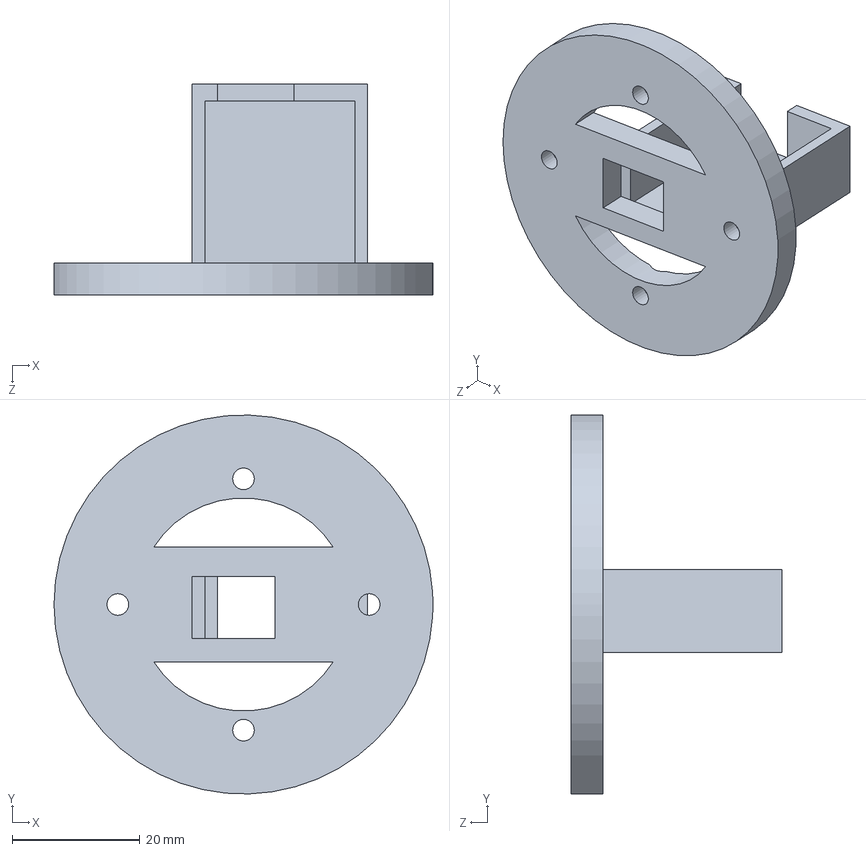
[picture p73: CAD file, 2026-11-01]
Parts/Final/Mount1.SLDPRT
59.4 x 59.4 x 33.0 mm
