verma-suraj/xelulu/Parts/Bla_Bla/ball-caster-12mm-2.snapshot.7/casterballwheellid.SLDPRT

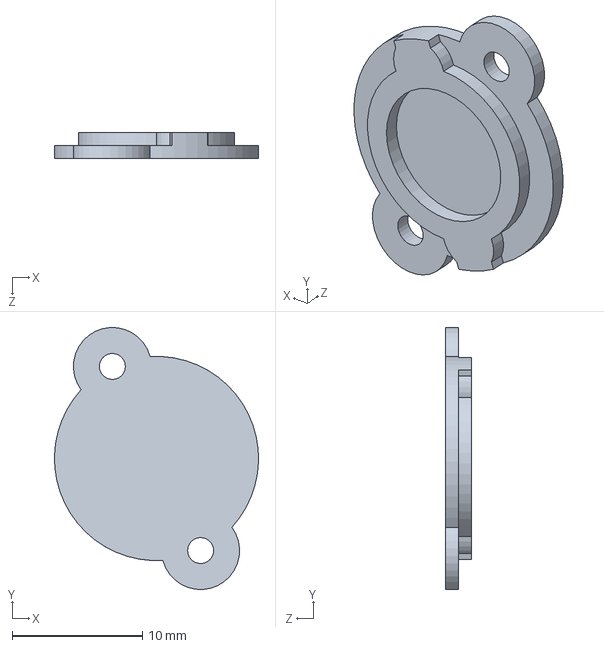
[picture p74: CAD file, 2026-11-01]
Parts/Bla_Bla/ball-caster-12mm-2.snapshot.7/casterballwheellid.SLDPRT
15.7 x 20.1 x 2.00 mm
