verma-suraj/xelulu/Parts/Final/Mount2.SLDPRT

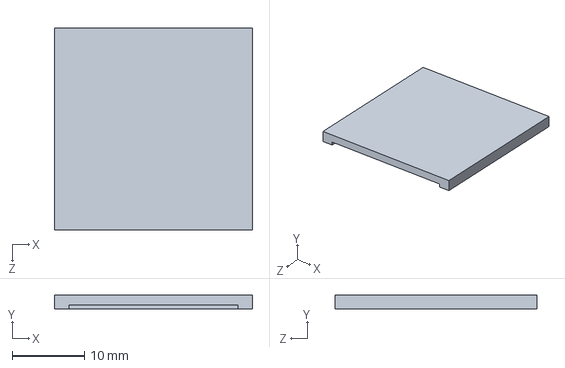
[picture p75: CAD file, 2026-11-01]
Parts/Final/Mount2.SLDPRT
27.5 x 2.00 x 28.0 mm
