verma-suraj/xelulu/Parts/1.STL

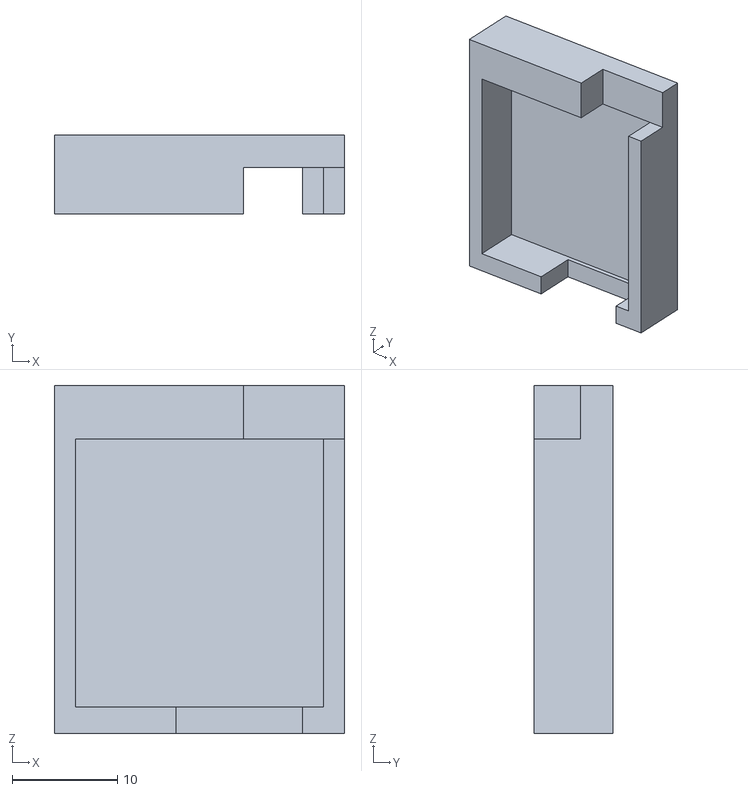
[picture p76: CAD file, 2026-11-01]
Parts/1.STL
27.5 x 7.50 x 33.0
