verma-suraj/xelulu/Parts/Bla_Bla/ball-caster-12mm-2.snapshot.7/12mmball.SLDPRT

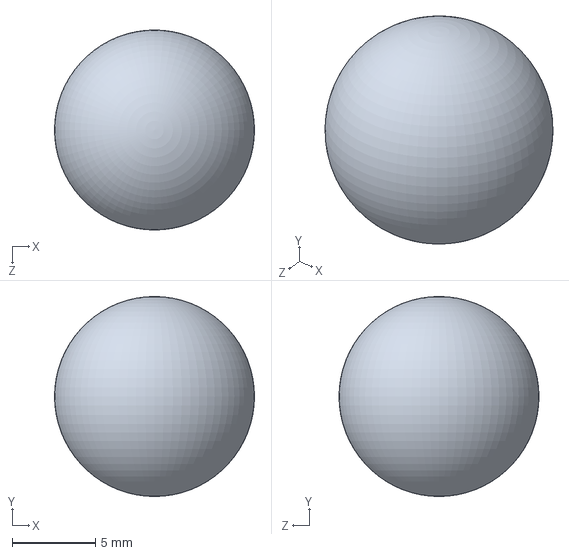
[picture p77: CAD file, 2026-11-01]
Parts/Bla_Bla/ball-caster-12mm-2.snapshot.7/12mmball.SLDPRT
12.0 x 12.0 x 12.0 mm
