verma-suraj/xelulu/Parts/Bla_Bla/ball-caster-12mm-2.snapshot.7/4mmball.SLDPRT

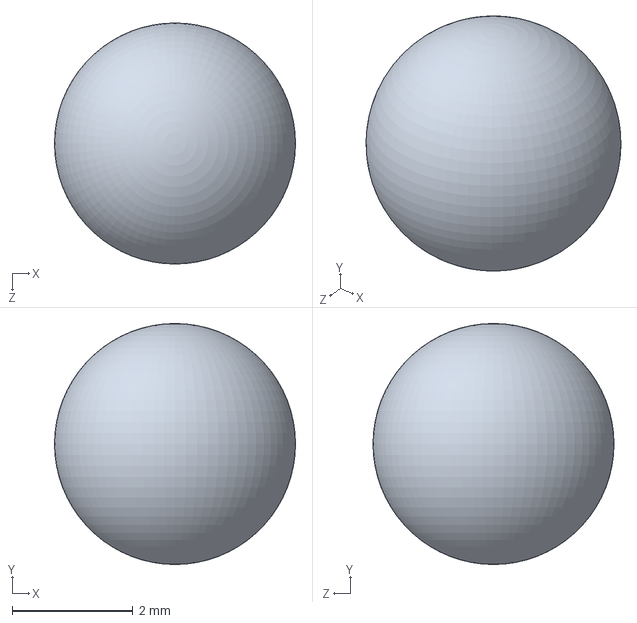
[picture p78: CAD file, 2026-11-01]
Parts/Bla_Bla/ball-caster-12mm-2.snapshot.7/4mmball.SLDPRT
4.00 x 4.00 x 4.00 mm
