verma-suraj/xelulu/Parts/MotorMount_Top.SLDPRT

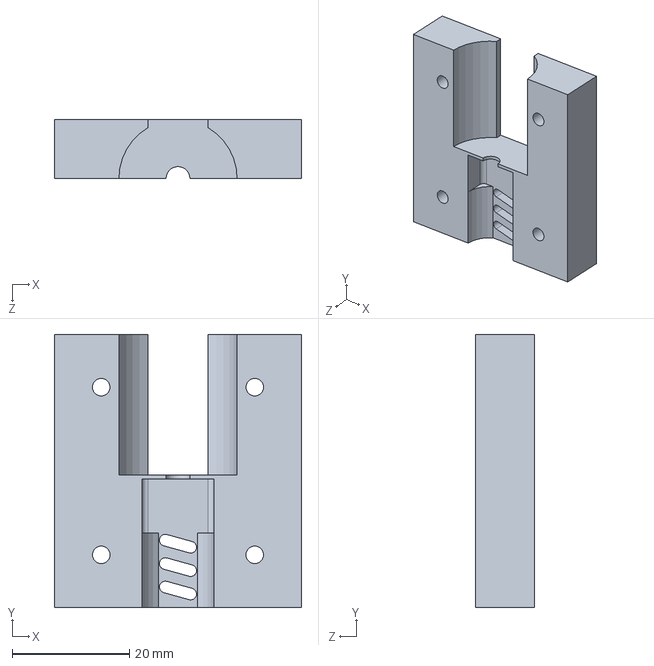
[picture p79: CAD file, 2026-11-01]
Parts/MotorMount_Top.SLDPRT
42.2 x 46.6 x 10.1 mm
