verma-suraj/xelulu/Parts/Final/Arms.SLDPRT

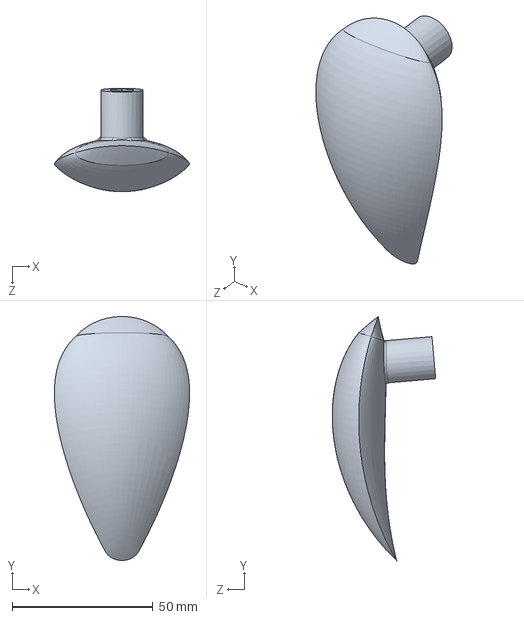
[picture p80: CAD file, 2026-11-01]
Parts/Final/Arms.SLDPRT
48.0 x 86.7 x 36.7 mm
