verma-suraj/xelulu/Parts/Final/Roda 34 mm.SLDPRT

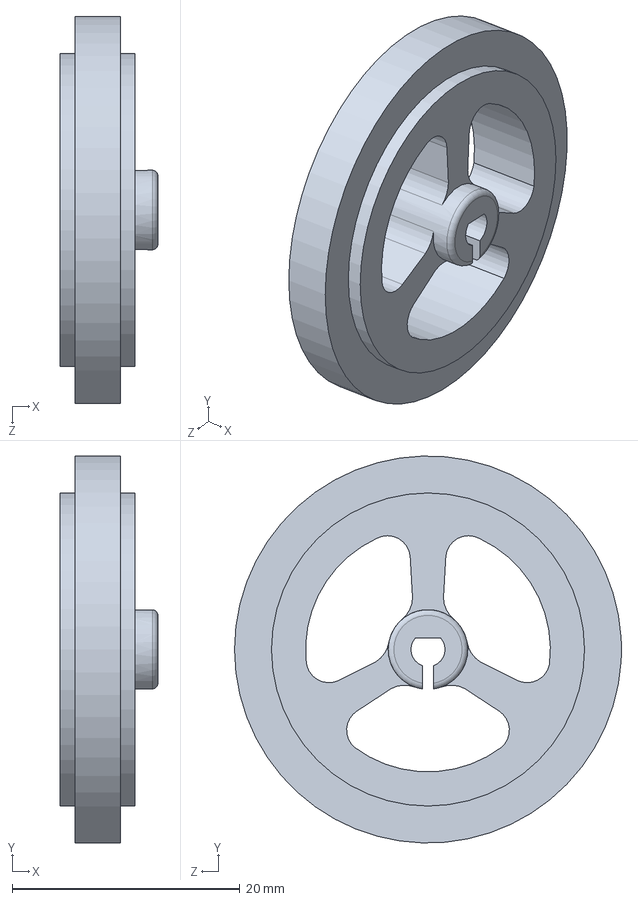
[picture p81: CAD file, 2026-11-01]
Parts/Final/Roda 34 mm.SLDPRT
8.60 x 34.0 x 34.0 mm
