verma-suraj/xelulu/Parts/hand_3.SLDPRT

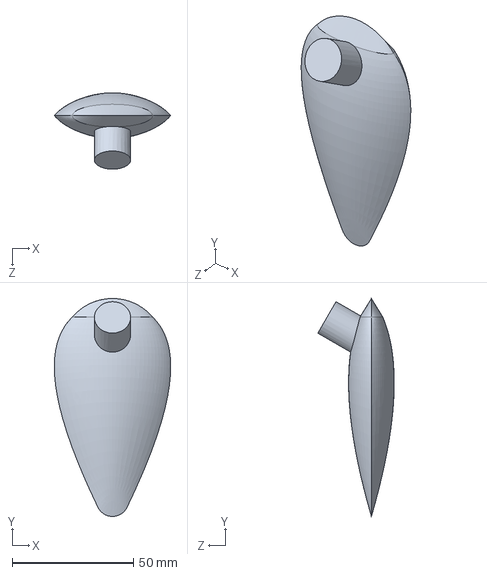
[picture p82: CAD file, 2026-11-01]
Parts/hand_3.SLDPRT
48.0 x 89.9 x 31.5 mm
