verma-suraj/xelulu/Parts/Final/Head.SLDPRT

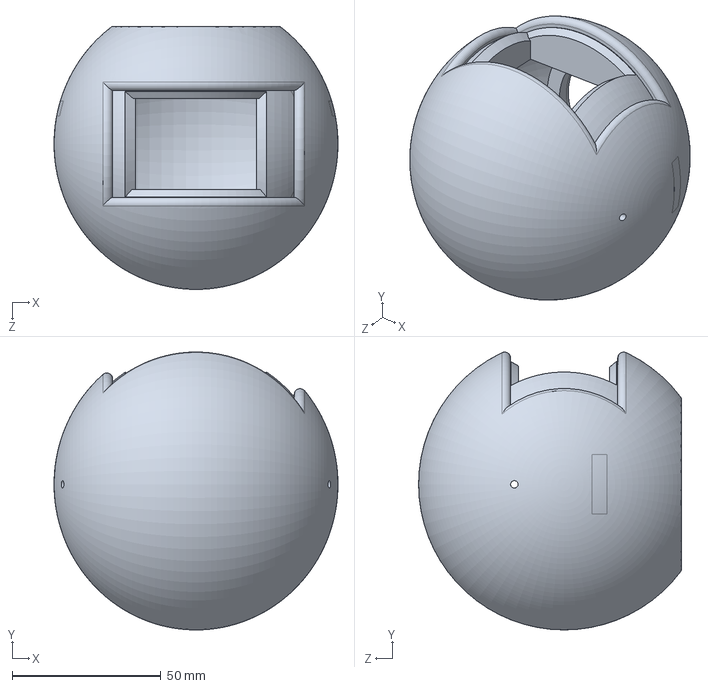
[picture p83: CAD file, 2026-11-01]
Parts/Final/Head.SLDPRT
95.5 x 93.4 x 88.4 mm
