verma-suraj/xelulu/Parts/Final/Head-Mount.SLDPRT

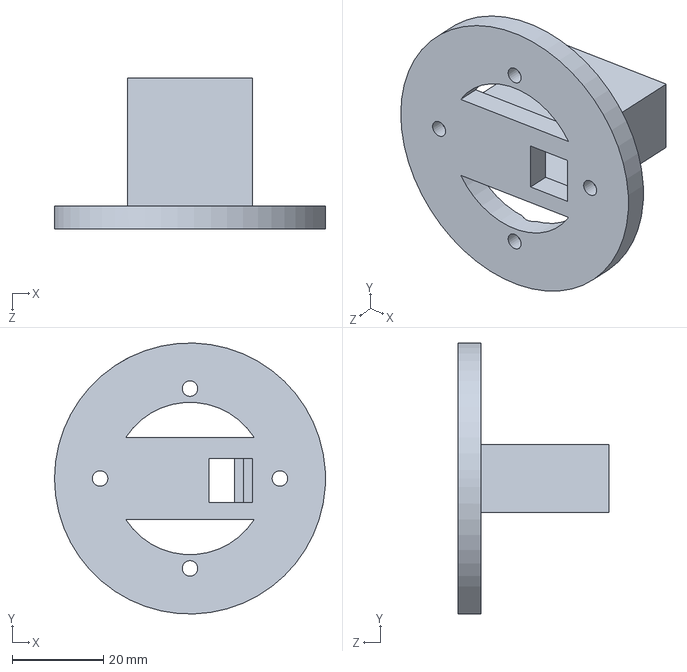
[picture p84: CAD file, 2026-11-01]
Parts/Final/Head-Mount.SLDPRT
59.4 x 59.4 x 33.0 mm
