verma-suraj/xelulu/Parts/hand.STEP

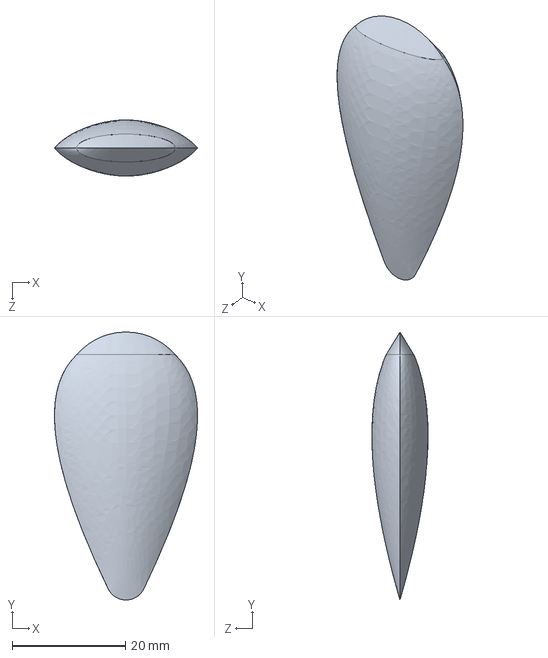
[picture p85: CAD file, 2026-11-01]
Parts/hand.STEP
25.3 x 47.3 x 9.91 mm
