verma-suraj/xelulu/Parts/Final/Body.SLDPRT

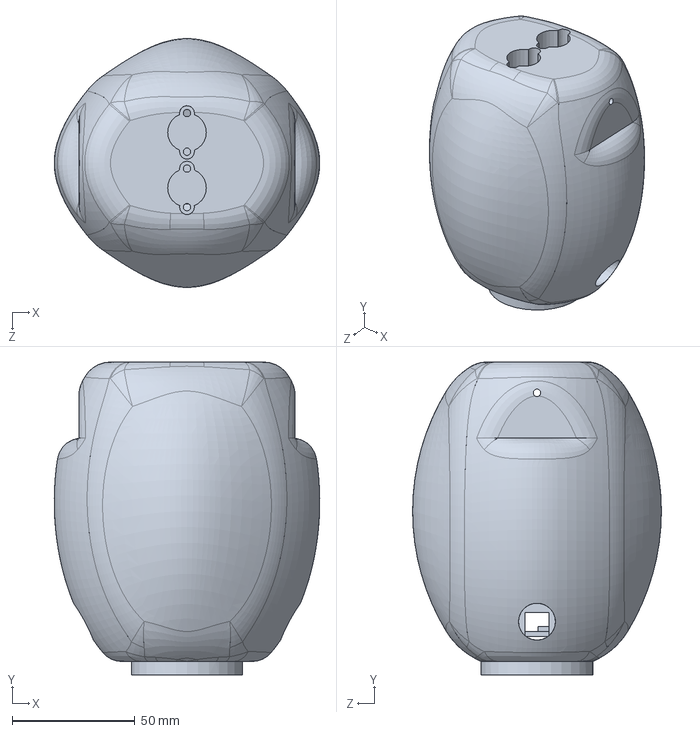
[picture p86: CAD file, 2026-11-01]
Parts/Final/Body.SLDPRT
108.0 x 127.3 x 101.2 mm
