verma-suraj/xelulu/Parts/Head-Mount.SLDPRT

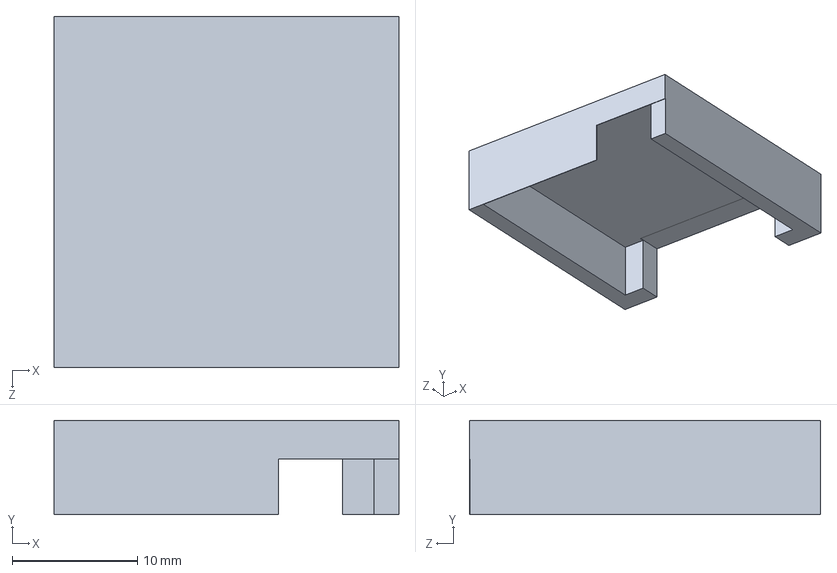
[picture p87: CAD file, 2026-11-01]
Parts/Head-Mount.SLDPRT
27.5 x 7.50 x 28.0 mm
