verma-suraj/xelulu/Parts/ServoMount_Head.SLDPRT

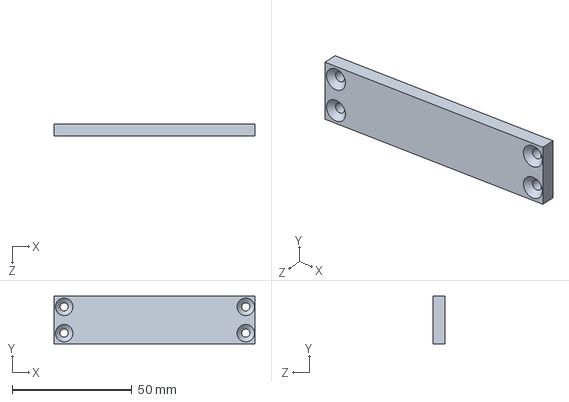
[picture p88: CAD file, 2026-11-01]
Parts/ServoMount_Head.SLDPRT
84.0 x 20.0 x 5.00 mm
