verma-suraj/xelulu/Parts/BodyCopy.SLDPRT

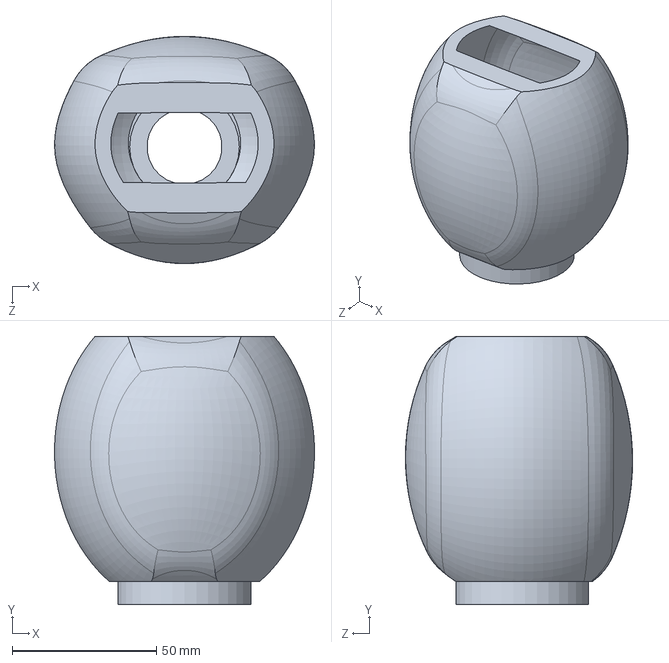
[picture p89: CAD file, 2026-11-01]
Parts/BodyCopy.SLDPRT
90.1 x 93.0 x 78.8 mm
