verma-suraj/xelulu/Parts/idk.SLDPRT

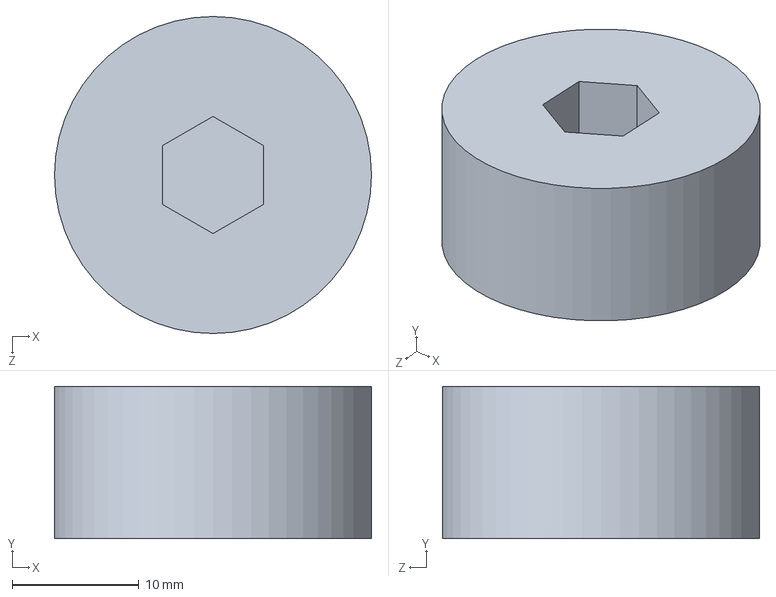
[picture p90: CAD file, 2026-11-01]
Parts/idk.SLDPRT
25.0 x 12.0 x 25.0 mm
