verma-suraj/xelulu/Parts/bn.SLDPRT

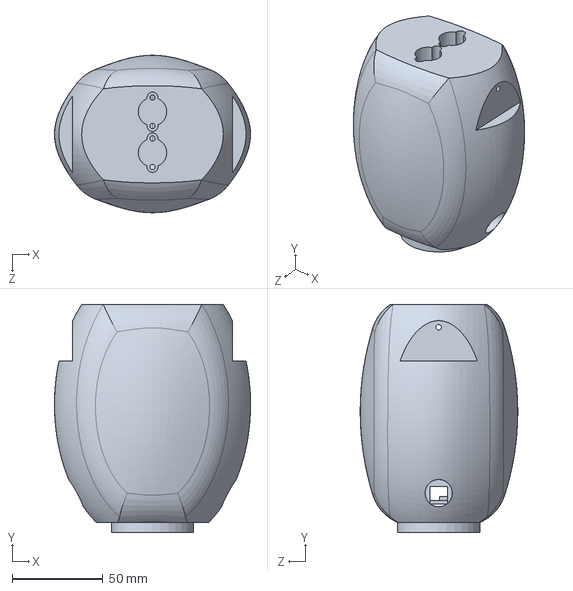
[picture p91: CAD file, 2026-11-01]
Parts/bn.SLDPRT
108.0 x 125.5 x 86.8 mm
