verma-suraj/xelulu/Parts/hand_4.STEP

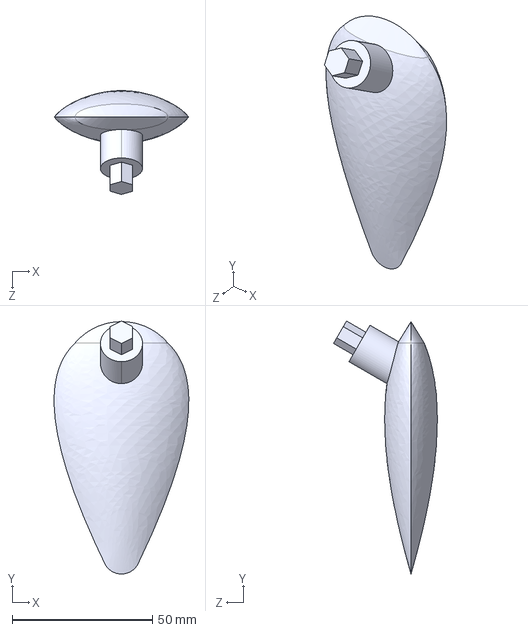
[picture p92: CAD file, 2026-11-01]
Parts/hand_4.STEP
48.0 x 90.1 x 37.0 mm
