verma-suraj/xelulu/Parts/hand_2.SLDPRT

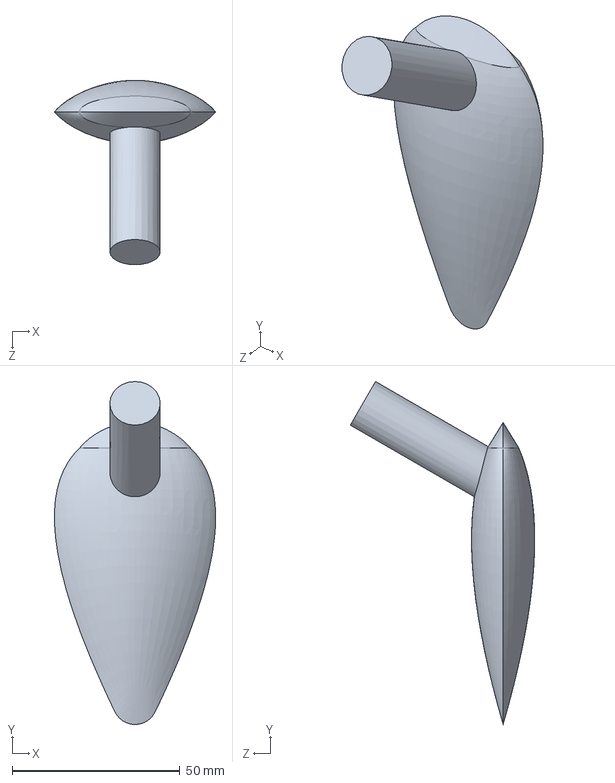
[picture p93: CAD file, 2026-11-01]
Parts/hand_2.SLDPRT
48.0 x 102.1 x 54.9 mm
