verma-suraj/xelulu/Parts/Head.SLDPRT

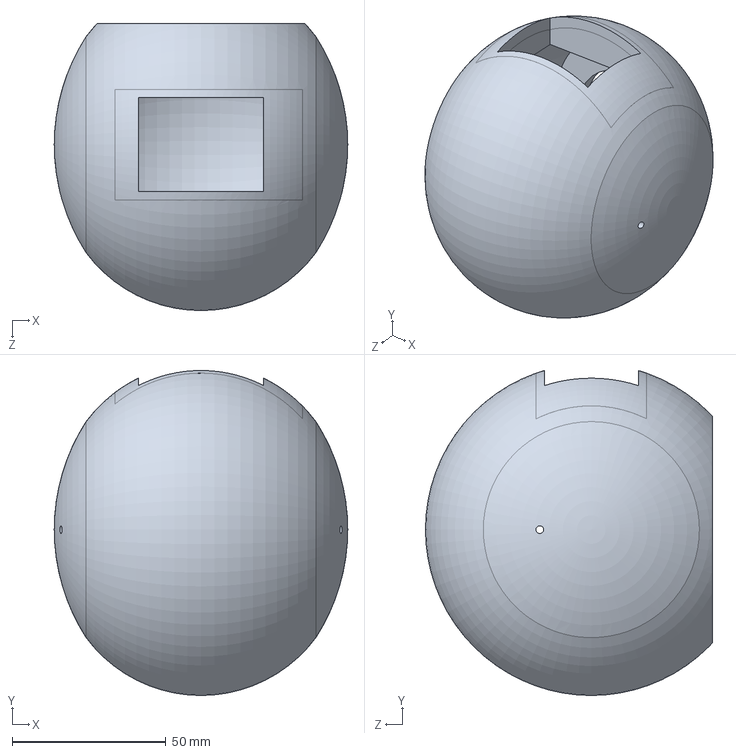
[picture p94: CAD file, 2026-11-01]
Parts/Head.SLDPRT
95.5 x 105.7 x 93.4 mm
