verma-suraj/xelulu/Parts/Final/Assem4.SLDASM

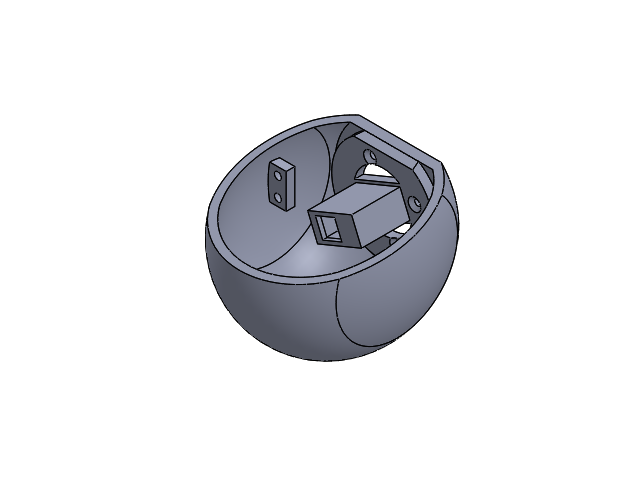
[picture p95: CAD file, 2026-11-01]
Parts/Final/Assem4.SLDASM
Headdd
Head-Mount
