verma-suraj/xelulu/Parts/Final/Assem5.SLDASM

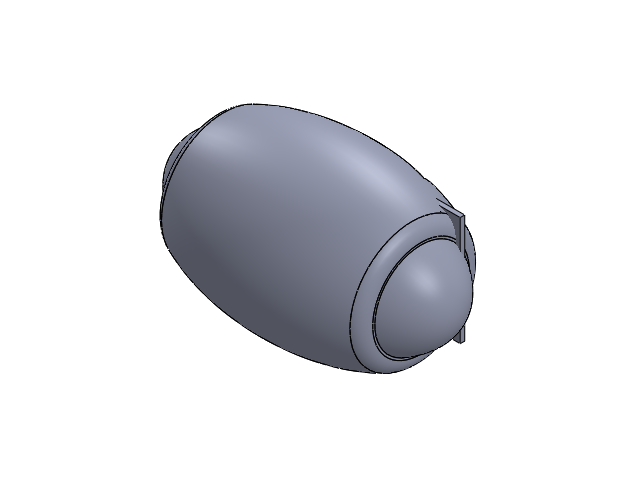
[picture p96: CAD file, 2026-11-01]
Parts/Final/Assem5.SLDASM
Headdddddddddddddd
Loda
