verma-suraj/xelulu/(list of files, cad)

Other CAD files:
Parts/Final/New folder/Final.STL
Parts/MotorMount_Bottom.SLDPRT
Parts/STL/head_front.3mf
Parts/Final/New folder/Mount1.STL
Parts/STL/head_front3.STL
Parts/Final/New folder/Mount2.STL
Parts/2.STL
Parts/Belly.STEP
Parts/Belly.SLDPRT
Parts/Bla_Bla/ER-TFT020-2.x_t
Parts/Bla_Bla/ball-caster-12mm-2.snapshot.7/casterballwheel.IGS
Parts/Final/Body - Copy.SLDPRT
Parts/Head - Copy (2).SLDPRT
Parts/Head - Copy.SLDPRT
Parts/Head-Mount (2).SLDPRT
Parts/Head-Mount - Copy (2).SLDPRT
Parts/STL/head_front.STL
Parts/bn - Copy.SLDPRT
Parts/hand_4.SLDPRT
