verma-suraj/xelulu/Xelulu_Onboarding_and_Test_Guide.docx

Xelulu

Hardware Integration - Onboarding & Full Test Guide

For the hardware / firmware engineer bringing up the ESP32-S3

Repository: github.com/vikas-vishw/xelulu

Contract: Document B v2 (proto_ver 2)

# Contents

0. How to read this document

1. What Xelulu is, and what you are receiving

2. Install the prerequisites (one time)

3. Clone the repository

4. Run the stack (Docker)

5. Open the developer console (your main workspace)

6. Open the simulator panel (the robot stand-in)

7. Test every feature — where to click, what to expect

8. Connect the real robot (open the LAN + point the firmware)

9. Open the parent app on your phone (and what it does / does not do)

10. What is built, what is not, and the open gates

11. The "is every part working" checklist

12. When something does not match, and who to tell

—. Appendix: CLI quick reference

# 0. How to read this document

This is the one document you need to go from an empty laptop to a Xelulu robot that connects, talks, and passes every feature check. You run everything from a terminal or click it in a browser. You write no code and you edit no file in this repository.

The golden rule: If a step here seems to need a change to the app, the gateway, or the wire contract, that is a bug in this guide or a conformance gap in the firmware — raise it, do not edit anything in the repo. The contract (Document B) is frozen.

Three documents stand behind this one, all inside the repo under docs/:

- Document B (B-gateway-and-hardware-seam.docx) — the wire contract. Frozen at proto_ver 2. The firmware is built to match it, never the reverse.
- Document C (C-pairing-and-device-session.md) — adds MQTT pairing and the device session on top of B, with no new topic, message, or field.
- Intern Integration Guide (intern-integration-guide.md) — the deepest firmware-conformance checklist. This onboarding document is a superset of it and points to it where the detail is exhaustive.

Where they disagree, precedence is: Document B → Document C → this guide.

# 1. What Xelulu is, and what you are receiving

Xelulu is a screen-free AI companion robot for children. The robot is the child’s only interface; a separate phone app is for the parent. What you are receiving is the complete cloud-side software that the robot talks to, running entirely on your own machine, plus the tools to test every part of it.

You will run four things on your laptop:

Piece | What it is | How you reach it
The gateway + broker (Docker) | The "cloud": an MQTT broker (EMQX) and the Node gateway that runs the whole voice brain, safety layer and device logic. | Runs in Docker; the robot connects to it
Developer console | Your main workspace. A web app to connect a device, fire every feature, and read pass/fail. | http://127.0.0.1:5173
Simulator panel | A software stand-in for the robot. Fires touches, events and audio turns so you can test before the hardware is ready. | http://127.0.0.1:8091
Parent app (phone) | The parent experience, 16 screens, in Expo Go. Mock data only in this phase (see §9). | Expo Go, via QR code

What drives the AI right now: Mock providers. There is no real speech-to-text, language model or text-to-speech wired yet — that is deliberately gated (see §10, gate F6). Every turn still runs through the real safety layer and the real device-policy gate, with mocked vendors behind them, so everything you test about the wire, the device and the safety behaviour is real.

# 2. Install the prerequisites (one time)

Install these in order. Versions are pinned by the repo and the install will refuse a wrong version, so match them exactly.

Tool | Version | Why / how
Git | any recent | To clone the repo.
Docker Desktop | with compose 2.24+ | Runs the broker, gateway and simulator. Start Docker Desktop before any docker command.
Node.js | 24.21.0 (exact) | From .nvmrc. Use nvm use / fnm use in the repo root. pnpm refuses any other Node version.
pnpm | 10.34.6 | Run corepack enable in the repo, or npm install -g pnpm@10.34.6
Expo Go | for Expo SDK 57 | On the phone, from the App Store / Play Store. iOS needs npx expo login with the same account you use in Expo Go.

### Windows note

Install the pinned Node 24 and put it first on PATH in every terminal that runs pnpm (system Node 22 and a global pnpm both fail here). Docker does not care which Node the shell has. Example, if you keep a portable Node at c:\xelulu\.tools:

$env:Path = "c:\xelulu\.tools\node-v24.21.0-win-x64;" + $env:Path

# 3. Clone the repository

You clone the repo as a plain download — you do not need to be a GitHub collaborator, and you will not push to it. Open a terminal in the folder where you keep projects and run:

git clone https://github.com/vikas-vishw/xelulu.git

cd xelulu

You never commit here. This repo is the thing you run and the contract you build against. Your firmware lives in its own separate codebase. If you ever believe something in this repo must change, raise it with the founder — it comes back as a reviewed change, never an edit you make.

# 4. Run the stack (Docker)

From the repo root, start the three containers. No .env file is needed — the stack carries a local default for every value.

docker compose up --build -d

docker compose ps

Within about a minute, three containers reach Up (healthy):

- xelulu-emqx-1 — the MQTT broker
- xelulu-gateway-1 — the cloud brain
- xelulu-simulator-1 — the robot stand-in

Harmless warning: Every docker compose command prints "MQTT_USERNAME variable is not set. Defaulting to a blank string" (and the same for MQTT_PASSWORD). That is expected and correct for the local stack — not an error.

### What is listening once the stack is up

Surface | Address | Reachable from
MQTT broker (EMQX) | 1883 plain, 8883 TLS | your LAN only when you open it (§8); loopback by default
Gateway audio WebSocket | 8081 | your LAN only when you open it (§8); loopback by default
Developer console (operator) | 127.0.0.1:8090 | this machine only, always
Simulator control panel | 127.0.0.1:8091 | this machine only, always
EMQX dashboard | 127.0.0.1:18083 | this machine only, always

Use 127.0.0.1, never "localhost". "localhost" can resolve to ::1 (IPv6), which the loopback-only publish does not serve. Always type 127.0.0.1 in the browser.

Stop everything with docker compose down.

# 5. Open the developer console (your main workspace)

In a second terminal, in the repo root (Windows: portable Node 24 first on PATH):

pnpm install

pnpm build

pnpm dev:admin:device

Open http://127.0.0.1:5173. The header reads Stream: Live. The pages are in the left navigation:

Page | URL | What it is for
Dashboard | /#/ | Device count, online/offline, battery, a live log.
Devices | /#/devices | Each device, its pairing code, and its session state. (§7.1)
Test matrix | /#/matrix | The 28-row feature checklist. (§7.2)
Device control | /#/control | Fire the five allowed commands by hand. (§7.3)
Conversation | /#/conversation | What happened inside each voice turn. (§7.4)
Content | /#/content | Stories, games, songs, learning, Grandma, routines. (§7.5)

### Three console modes — pick by what you need to do

Command | What the console may do
pnpm dev:admin | Read the live stream and content. Nothing is sent or written.
pnpm dev:admin:content | The above, plus editing content.
pnpm dev:admin:device | The above reads, plus sending commands to the device. Use this one for testing.

Two switches to send a command. Firing a command needs the console in device mode (pnpm dev:admin:device) AND the gateway’s own --device-control argument. The local Docker stack already passes that argument, so dev:admin:device is the only switch you think about. With only one on, a send answers device_control_disabled or proxy_disabled and nothing reaches the robot — that is the gate working, not a broken page.

# 6. Open the simulator panel (the robot stand-in)

Open http://127.0.0.1:8091. This is a software robot. Until your firmware is ready — and alongside it afterwards — it is how you fire everything the device is supposed to originate. Every list on it is built from the contract, so you cannot fire a value Document B does not define.

Its sections:

- Touch — a button per touch zone (head, left ear, right ear, belly, back, left hand, right hand).
- Any event — fire wake, cry, motion, button, nfc, interrupt or error. Omitted data fields get sensible defaults.
- Audio turn — pick a named test utterance (story, where-did-grandpa-go, sad, hindi-hello, and more) and Start audio turn to run one full conversation turn.
- Ack policy — make the simulated device reject or fail commands on purpose, to test the refusal paths.

There is also a CLI for the simulator if you prefer the terminal, e.g. docker compose exec simulator node dist/cli.js event touch '{"zone":"belly","gesture":"tap"}'. The full list is in the appendix.

# 7. Test every feature — where to click, what to expect

Do this first, every session: Set an active child, or the gateway applies its most restrictive context (movement off, stories refused). From a terminal:

docker compose exec gateway node dist/cli.js send xlu_000123 config '{"active_child_id":"child_mock_1"}'

That mock child’s quiet hours are 22:00–07:00 in the container’s time (UTC under Docker). Run your tests during the waking window, or all five allowed commands refuse with quiet_hours — which is the gate working, not a failure.

## 7.1 Device presence, session and pairing — the Devices tab

Open /#/devices. One row per registered device. Read three things:

1. Pairing code — six characters (e.g. RZHGKR). It is derived in the cloud from the device’s id and firmware version, never sent on the wire. It is a confirmation you read out loud, not a secret. Compare it to what the firmware prints on its serial console at boot: same device + same firmware version = same code, always.
2. Presence — Online / Offline, from the 45-second heartbeat rule.
3. Session — the state below.

Session state | Means | Moved there by
Unpaired | Never authenticated since the cloud started | nothing but a hello clears it
Connected | A hello was accepted — paired | an accepted hello
Idle | Alive, not in a turn | an accepted status heartbeat
In turn | An audio turn is open | audio_start on the audio socket
Error | Auth failed, a message was rejected, or an error event | any of those three
Offline | 45s with no heartbeat | the silence window expiring

A conformance tell: If Presence reads Online but Session stays Offline/Unpaired, the firmware resumed its heartbeat without republishing hello on reconnect — a Document C violation. The page shows it rather than hiding it. Fix the firmware’s reconnect path (subscribe to cmd, publish hello, then resume heartbeat).

## 7.2 The 28-row test matrix — the heart of testing

Open /#/matrix. The page builds its rows from Document B at load time: one per command, one per event, one per touch zone, plus two whole-feature rows. The run lives in the page only — reload and it restarts. The total line counts passed / failed / running / pending.

### 7.2a Cloud → device (11 rows): the console fires these

Press Run on a row; the console posts to the device-control route, which puts the Phase 3 policy gate between the button and the wire.

Rows | Expected | Passes when
say, animate, gesture, led, play | Ack done / accepted | the device acks. These are the five the gate allows.
move | Refusal | the gate refuses it. Movement is NEVER sent from the console — the body controller owns its own hard limits.
set_mode, volume, config, stop_audio, ota | Refusal | the gate refuses them — they are operator / pipeline concerns, not console ones.

A refusal on the six is a PASS. The row expects it. A refusal on the five allowed commands is a fail, and the Evidence cell names why: quiet_hours, play_limit, movement_off or action_not_allowed.

### 7.2b Device → cloud (17 rows): you fire these at the device

These rows have no Run button, on purpose — they originate at the device. The console watches the stream and turns a row green when the matching message arrives. Fire them from the simulator panel during bring-up, and from the real robot later.

Row(s) | From the simulator panel | From the real robot
touch + 7 zone rows (head, left_ear, right_ear, belly, back, left_hand, right_hand) | Touch → the zone button | touch that zone
wake | Any event → wake | say "Hey Lulu", or hold the belly
cry | Any event → cry | a cry the on-device detector catches >5s
motion | Any event → motion | pick it up, shake it, tilt it
button | Any event → button | press the belly talk button
nfc | Any event → nfc | tap a story card
interrupt | Any event → interrupt | speak over the robot while it replies
error | Any event → error | whatever fault the firmware reports
audio_turn (one whole turn) | Audio turn → pick utterance → Start audio turn | hold the belly and speak one sentence
safety_refusal | Ack policy → scope "all actions", override "reject", reason e.g. picked_up → Set override, then Run any allowed row. Clear after. | lift the robot, then Run gesture — the firmware must reject it

### 7.2c What counts as evidence

Each row’s Evidence cell holds ids, closed enums, counts and times — a cmd_id, a turn_id, an ack outcome and reason, a sequence number, a timestamp. Never any words from a turn. The console shows what happened without showing what anyone said.

## 7.3 Device control tab — bring-up and debugging

Open /#/control. The same five allowed commands, fired by hand, each showing the cmd_id the route minted and then the ack’s outcome and reason. Pick the target device in the selector. Send a led and watch the ears; send a gesture and watch the servo; lift the robot and send it again and read the refusal. There is no move control and never will be — the gate refuses movement whoever asks. Every ack reason is final; nothing retries around a refusal.

## 7.4 A voice turn end to end — the Conversation page

A turn runs: speech-to-text → input safety guard → language model behind the tool router → output safety guard → text-to-speech streamed back as a say. All on mock providers. To watch one:

1. Make sure an active child is set (top of §7) and it is the child’s waking window.
2. In the simulator panel, Audio turn → pick an utterance (try story, then sad, then hindi-hello) → Start audio turn.
3. Open /#/conversation. Within a couple of seconds the turn appears, newest first.

For each turn the page shows: the safety decision and rule at every stage (input and output), the tools called and their outcomes, the latency in milliseconds, whether the "let me think" filler was spoken, the frames sent, and the turn state. Transcript and reply text are off by default; the local Docker stack turns them on (the gateway runs with --operator-transcripts), so you will see the words too — but they live in gateway memory only, are never written anywhere, and vanish on restart.

## 7.5 Safety layer — see it refuse and comfort

The safety layer is the most important thing in the product, and it is fully built. You can watch it work on the Conversation page:

- With no active child set, fire the story utterance: the input guard refuses and you see a safe redirect instead of a story.
- A distress utterance (e.g. sad) produces a comfort reply and raises a parent-alert signal in the stream.
- Every stage is logged as a decision + rule — never the child’s words. The guards run in both English and Hindi (Devanagari).

What the layer does: an input guard and an output guard (both run on every turn); deferral ("ask a grown-up" + a parent alert); refusal to a safe redirect; comfort with a distress alert; and a hard block on any URL, phone number, price or brand name reaching the child.

## 7.6 Content — stories, games, songs, learning, Grandma, routines

Run the console in content mode for this: stop it and run pnpm dev:admin:content (or dev:admin:device, which also reads content). Open /#/content. Five sections list what the gateway holds: Stories, Games, Songs, Learning, Grandma — each item with its status and its safety gate verdict.

- Stories are original retellings from the Panchatantra, Jataka, Tenali Raman and Akbar-Birbal traditions.
- Edit or add an item: every write lands as a draft. An item becomes Active only when the output safety guard passes its title and every step and prompt at each age stage and language. A refused activation shows the rule, the age stage and the language, and the item stays a draft.
- Grandma mode: record a consent record first, then a recording against it, then schedule it. No Grandma audio exists in this phase — a recording is metadata and an opaque handle; text-to-speech stands in for playback.
- Routines: the Run control fires a routine; every command it sends goes through the same device policy gate (quiet hours, play limit, movement) as a turn’s commands.

# 8. Connect the real robot (open the LAN + point the firmware)

Everything above works against the simulator with the stack closed to your machine. To let a physical robot on your Wi-Fi connect, you open the device-facing ports — and only those — and the device authenticates before it can touch anything.

### 8.1 Open the device ports

Set one value in a root .env file, then bring the stack up:

DEVICE_BIND_HOST=0.0.0.0

This moves only the MQTT broker (1883/8883) and the gateway audio socket (8081) onto your LAN IP. The console (8090), simulator panel (8091), EMQX dashboard (18083) and MQTT-over-WebSocket ports stay on 127.0.0.1 whatever you set — a build test enforces that.

Opening the port does not open the door. Anonymous broker access is OFF. The device must present its DEVICE_ID as username and DEVICE_TOKEN as password; the gateway uses a separate MQTT_USERNAME / MQTT_PASSWORD. A device on the Wi-Fi with no token, a wrong token or an unknown id is refused at the broker and never reaches a topic, and the gateway checks the token again at hello. This is a dev-LAN setup only — not internet-facing. Do not port-forward it, and do not treat the dev placeholders as real secrets.

### 8.2 Find your host’s LAN IP

OS | Command | Use
Windows | ipconfig | the IPv4 Address of your active Wi-Fi/Ethernet adapter
macOS | ipconfig getifaddr en0 | the address printed (try en1 if empty)
Linux | hostname -I | the first address

Pick the address on the same subnet as the robot (typically 192.168.x.y or 10.x.y.z). Ignore VPN and Docker bridge addresses.

### 8.3 Point the firmware at the endpoints

Four values carry the firmware’s endpoints and identity. The robot cannot use 127.0.0.1 — that is its own loopback — so replace the Docker service host with your LAN IP, keeping the same ports.

Key | What the firmware does with it | Local value
MQTT_BROKER_URL | the broker it connects to | mqtt://<LAN-IP>:1883
AUDIO_WSS_URL | the per-turn audio WebSocket | ws://<LAN-IP>:8081
DEVICE_ID | its own id, in topics and in hello | xlu_000123
DEVICE_TOKEN | the token it puts in hello’s auth and the audio Authorization header | the dev placeholder

Production uses mqtts and wss with a per-device certificate in ESP32-S3 secure storage. The dev token is for this loopback/LAN stack and nothing else.

Firmware conformance checklist: The complete list of every message the firmware must send and accept, every ack it must return, and the envelope/connection rules is in the repo at docs/intern-integration-guide.md §9, drawn from Documents B and C. That is the authoritative checklist — build to it, and do not rely on any summary of it. This guide deliberately does not re-print it, so the two can never drift.

# 9. Open the parent app on your phone (and what it does / does not do)

From the repo root (run pnpm build first):

pnpm build

pnpm start:app

Scan the QR code with Expo Go. The phone shows the splash, then the Home dashboard. There are 16 screens: onboarding (auth, child profile, pair device), the tabs (Home, Play, Grow, Family, Routines), and Device, Grandma mode, Notifications, Privacy, Reports, Settings, Voice call. To open one directly, append /--/<route> to the exp:// URL printed beside the QR code, e.g. /--/reports or /--/pair-device.

Important — the app does NOT connect to the robot yet. In this phase the app runs entirely on mock data. Fire a touch, a cry or a turn and nothing changes in the app — it cannot, because the live app-to-backend-to-device wiring is Phase 5 (Supabase). So do not try to cross-verify the robot through the app: the developer console is the single source of truth for hardware and contract testing. The app is here so you can see the full parent experience and all 16 screens.

One real overlap: the app’s Play, Grow, Reports and Routines screens read the same seeded content library the gateway uses, so the content you see there matches the console’s Content page — but statically, not as live device activity. After Phase 5, console-and-app cross-verification becomes real; the plumbing simply is not built yet.

# 10. What is built, what is not, and the open gates

## 10.1 Built and testable now

- The full wire contract (Document B v2) and pairing / device session (Document C Part 2).
- The voice-turn pipeline: STT → input safety → LLM + tool router → output safety → TTS, on mock providers, with the "let me think" filler.
- The complete safety layer (input + output guards, deferral, refusal, comfort + distress alert, no URL/phone/price/brand), English and Hindi.
- The tool router and the device-policy gate (quiet hours, play limit, movement off; movement categorically excluded).
- Content: stories, games, songs, learning, Grandma mode, six routine templates, word of the day, reports — with an unbypassable Active safety gate.
- Devices, sessions, pairing codes, presence; the whole developer console; the simulator; LAN bring-up with device authentication.
- The parent app: 16 screens, the design system, light theme, a static character placeholder.

## 10.2 Not built yet (deliberately) — do not expect these

Not yet | Consequence for you | Arrives
Supabase persistence (Phase 5) | Everything is in gateway memory. A paired device, content edits, routine state — all gone on gateway restart (the starter library re-seeds). The app runs on mock data. | Phase 5, pre-launch
Real STT / LLM / TTS | All AI is mocked. Replies are canned. Real conversation quality cannot be judged yet. | after gate F6 closes
BLE / Wi-Fi provisioning (Document C Part 1) | Getting Wi-Fi onto the device is not specified. You put the device on Wi-Fi yourself for now. | when the radio path is designed
Per-device certificates (mqtts/wss) | The dev token is dev-grade gatekeeping, not production security. | Phase 5 / provisioning
Rive character animation | The app shows a static placeholder, not the animated face. | Expo dev build, Phase 2+
Real OTA pipeline | The ota command exists and is acked like any other, but there is no update server. | later

## 10.3 The open safety / privacy gates

These are tracked decisions, not bugs. They do not affect your hardware testing on mocks, but they gate launch:

Gate | What it is
F2 | DPDP (India data-protection) review of reports and cry alerts — verifiable parental consent.
F5 | Whether the console may ever show transcript text at all (today it is local-only, off by default).
F6 | Safety Hardening — six items (word-list morphology, Unicode evasion, third-party-harm scope, quiet-hours vs a comforting reply, output-guard fail-closed, guard performance). ALL must close before any real STT/LLM/TTS provider is wired.

The one hard rule that reaches you: Test on the mock brain as much as you like. The moment anyone wants to run a REAL conversation (real AI) on the physical robot, gate F6 must be closed first. Until then, mock AI on hardware is completely fine and safe.

# 11. The "is every part working" checklist

Tick these off and you have verified the whole software, end to end, against the simulator — and the same list re-run from the robot verifies the firmware.

1. Stack: docker compose ps shows emqx, gateway, simulator all Up (healthy).
2. Console: http://127.0.0.1:5173 header reads "Stream: Live"; Dashboard shows the device Online with a battery %.
3. Simulator: http://127.0.0.1:8091 opens and lists Touch / Any event / Audio turn / Ack policy.
4. Devices tab: the device shows a 6-char pairing code and session Connected/Idle; toggle it offline and it reads Offline within ~45s.
5. Matrix 7.2a: say/animate/gesture/led/play ack done; move + the other five refuse (a refusal there is a pass).
6. Matrix 7.2b: every touch zone, wake, cry, motion, button, nfc, interrupt, error go green from the panel; one audio_turn goes green; the safety_refusal row goes green via Ack policy.
7. Device control: a led and a gesture each return an ack; lifting (Ack policy picked_up) makes the next one refuse.
8. Conversation: a story turn with an active child shows input allow / output allow / tools / latency; with no active child it shows a safe redirect.
9. Safety: a distress utterance shows a comfort reply + parent-alert signal.
10. Content: a story edit saves as a draft and only goes Active after the guard passes.
11. App: pnpm start:app opens Home on the phone; the 16 screens navigate (remember: mock data, not live).
12. LAN (when the robot is ready): with DEVICE_BIND_HOST=0.0.0.0 and a valid token, the robot appears in the Devices tab; a wrong/absent token is refused.

# 12. When something does not match, and who to tell

If your firmware and this guide disagree, Document B wins, then Document C, then this guide. If Document B itself looks wrong, stop and raise it with the founder: a contract change is a proto_ver bump with sign-off from both the software and hardware sides — never a quiet fix on either side of the wire. You do not edit anything in this repo; you report, and the change comes back reviewed.

Raise anything blocking to the founder (Omar). Reference the exact row, page or document section so it can be reproduced. For the deepest firmware detail, the authoritative source is docs/intern-integration-guide.md and Documents B and C in docs/.

# Appendix: CLI quick reference

All run from the repo root with the stack up. Useful when you prefer the terminal to the browser, or want to script a check.

### Gateway

docker compose exec gateway node dist/cli.js devices

docker compose exec gateway node dist/cli.js log --after 0

docker compose exec gateway node dist/cli.js send xlu_000123 config '{"active_child_id":"child_mock_1"}'

docker compose exec gateway node dist/cli.js send xlu_000123 animate '{"expression":"happy","eyes":"open","loop":false}'

### Simulator

docker compose exec simulator node dist/cli.js state

docker compose exec simulator node dist/cli.js event touch '{"zone":"belly","gesture":"tap"}'

docker compose exec simulator node dist/cli.js audio-turn

docker compose exec simulator node dist/cli.js offline

docker compose exec simulator node dist/cli.js online

docker compose exec simulator node dist/cli.js battery 20 false

### Everyday

docker compose up --build -d # start the stack

docker compose ps # check health

docker compose down # stop everything

pnpm dev:admin:device # console, with device control

pnpm start:app # parent app on the phone

End of guide · Xelulu · Document B v2 (proto_ver 2)
