verma-suraj/xelulu/Xelulu_ReportBack_and_Issue_Log.docx

Xelulu

Hardware Bring-Up: Report-Back & Issue Log

What to send back after testing - for the ESP32-S3 firmware engineer

# How to use this

This is the form you fill in as you bring up the robot and walk the test matrix. It tells the Xelulu team exactly what we need back from you: your firmware status, your test results, every error you hit, and the hardware facts we need to keep the specs honest and plan the next phase.

Fill each section as you go — do not wait until the end. Send an update whenever you finish the matrix against the simulator, and again against your firmware. Attach screenshots, photos and short videos where asked.

One privacy rule, above everything: Never send any audio a child spoke, any transcript, or any reply text. The console only ever shows ids, enums, counts and times (a cmd_id, a turn_id, an ack reason, a sequence number, a timestamp) — send exactly that and nothing more. If a screenshot would show turn text, crop it or turn transcripts off first.

# 1. Firmware identity & status

Item | Your answer
Firmware repo link (or zipped source)
Commit hash / tag you tested
fw_ver string(s) the firmware reports in hello
Hardware board/revision this firmware ran on
Date / time window of this test run

### Document B / C conformance self-check

Go through docs/intern-integration-guide.md §9 (the full conformance checklist) and mark each group. Use Done / Partial / Not yet, and add a note for anything not Done.

Conformance group | Status | Notes
Messages the firmware SENDS (hello, status heartbeat, acks) | Done / Partial / Not yet
Events (touch, wake, cry, motion, button, nfc, interrupt, error)
Commands the firmware ACCEPTS (say, animate, gesture, move, play, set_mode, led, volume, config, stop_audio, ota)
Acks returned (status + reason, final, idempotent)
Audio-turn WebSocket (Opus 16 kHz 20 ms, audio_start/end, barge-in)
Envelope & connection rules (proto_ver 2, ts, event_id, cmd_id, 15 s heartbeat, reconnect = subscribe→hello→heartbeat)

# 2. Test matrix results (the 28 rows)

Report the matrix outcome twice: once against the simulator (to prove your setup), then against your firmware. For each row, give the result and the evidence the console showed. Remember: ids, enums, counts and times only.

### 2a. Cloud → device (11 rows the console fires)

Row | Result (pass/fail) | Evidence (cmd_id, ack status, reason)
say
animate
gesture
led
play
move (expect refusal = pass)
set_mode / volume / config / stop_audio / ota (expect refusal = pass)

### 2b. Device → cloud (17 rows you fire at the device)

Mark each green row. Group the 7 touch zones on one line if all passed; list any that did not.

Row group | All green? | Any that failed + evidence
touch + 7 zones (head, left_ear, right_ear, belly, back, left_hand, right_hand) | Yes / No
wake, cry, motion, button, nfc, interrupt, error
audio_turn (one full turn)
safety_refusal

# 3. Error & issue log

One entry per problem. Reproduction steps are the most valuable thing you can give us — a bug we can reproduce is a bug we can fix. Copy this block for each issue.

Field | Fill in
Issue #
Feature / matrix row
What happened (one line)
Steps to reproduce (numbered)
Expected vs actual
Console evidence (ids / enums / ack reason / timestamp — no text)
Screenshot / photo / video attached?
Severity (blocker / major / minor)
Your guess at cause (firmware / guide / contract / unknown)

# 4. Hardware facts sheet (bill of materials & device profile)

This is the hardware ground-truth we need to keep Document B and the specs honest, and to plan power, cost and the next phases. Give exact part names and numbers wherever you can.

Component | Exact part / value | Notes
MCU (ESP32-S3 variant, flash, PSRAM)
Microphone(s)
Speaker + amplifier
Touch sensing (which part, and which sensor → which of the 7 zones)
LEDs (and which drive ears / cheeks / belly)
Motion sensor / IMU
NFC reader
Servos / motors (if any)
Battery (chemistry, capacity mAh)
Charging circuit
Anything else on the board

### Attach as well

- A wiring / pin-map summary (a photo of a hand sketch is fine).
- A photo of the assembled robot / bench setup.
- The serial console boot output (showing device_id, fw_ver and the pairing code it prints).

# 5. Measurements on real hardware

Measurement | Value you observed | Notes
Turn latency (ms) — belly-press to first audio back
Ack timing (ms) for a typical command
Reconnect behaviour after Wi-Fi drop
Offline detected after ~45 s of silence?
Barge-in (interrupt) working?
Measured battery life (hours, on what use)
Audio quality / dropouts

# 6. Network & provisioning notes

Because BLE/Wi-Fi provisioning is not specified yet (Document C Part 1 is reserved), tell us how you got the device online, so we can design the real path.

- How the device received Wi-Fi credentials (hard-coded, serial, captive portal, your own method).
- The LAN setup you used (router, subnet, the host IP the firmware pointed at).
- Any DNS / mDNS / firewall issues, and how you solved them.
- The DEVICE_ID / token values you used (these are dev placeholders, not secrets).

# 7. Deviations & contract questions

List anything where the firmware could not comply with Document B or C, or where the contract seemed wrong or unclear. Do not change anything to work around it — report it. These are the only inputs that can lead to a proto_ver change, and that needs sign-off from both sides.

# | Document / rule | The problem | Your proposed resolution

1
2
3

# 8. What to send back, and to whom

Send to the founder (Omar). A single message or email with:

1. This document, filled in.
2. Your firmware repo link (or zipped source) and the commit/tag tested.
3. Screenshots of the test matrix (ids/enums only — no turn text), the serial boot output, and a photo of the robot.
4. A short video of one full voice turn on the robot, if you can.
5. Your error & issue log entries, and your deviations list.
