verma-suraj/xelulu/Xelulu_ReportBack_and_Issue_Log_filled.docx

Xelulu

Hardware Bring-Up: Report-Back & Issue Log

What to send back after testing - for the ESP32-S3 firmware engineer

# How to use this

This is the form you fill in as you bring up the robot and walk the test matrix. It tells the Xelulu team exactly what we need back from you: your firmware status, your test results, every error you hit, and the hardware facts we need to keep the specs honest and plan the next phase.

Fill each section as you go — do not wait until the end. Send an update whenever you finish the matrix against the simulator, and again against your firmware. Attach screenshots, photos and short videos where asked.

Report status, 2026-11-01 (night update): the 28-row matrix ran against the simulator (28/28 pass) and against the real robot over Wi-Fi (21 pass, 1 expected fail, 6 not fireable on this hardware or not tried). Docker cannot run on the test PC (issue 6), so the stack ran on the host the way the README describes for pnpm start:gateway / start:simulator, with NanoMQ 0.25.7 standing in for EMQX 5.8.9 (sections 6 and 7). Section 5 has the measurements. Not done: the parent app on a phone (Expo Go SDK mismatch, issue 16), battery life, a cry from the robot. Screenshots and logs: folder Xelulu_report_attachments_2026-11-01 next to this file.

One privacy rule, above everything: Never send any audio a child spoke, any transcript, or any reply text. The console only ever shows ids, enums, counts and times (a cmd_id, a turn_id, an ack reason, a sequence number, a timestamp) — send exactly that and nothing more. If a screenshot would show turn text, crop it or turn transcripts off first.

# 1. Firmware identity & status

Item | Your answer
Firmware repo link (or zipped source) | Not in git yet: the xelulu_fw/ folder of the ZivikaLabs workspace (zip on request). Arduino core esp32 3.3.10, build line in the header of xelulu_fw.ino.
Commit hash / tag you tested | No commit (no git yet). Build of 2026-11-01 22:42 IST = fw_ver 0.2.0 plus one console-only fix found during this run (wifi accepts a quoted SSID/password, issue 12); no wire change, so fw_ver was not bumped.
fw_ver string(s) the firmware reports in hello | 0.2.0 (hello fw_ver), proto_ver 2, device_id xlu_000123. Pairing code it prints at boot: 3S88MF; the console's Devices tab showed the same 3S88MF for this device and fw_ver (guide 7.1 check passed).
Hardware board/revision this firmware ran on | Espressif ESP32-S3-DevKitC-1, ESP32-S3-WROOM-1 N16R8 (16 MB QIO flash, 8 MB octal PSRAM). Xelulu P0 prototype on jumpers, wired per Xelulu_Wiring.md (2026-10-24), mics changed to 2x INMP441 on 2026-11-01.
Date / time window of this test run | Hardware bring-up 2026-10-31 to 2026-11-01 (IST). Matrix vs simulator 2026-11-01 22:30-22:37 IST; vs the robot 22:59-23:09 IST; reconnect / offline tests 23:10-23:16 IST (log times are UTC, IST = UTC + 5:30).

### Document B / C conformance self-check

Go through docs/intern-integration-guide.md §9 (the full conformance checklist) and mark each group. Use Done / Partial / Not yet, and add a note for anything not Done.

Conformance group | Status | Notes
Messages the firmware SENDS (hello, status heartbeat, acks) | Done, verified against the gateway | hello accepted (auth ok) at every connect and after each reboot; status every 15 s; one ack per command, first ack median 48 ms. After a broker restart the gateway can miss the re-sent hello (issue 13, not a firmware fault). selftest wire: 52/52 passed - contract OK
Events (touch, wake, cry, motion, button, nfc, interrupt, error) | Partial (hardware), verified from the robot | Fired by the real robot and accepted: touch head / back / belly (tap, hold, pat); wake (touch hold); button belly_talk press + release; motion shake, tilt, upside_down; interrupt (tap during a reply); error (boot faults). Not fired: cry (not tried), nfc (no reader), ears / hands (no pads).
Commands the firmware ACCEPTS (say, animate, gesture, move, play, set_mode, led, volume, config, stop_audio, ota) | Done, verified | From the console: say, animate, led, play accepted then done; gesture rejected unsafe with USB plugged in at boot (servo bus off, issue 2). From the CLI / pipeline: config done, say done, stop_audio done. move and the other operator actions never reach the robot (the gate refuses them).
Acks returned (status + reason, final, idempotent) | Done, verified | accepted then done 130-186 ms later (animate, led, play, config, stop_audio); say is done when playback ends. A rejected ack names its reason (unsafe). No duplicates seen (Duplicate events 0).
Audio-turn WebSocket (Opus 16 kHz 20 ms, audio_start/end, barge-in) | Done, verified (mock providers) | Bearer token accepted; audio_start / audio_end; Opus 16 kHz 20 ms up (343 frames for a 6.9 s sentence) and 256 reply frames down, then audio_end. Barge-in: interrupt event -> stop_audio, robot acked in 88 ms. Mock STT cannot read real audio (deviation 7). Firmware issues: follow-up loop (14), no-speech close (15).
Envelope & connection rules (proto_ver 2, ts, event_id, cmd_id, 15 s heartbeat, reconnect = subscribe→hello→heartbeat) | Partial | proto_ver 2 everywhere, ts in unix seconds, unique event_id, time_uncertain until the clock syncs, client id = device_id, 15 s heartbeat, reconnect = subscribe -> hello -> heartbeat (seen on the console after a broker drop), back-off retries every 6-9 s. Gap: MQTT 3.1.1 not 5 (deviation 2).

# 2. Test matrix results (the 28 rows)

Report the matrix outcome twice: once against the simulator (to prove your setup), then against your firmware. For each row, give the result and the evidence the console showed. Remember: ids, enums, counts and times only.

### 2a. Cloud → device (11 rows the console fires)

Row | Result (pass/fail) | Evidence (cmd_id, ack status, reason)
say | Simulator: Pass Robot: Pass | Sim JltoqMGcw1-wsj9DiLavRA accepted (seq 213). Robot oczO8AQnlpHUTIAVhSvkdA accepted 40 ms, done 1300 ms (seq 60).
animate | Simulator: Pass Robot: Pass | Sim 7ZNBkKrfzZp3LXEPdxXQNQ accepted (seq 218). Robot aFLei932OTAl3fCvVlNijg accepted 54 ms, done 186 ms (seq 65).
gesture | Simulator: Pass Robot: Fail (expected) | Sim 4SrTJ8PAowpUXBFp2GZX5g done (seq 225). Robot nWVW021L8sdOS6R2PiyQaw rejected unsafe (seq 70): servo bus off while USB is plugged in at boot (issue 2). Needs a battery-only boot for done.
led | Simulator: Pass Robot: Pass | Sim 1mBE6jQVf5MT5P1ER85R1w accepted (seq 238; first try stuck Running, console race, issue 8). Robot FEF6tAfpSW0YQvxXTelmQA accepted 75 ms, done 166 ms (seq 74), drawn as a face glow.
play | Simulator: Pass Robot: Pass | Sim fxK_-_V5pPDwnEn-YYfVAQ done (seq 235). Robot CY4a9PWCeH72Sy6830-MZg accepted 46 ms, done 130 ms (seq 79).
move (expect refusal = pass) | Simulator: Pass Robot: Pass | action_refused / action_not_allowed on both: the gate refused it, nothing was sent.
set_mode / volume / config / stop_audio / ota (expect refusal = pass) | Simulator: Pass Robot: Pass | All five action_refused / action_not_allowed on both runs: nothing reached the device.

### 2b. Device → cloud (17 rows you fire at the device)

Mark each green row. Group the 7 touch zones on one line if all passed; list any that did not.

Row group | All green? | Any that failed + evidence
touch + 7 zones (head, left_ear, right_ear, belly, back, left_hand, right_hand) | Simulator: all 8 green Robot: 4 of 8 | Robot green: touch, head (seq 124), back (seq 88), belly (seq 91). left_ear, right_ear, left_hand, right_hand: no pads on this robot (deviation 1). The first quick head tap was missed; held taps register.
wake, cry, motion, button, nfc, interrupt, error | Simulator: all 7 green Robot: 5 of 7 | Robot green: wake (seq 93, touch hold), motion (seq 141: shake, tilt and upside_down all sent), button (seq 97 press, 99 release), interrupt (seq 188), error (seq 365, boot faults after a reboot). cry: not tried. nfc: no reader.
audio_turn (one full turn) | Simulator: green Robot: green | Sim t_f1sT6Ec8yCBVhRcKVarPmw (seq 286). Robot t_ywWghD17SHgoB5dPzRlh9w (seq 214): 100 frames up, 256 down, reply_ended. Every robot turn ends 'uncertain': the mock STT cannot decode real speech (deviation 7).
safety_refusal | Simulator: green Robot: green | Sim kyNig1wzc7eYcbLUpX6TSA rejected picked_up (Ack policy). Robot nWVW021L8sdOS6R2PiyQaw rejected unsafe (gesture with the servo bus off). A lift + gesture refusal needs a battery-only boot (servos on): not run.

Matrix screenshots (left: simulator, 28/28; right: real robot, 21/28 + 1 expected fail):


# 3. Error & issue log

One entry per problem. Reproduction steps are the most valuable thing you can give us — a bug we can reproduce is a bug we can fix. Copy this block for each issue.

Field | Fill in
Issue # | 1
Feature / matrix row | Microphones / audio_turn, wake (input)
What happened (one line) | The right mic (SPH0645, SEL 3.3 V) gave no data at 16 kHz; a good mic moved to that slot did the same.
Steps to reproduce (numbered) | 1. Flash test9_mic (16/32/48 kHz cycle). 2. Read the R slot: empty at 16 kHz, garbled at 32, mostly valid at 48 kHz. 3. Swap SEL wires: the good mic fails on the R slot too; the right module gives garbage on any slot.
Expected vs actual | Expected: both slots clean at 16 kHz. Actual: right slot empty. Fixed 2026-11-01 by replacing both with INMP441: both slots clean at 16/32/48 kHz.
Console evidence (ids / enums / ack reason / timestamp — no text) | Raw slot words ffffffff at 16 kHz, mixed valid / 4-bit-early words at 32 kHz (test9 raw log).
Screenshot / photo / video attached? | No
Severity (blocker / major / minor) | major (resolved)
Your guess at cause (firmware / guide / contract / unknown) | hardware: SPH0645 modules on the WS-high slot

Field | Fill in
Issue # | 2
Feature / matrix row | gesture, safety_refusal (and the console)
What happened (one line) | The servo bus is on GPIO 19/20 = the native USB pins, and the DevKit's CH340 (UART0) is dead: no console while servos run.
Steps to reproduce (numbered) | 1. Boot with USB plugged in: console works, servos absent, gesture refused unsafe. 2. Boot on battery only: servos work, no serial console at all.
Expected vs actual | Expected: console and servos together. Actual: one or the other. Firmware 0.2.0 picks at boot (USB host present -> console).
Console evidence (ids / enums / ack reason / timestamp — no text) | Matrix gesture row: nWVW021L8sdOS6R2PiyQaw rejected unsafe (seq 70). Boot line: [servo] USB console plugged in: servo bus OFF.
Screenshot / photo / video attached? | Yes: 02_matrix_robot_21of28.png
Severity (blocker / major / minor) | major
Your guess at cause (firmware / guide / contract / unknown) | hardware: pin budget + dead USB-serial chip (fix the CH340 or move the bus)

Field | Fill in
Issue # | 3
Feature / matrix row | move, safety_refusal (lift)
What happened (one line) | No cliff sensors on this build (2 forward ToF only), so wheel motion is blocked and lift is guessed from the IMU.
Steps to reproduce (numbered) | 1. Boot on the floor. 2. Send any move: rejected unsafe. 3. Lift the robot: pickup comes from an IMU jolt only.
Expected vs actual | Expected: cliff-checked wheels and a ToF-confirmed lift. Actual: wheels never move; a gentle lift (< 1.2 g) is not reported as pickup; a hand held very still reads as put down after 2 s.
Console evidence (ids / enums / ack reason / timestamp — no text) | Boot faults cliff-front / cliff-rear missing (error events).
Screenshot / photo / video attached? | No
Severity (blocker / major / minor) | major
Your guess at cause (firmware / guide / contract / unknown) | hardware (as built)

Field | Fill in
Issue # | 4
Feature / matrix row | Display (all faces)
What happened (one line) | TFT_eSPI 2.5.43 on Arduino core 3.x: blank screen, then a frozen first frame.
Steps to reproduce (numbered) | 1. Build with USE_FSPI_PORT and MISO -1: tft.init() hangs. 2. With HSPI: DMA pushes freeze the panel.
Expected vs actual | Expected: animated face. Actual: blank / frozen. Fixed: USE_HSPI_PORT + clear the HSPI DMA flag after each push.
Console evidence (ids / enums / ack reason / timestamp — no text) | -
Screenshot / photo / video attached? | No
Severity (blocker / major / minor) | minor (resolved)
Your guess at cause (firmware / guide / contract / unknown) | firmware library

Field | Fill in
Issue # | 5
Feature / matrix row | touch rows
What happened (one line) | Touches through the casing never registered with the MPR121's default baseline filter.
Steps to reproduce (numbered) | 1. Default Adafruit filter: the baseline follows the hand, no touch. 2. Slow falling filter (NXP AN3944): instant touches.
Expected vs actual | Expected: touch on every pad. Actual: none. Fixed 2026-10-31 with calibrated thresholds head 21/10, back 24/12, belly 12/6.
Console evidence (ids / enums / ack reason / timestamp — no text) | -
Screenshot / photo / video attached? | No
Severity (blocker / major / minor) | minor (resolved)
Your guess at cause (firmware / guide / contract / unknown) | firmware setting

Field | Fill in
Issue # | 6
Feature / matrix row | Test setup (whole matrix)
What happened (one line) | Docker Desktop cannot be installed on the test PC: Windows' component store is corrupt.
Steps to reproduce (numbered) | 1. Docker Desktop 4.97 install: EnableFeaturesAction fails, DISM error 14098. 2. DISM /RestoreHealth + sfc clean, VirtualMachinePlatform still 14098. 3. The October cumulative update KB5127648 fails to stage: 0x80073712 (2026-11-01).
Expected vs actual | Expected: docker compose up. Actual: no WSL2, no Docker. Worked around: gateway + simulator + console run on the host (README pnpm start:* path), broker NanoMQ 0.25.7 (deviation 5). Real fix: Windows in-place repair install, then Docker.
Console evidence (ids / enums / ack reason / timestamp — no text) | -
Screenshot / photo / video attached? | No
Severity (blocker / major / minor) | major (worked around)
Your guess at cause (firmware / guide / contract / unknown) | test setup (PC)

Field | Fill in
Issue # | 7
Feature / matrix row | Front ToF (collision / approach); error row
What happened (one line) | The two front VL53L0X (mux CH0, CH1) answer on some boots and not on others; when they answer, the firmware takes them for the cliff pair.
Steps to reproduce (numbered) | 1. Boot fw 0.2.0 a few times (2026-11-01/02: 7 boots). 2. Results vary: all four channels silent; or CH0/CH1 ok and labelled cliff-front / cliff-rear (floor 29-77 mm); or only CH0, labelled front.
Expected vs actual | Expected: CH0 and CH1 found on every boot, used as front sensors. Actual: intermittent; and role auto-detection treats anything within 100 mm at boot as the floor.
Console evidence (ids / enums / ack reason / timestamp — no text) | Boot lines: [tof] front=CH2(MISSING) rear=CH3(MISSING) cliff-front=CH0(ok) cliff-rear=CH1(ok) floor 39/77 mm.
Screenshot / photo / video attached? | Yes: robot_serial_boot_2026-11-01.txt
Severity (blocker / major / minor) | minor
Your guess at cause (firmware / guide / contract / unknown) | hardware: mux power / I2C wiring to CH0-CH1, XSHUT floating; firmware: Tof.cpp role detection assumes 4 sensors

Field | Fill in
Issue # | 8
Feature / matrix row | Test matrix, cloud -> device rows (console)
What happened (one line) | A driven row can stay 'Running' forever although the robot acked.
Steps to reproduce (numbered) | 1. Open /#/matrix against the simulator (acks in ~3 ms). 2. Run say, animate, led... in a row. 3. Now and then one row never leaves Running; Reset + Run passes.
Expected vs actual | Expected: Pass once the ack arrives. Actual: the ack reached the page before the route's cmd_id, was folded as 'seen' while no row awaited it, and is never matched (apps/admin/src/matrix/matrix-state.ts, applyEntries).
Console evidence (ids / enums / ack reason / timestamp — no text) | animate sQfbjMKWB1eUs7Qe0IXgww: gateway seq 135 accepted / 137 done, row stayed Running; led u5nvX3UWAD1CexQBCopzCA same.
Screenshot / photo / video attached? | No
Severity (blocker / major / minor) | minor
Your guess at cause (firmware / guide / contract / unknown) | console (admin app)

Field | Fill in
Issue # | 9
Feature / matrix row | Test matrix, device -> cloud rows (console + guide)
What happened (one line) | A freshly loaded matrix page shows device rows green from older events (for example the simulator's).
Steps to reproduce (numbered) | 1. Fire events from the simulator. 2. Reload /#/matrix: 17 rows are already Pass. 3. Connect the robot: its rows look green before it has done anything.
Expected vs actual | Expected (guide 7.2: 'reload and it restarts'): all Pending. Actual: the page folds the entries the gateway still holds. 'Reset all rows' after load gives a clean run; the guide does not say so.
Console evidence (ids / enums / ack reason / timestamp — no text) | On load: '28 rows · 17 passed · 0 failed · 0 running · 11 pending'.
Screenshot / photo / video attached? | No
Severity (blocker / major / minor) | minor
Your guess at cause (firmware / guide / contract / unknown) | guide (or console)

Field | Fill in
Issue # | 10
Feature / matrix row | Device control, matrix 7.2a (guide 5, intern guide)
What happened (one line) | The guide says local Compose already starts the gateway with --device-control; docker-compose.yml does not.
Steps to reproduce (numbered) | 1. Read docker-compose.yml: gateway command = --listen-all-interfaces --operator-transcripts --content-admin. 2. Intern guide line 52 says Compose does NOT pass it; line 116 and this guide say it does.
Expected vs actual | Expected: dev:admin:device can send. Actual (with Docker): every send would answer device_control_disabled. This run passed the flag itself (stack not in Docker).
Console evidence (ids / enums / ack reason / timestamp — no text) | -
Screenshot / photo / video attached? | No
Severity (blocker / major / minor) | major (for anyone using Docker)
Your guess at cause (firmware / guide / contract / unknown) | guide / compose

Field | Fill in
Issue # | 11
Feature / matrix row | gesture (active child policy), guide 7
What happened (one line) | Right after setting the active child, gesture is refused movement_off.
Steps to reproduce (numbered) | 1. cli.js send xlu_000123 config {active_child_id: child_mock_1}. 2. Within 15 s, Run gesture: refused movement_off. 3. After the device's next status: gesture done.
Expected vs actual | Expected: the child applies at once. Actual: the gateway takes the active child from the device's next status (up to 15 s later). Guide 7 should say to wait one heartbeat.
Console evidence (ids / enums / ack reason / timestamp — no text) | config acked 17:00:08.686, next status 17:00:22.054; gesture at 17:00:20.9 refused movement_off.
Screenshot / photo / video attached? | No
Severity (blocker / major / minor) | minor
Your guess at cause (firmware / guide / contract / unknown) | guide

Field | Fill in
Issue # | 12
Feature / matrix row | Provisioning (robot console)
What happened (one line) | The robot's console 'wifi SSID PASS' split on spaces, so an SSID like 'Prishu Priyanshu-2.4G' could not be set.
Steps to reproduce (numbered) | 1. wifi Prishu Priyanshu-2.4G <pass> -> SSID 'Prishu', password 'Priyanshu-2.4G'.
Expected vs actual | Expected: any SSID. Fixed 2026-11-01: wifi takes "quoted" SSID / password (Console.cpp). The run used a phone hotspot named 'internet' in the end.
Console evidence (ids / enums / ack reason / timestamp — no text) | -
Screenshot / photo / video attached? | No
Severity (blocker / major / minor) | minor (resolved)
Your guess at cause (firmware / guide / contract / unknown) | firmware

Field | Fill in
Issue # | 13
Feature / matrix row | Presence / session after a broker restart (Document C)
What happened (one line) | After the broker restarts, the device's session stays 'Offline - 45 s silence' while Presence reads Online.
Steps to reproduce (numbered) | 1. Robot connected and idle. 2. Stop the broker 60 s (or 20 s), start it again. 3. The robot reconnects first (retries every 6-9 s) and sends subscribe -> hello -> status; the gateway reconnects ~11-30 s later.
Expected vs actual | Expected: session back to Connected/Idle. Actual: the hello went to the broker while the gateway had no subscription (clean start, no session) and was dropped; heartbeats then set Presence Online, the session stays Offline until the device reconnects again. The firmware is conformant (console: 'hello acked, status sent').
Console evidence (ids / enums / ack reason / timestamp — no text) | Gateway broker_connected 17:43:52.701; first device message 17:44:07.524 status (presence online, cause status), no hello. Devices tab: Session 'Offline - 45 s silence', Presence Online.
Screenshot / photo / video attached? | Yes: 11_robot_presence_online_session_offline.png
Severity (blocker / major / minor) | major
Your guess at cause (firmware / guide / contract / unknown) | contract (Document C) / gateway

Field | Fill in
Issue # | 14
Feature / matrix row | audio_turn, interrupt (follow-up listening)
What happened (one line) | After a reply, the robot opens a new turn by itself about 0.6 s later, again and again.
Steps to reproduce (numbered) | 1. Hold the belly and speak; let the reply play. 2. Do nothing: a new 1.2 s turn starts ~0.6 s after each reply ends.
Expected vs actual | Expected: follow-up only when someone speaks. Actual: 7 turns in ~70 s until a reboot. No echo cancelling: the follow-up VAD hears the robot's own reply tail.
Console evidence (ids / enums / ack reason / timestamp — no text) | Turns t_TtHESw0ppLi6-QFngS09wQ, t_axoDFNplN3xOA8az9udKAg, t_8xYm37g7Gm3NUp2zTcMfQA... each started 0.5-0.7 s after the previous reply_ended.
Screenshot / photo / video attached? | No
Severity (blocker / major / minor) | major
Your guess at cause (firmware / guide / contract / unknown) | firmware (Turn.cpp follow-up, no AEC)

Field | Fill in
Issue # | 15
Feature / matrix row | audio_turn (no speech)
What happened (one line) | A belly hold with no speech sends audio_end and then closes the socket at once.
Steps to reproduce (numbered) | 1. Hold the belly 4 s without speaking.
Expected vs actual | Expected: either a clean cancel or wait for the reply. Actual: audio_end, close 10 ms later; the gateway logs the turn aborted, cause client_closed.
Console evidence (ids / enums / ack reason / timestamp — no text) | t_I8syxOKFa2NW_rEdGj3qrQ: 200 frames in, audio_end 17:31:30.865, aborted client_closed 17:31:30.875.
Screenshot / photo / video attached? | No
Severity (blocker / major / minor) | minor
Your guess at cause (firmware / guide / contract / unknown) | firmware (Turn.cpp TI_NO_SPEECH) or contract: may a device cancel after audio_end?

Field | Fill in
Issue # | 16
Feature / matrix row | Parent app (guide 9)
What happened (one line) | Expo Go cannot open the parent app: 'Project is incompatible with this version of Expo Go'.
Steps to reproduce (numbered) | 1. pnpm start:app (with --port 8082: 8081 is the gateway's audio port). 2. Android Expo Go from the Play Store, open exp://<PC-IP>:8082.
Expected vs actual | Expected: Home dashboard. Actual: Expo Go is for SDK 58, the app is SDK 57. Android can sideload Expo Go for SDK 57 from expo.dev/go; iOS cannot. Not done.
Console evidence (ids / enums / ack reason / timestamp — no text) | Metro log: 'The installed version of Expo Go is for SDK 58. The project you opened uses SDK 57.'
Screenshot / photo / video attached? | No
Severity (blocker / major / minor) | blocker (guide 9)
Your guess at cause (firmware / guide / contract / unknown) | guide / repo (Expo SDK pin; also port 8081 clash with the gateway)

Field | Fill in
Issue # | 17
Feature / matrix row | Content (operator content routes)
What happened (one line) | /v1/content/update answers HTTP 400 for an edit the guard refuses, yet the edit is saved as a draft.
Steps to reproduce (numbered) | 1. Update story_tenali_wall's title to one with a phone number. 2. HTTP 400 invalid_fields, verdict contact_detail. 3. The Content page shows the new title as a Draft, 'Refused: contact_detail at tiny en-IN (title)'.
Expected vs actual | Expected: a 4xx changes nothing, or a 200 with the refusal. Actual: state changes on a 400. The page handles it well; an API client could be misled.
Console evidence (ids / enums / ack reason / timestamp — no text) | -
Screenshot / photo / video attached? | Yes: 10_content_guard_refused_draft.png
Severity (blocker / major / minor) | minor
Your guess at cause (firmware / guide / contract / unknown) | gateway API

# 4. Hardware facts sheet (bill of materials & device profile)

This is the hardware ground-truth we need to keep Document B and the specs honest, and to plan power, cost and the next phases. Give exact part names and numbers wherever you can.

Component | Exact part / value | Notes
MCU (ESP32-S3 variant, flash, PSRAM) | ESP32-S3-WROOM-1 N16R8 on an ESP32-S3-DevKitC-1: 16 MB flash, 8 MB octal PSRAM | Native USB (COM) = console; the board's CH340 USB-serial is dead
Microphone(s) | 2x INMP441 I2S MEMS, omnidirectional (since 2026-11-01; were 2x GY-SPH0645) | One I2S bus: SCK 4, WS 5, SD 6; L/R pin GND = left, 3.3 V = right; 100k SD pull-down. 16 kHz, L+R averaged
Speaker + amplifier | MAX98357A I2S amp (GAIN floating = 9 dB, SD on 3.3 V) + 28 mm 8 ohm speaker (0.5 W) | BCLK 15, LRC 16, DIN 7. Volume cap 0 dBFS, synth gain 180 (bench 2026-10-31)
Touch sensing (which part, and which sensor → which of the 7 zones) | Adafruit MPR121 12-key capacitive, I2C 0x5A | ELE0 head, ELE1 back, ELE2 belly; ELE3 left_hand, ELE4 right_hand planned, not fitted; no ear pads. Thresholds head 21/10, back 24/12, belly 12/6
LEDs (and which drive ears / cheeks / belly) | None physical | led targets (ears / cheeks / belly) are drawn as glows on the 2.0" IPS ST7789 face screen (SPI, backlight GPIO45)
Motion sensor / IMU | GY-87: MPU6050 accel + gyro (plus HMC5883L, BMP180), I2C | pickup (> 1.2 g up), shake (3 spikes > 0.55 g in 800 ms), tilt, drop, upside_down
NFC reader | None | Open BOM decision (PN532 under the belly)
Servos / motors (if any) | 3x Waveshare SC09 serial-bus servos (ID 1 head, 2 left arm, 3 right arm); 2x N20 6 V 200 rpm with quadrature encoders + TB6612FNG | Servo bus TX 20 (1 kohm) / RX 19, shared with native USB. Motors PWMA 1, AIN 2/42, PWMB 41, BIN 13/47; encoders L 17/48, R 18/3
Battery (chemistry, capacity mAh) | 2x LG INR18650MJ1 3400 mAh in series: 2S Li-ion, 7.4 V nominal (~25 Wh), 2S 20 A BMS | KCD1 rocker switch on the battery line
Charging circuit | Type-C to 2S 8.4 V 4 A booster charger module into the BMS | No charge signal to the ESP: status.charging is always false; charge with the switch off
Anything else on the board | XY-3606 buck 7.4 -> 5 V 5 A; AMS1117 3.3 V LDO; TCA9548A mux + 2x VL53L0X front (CH0, CH1 - intermittent, issue 7) | No cliff sensors. The built-in microSD slot is unused. battery_pct is estimated from the servo-reported rail (80 % when the servos are off). Wi-Fi 2.4 GHz only

### Attach as well

- A wiring / pin-map summary (a photo of a hand sketch is fine).
- A photo of the assembled robot / bench setup.
- The serial console boot output (showing device_id, fw_ver and the pairing code it prints).

Serial boot output (fw 0.2.0, 2026-11-02 00:10 IST, USB console, robot on the hotspot with the stack up; full log in the attachments):

Xelulu fw 0.2.0 FW-SOT 1.2 proto_ver 2 reset 3

[face] ST7789 320x240, canvas 240x240 zoom 1.50, DMA on

[touch] baselines: head=704 back=704 belly=704 left_hand=704 right_hand=704 (hands not fitted)

[sense] MPR121 ok, MPU6050 ok, BMP180 present (unused), HMC5883L not used

[tof] front=CH0(ok) rear=CH1(MISSING)[fault] + tof_rear_missing

[servo] USB console plugged in: servo bus OFF (it shares GPIO 19/20). Unplug USB + reboot for the servos

[id] device_id=xlu_000123 fw_ver=0.2.0 pairing=3S88MF token=set proto_ver=2 FW-SOT=1.2

[wifi] up 10.171.191.202 rssi -36

[wire] hello acked, status sent, replaying 6 queued event(s)

device_id xlu_000123 fw_ver 0.2.0 proto_ver 2 FW-SOT 1.2 pairing 3S88MF token set

wifi up (internet) rssi -52 | mqtt ready (mqtt://10.171.191.241:1883) | clock 1793558015 | queue 0 in flight -1

faults: tof_rear_missing cliff_front_missing cliff_rear_missing servo_1_missing servo_2_missing servo_3_missing

selftest wire: 52/52 passed - contract OK

# 5. Measurements on real hardware

Measurement | Value you observed | Notes
Turn latency (ms) — belly-press to first audio back | Belly press -> audio_start 184 ms; gateway audio_end -> reply start 14 ms | Robot turn t_rMA_CzaTcvMffReYdHIzRQ: button press 17:37:01.999, audio_start 02.183. Mock pipeline, so the gateway side says nothing about real STT/LLM/TTS. The robot's own 'audio_end -> first frame' line was not captured.
Ack timing (ms) for a typical command | First ack median 48 ms (26-168 ms, 18 commands); done 130-186 ms | Robot on a 2.4 GHz phone hotspot, RSSI -26 to -43 dBm, broker on the PC. Done: play 130, config 137, led 166, stop_audio 179, animate 186 ms; say is done when playback ends (1.3-8.7 s).
Reconnect behaviour after Wi-Fi drop | Reboot: back in 5.0 s. Broker drop: retries every 6-9 s, then subscribe -> hello -> status | Reboot cmd 17:38:31.26 -> hello 17:38:36.28, queued events replayed. Broker stopped 60 s and 20 s with Wi-Fi up: the robot came back on its own, but the gateway missed its hello (issue 13). A real Wi-Fi loss was not tested (the PC shared the same hotspot).
Offline detected after ~45 s of silence? | Yes: 45.9 s of silence -> Offline (cause silence) | Robot: broker stopped 17:40:34.75, last heartbeat 17:40:21.63, Offline 17:41:06.64. Simulator: 'Offline - 45 s silence' 35 s after taking it offline (45 s after its last heartbeat).
Barge-in (interrupt) working? | Yes | Tap during a reply -> interrupt event 17:37:10.009 -> gateway audio_end + stop_audio within 2 ms -> robot acked stop_audio accepted 88 ms, done 179 ms; the reply stopped at frame 51. No echo cancelling yet (issue 14).
Measured battery life (hours, on what use) | Not measured | Needs a long battery-only run. Pack is 2S 3400 mAh; BOM estimate 6-8 h mixed use.
Audio quality / dropouts | Upstream clean; downstream played in full | Opus 16 kHz 20 ms up: 343 frames (13.2 KB) for a 6.9 s sentence, 100 frames for 2 s, no gaps logged. Down: 256 frames, say done at the end. Mock TTS frames are synthetic placeholders, so nothing audible. Mics: INMP441 clean; fan noise on the bare mics ~-35 dBFS (mount behind the casing with foam).

# 6. Network & provisioning notes

Because BLE/Wi-Fi provisioning is not specified yet (Document C Part 1 is reserved), tell us how you got the device online, so we can design the real path.

- How the device received Wi-Fi credentials (hard-coded, serial, captive portal, your own method).
- The LAN setup you used (router, subnet, the host IP the firmware pointed at).
- Any DNS / mDNS / firewall issues, and how you solved them.
- The DEVICE_ID / token values you used (these are dev placeholders, not secrets).

Wi-Fi credentials: typed on the robot's USB console: wifi SSID PASS (put the SSID or password in "quotes" if it has spaces, since 2026-11-01), id DEVICE_ID TOKEN, url MQTT_URL AUDIO_URL. Each is kept in NVS and reboots the robot. Nothing is hard-coded.

LAN: a phone hotspot (SSID 'internet') set to 2.4 GHz: the ESP32-S3 has no 5 GHz radio, and the hotspot first came up on 5 GHz (channel 36), where the robot could not see it. PC 10.171.191.241/24, robot 10.171.191.202 (DHCP). Robot url mqtt://10.171.191.241:1883 ws://10.171.191.241:8081.

Stack: not Docker (issue 6). Broker NanoMQ 0.25.7 with tooling/emqx/auth-bootstrap.json's three users and anonymous off (checked: anonymous, wrong token and unknown id refused; device and gateway accepted over MQTT 5). Gateway, simulator and console on the host: Node 24.21.0, pnpm 10.34.6, root .env from .env.local.example with 127.0.0.1 hosts; gateway args --operator-transcripts --content-admin --device-control; TZ=UTC like the containers (the mock child's quiet hours are read in UTC). For the robot: broker and audio socket on 0.0.0.0, simulator stopped (it is also xlu_000123). No repo file was changed.

Firewall: Windows put the hotspot in the Public profile. The first listen on 0.0.0.0 raised Windows Security alerts for nanomq.exe and node.exe; allowing both on Public networks was enough. No DNS / mDNS (IP addresses only). Windows also moved the PC back to its usual Wi-Fi by itself after a hotspot hiccup (23:44 IST), cutting the robot off until the PC rejoined: untick 'connect automatically' on other networks while testing.

DEVICE_ID xlu_000123 (firmware default); DEVICE_TOKEN = the stack's dev placeholder from .env.local.example.

# 7. Deviations & contract questions

List anything where the firmware could not comply with Document B or C, or where the contract seemed wrong or unclear. Do not change anything to work around it — report it. These are the only inputs that can lead to a proto_ver change, and that needs sign-off from both sides.

# | Document / rule | The problem | Your proposed resolution

1 | Document B touch zones (7) | The robot has pads on head, back and belly only (hand pads planned, not fitted; no ear pads), so left_ear / right_ear / left_hand / right_hand cannot fire from this hardware. | Keep the enum. Mark those rows n/a for P0, or add ear and hand pads (MPR121 electrodes ELE5-11 are free).
2 | Intern guide 9.4: MQTT 5, clean start | The firmware connects with MQTT 3.1.1 (clean session): the Arduino-ESP32 core's MQTT library is compiled without MQTT 5. Nothing in Document B uses an MQTT-5-only feature; the whole matrix passed on 3.1.1. | Accept 3.1.1 for the prototype, or rebuild the core libraries with MQTT 5 enabled before production.
3 | led command and nfc event | No physical LEDs: led is drawn as glows on the face screen. No NFC reader: nfc is never sent (story cards and treasure hunt unavailable). | Confirm on-screen glows satisfy led. Decide on NFC (PN532) for P0, or mark the nfc row n/a.
4 | status: charging, battery_pct | No charge signal reaches the ESP, so charging is always false; battery_pct is a coarse estimate from the servo-reported rail. | Add a charger-state pin and a battery divider on the next board revision.
5 | Test setup: EMQX 5.8.9 in Docker (guide 4) | Docker cannot run on the test PC, so NanoMQ 0.25.7 ran as the broker, with the same users and anonymous off. Difference seen: NanoMQ drops a refused login without a CONNACK reason code, so a device cannot tell 'bad token' from a network fault there. | Re-run the robot rows on EMQX once Docker works. Nothing in the gateway or the firmware was changed for NanoMQ.
6 | Document C: reconnect = subscribe -> hello -> heartbeat | The rule assumes the gateway is listening when the device re-sends hello. After a broker restart the device can reconnect first; its hello (QoS 1, not retained) is dropped because the gateway's clean session has no subscription yet (issue 13). | Gateway: a persistent session (clean start off, session expiry > 0), or ask a device for a fresh hello when its status arrives on a session that is not Connected/Idle. Needs a contract decision either way.
7 | Mock STT (Local_Mode, gate F6) | The mock STT only decodes the simulator's encoded utterance frames, so real device audio always ends 'stt_failed' -> 'uncertain' reply: tools, stories and comfort can't be exercised from the robot. | A Local_Mode mock that maps any non-empty device audio to a fixed test transcript, so hardware turns reach the brain before F6 closes.

# 8. What to send back, and to whom

Send to the founder (Omar). A single message or email with:

1. This document, filled in.
2. Your firmware repo link (or zipped source) and the commit/tag tested.
3. Screenshots of the test matrix (ids/enums only — no turn text), the serial boot output, and a photo of the robot.
4. A short video of one full voice turn on the robot, if you can.
5. Your error & issue log entries, and your deviations list.
