verma-suraj/xelulu/Eillik/test/preservation_property_test.py

"""
Preservation Property Tests — Eilik Bot Logic Fix

This script verifies that existing CORRECT behaviors in the Eilik_Bot firmware
are preserved, serving as regression prevention after the 9 bug fixes are applied.

**Validates: Requirements 3.1, 3.2, 3.3, 3.4, 3.5, 3.6, 3.7, 3.8, 3.9, 3.10, 3.11, 3.12**

EXPECTED OUTCOME: All tests PASS on unfixed code (confirming baseline behavior).
After the fix is applied, these tests should STILL pass (no regressions).

Methodology: Observation-first — we observe the actual code behavior patterns
on the UNFIXED code and write property tests that capture those patterns.
"""

import os
import re
import sys
import struct

# Resolve source file paths relative to this script
SCRIPT_DIR = os.path.dirname(os.path.abspath(__file__))
PROJECT_ROOT = os.path.dirname(SCRIPT_DIR)
BOT_DIR = os.path.join(PROJECT_ROOT, "Eilik_Bot")

PINS_H = os.path.join(BOT_DIR, "Pins.h")
EILIK_SERVOS_CPP = os.path.join(BOT_DIR, "EilikServos.cpp")
EILIK_MOTION_CPP = os.path.join(BOT_DIR, "EilikMotion.cpp")
EILIK_BOT_INO = os.path.join(BOT_DIR, "Eilik_Bot.ino")
EILIK_FACE_CPP = os.path.join(BOT_DIR, "EilikFace.cpp")
EILIK_FACE_H = os.path.join(BOT_DIR, "EilikFace.h")
EILIK_SOUND_CPP = os.path.join(BOT_DIR, "EilikSound.cpp")
EILIK_SOUND_H = os.path.join(BOT_DIR, "EilikSound.h")
EILIK_TOUCH_CPP = os.path.join(BOT_DIR, "EilikTouch.cpp")
EILIK_TOUCH_H = os.path.join(BOT_DIR, "EilikTouch.h")
EILIK_MOTION_H = os.path.join(BOT_DIR, "EilikMotion.h")
EILIK_SERVOS_H = os.path.join(BOT_DIR, "EilikServos.h")


def read_file(path):
    """Read a source file and return its content."""
    with open(path, "r", encoding="utf-8", errors="replace") as f:
        return f.read()


class PreservationResults:
    """Collects pass/fail results for preservation tests."""

    def __init__(self):
        self.results = []

    def record(self, prop_id, description, passed, detail=""):
        self.results.append({
            "prop_id": prop_id,
            "description": description,
            "passed": passed,
            "detail": detail,
        })

    def summary(self):
        total = len(self.results)
        passed = sum(1 for r in self.results if r["passed"])
        failed = total - passed
        return total, passed, failed

    def print_report(self):
        print("=" * 72)
        print("PRESERVATION PROPERTY TEST REPORT")
        print("=" * 72)
        for r in self.results:
            status = "PASS" if r["passed"] else "FAIL"
            print(f"\n[{status}] Property {r['prop_id']}: {r['description']}")
            if r["detail"]:
                print(f"       Detail: {r['detail']}")
        total, passed, failed = self.summary()
        print("\n" + "=" * 72)
        print(f"TOTAL: {total} | PASSED: {passed} | FAILED: {failed}")
        if failed > 0:
            print(f"\n*** {failed} preservation test(s) FAILED — regression detected ***")
        else:
            print("\n*** All preservation tests PASSED — baseline behavior confirmed ***")
        print("=" * 72)


results = PreservationResults()


# =============================================================================
# Property 1: Head touch pad readings > TOUCH_HEAD_THRESH trigger pat reaction
# Validates: Requirements 3.7
# =============================================================================
def test_head_touch_pat_reaction():
    """For all touch readings > TOUCH_HEAD_THRESH on head pad, head pat reaction fires correctly."""
    content_touch = read_file(EILIK_TOUCH_CPP)
    content_ino = read_file(EILIK_BOT_INO)

    # Observe: touchPinsUpdate() returns TOUCH_HEAD_PAT when head pad reading < threshold
    # The touch handler in .ino triggers giddy/charmed/loving/embarrassed chain
    has_head_pat_return = bool(re.search(r"return.*TOUCH_HEAD_PAT", content_touch))

    # Observe: Head pat reactions in Eilik_Bot.ino
    head_pat_match = re.search(
        r"te\s*==\s*TOUCH_HEAD_PAT\)\s*\{(.*?)(?:else\s+if|$)",
        content_ino, re.DOTALL
    )
    if not head_pat_match:
        results.record("P1", "Head touch pat reaction", False,
                       "TOUCH_HEAD_PAT handler not found")
        return

    handler = head_pat_match.group(1)
    has_giddy = bool(re.search(r"FACE_GIDDY", handler))
    has_charmed = bool(re.search(r"FACE_CHARMED", handler))
    has_loving = bool(re.search(r"FACE_LOVING", handler))
    has_embarrassed = bool(re.search(r"FACE_EMBARRASSED", handler))
    has_pat_count = bool(re.search(r"patCount", handler))

    passed = (has_head_pat_return and has_giddy and has_charmed and
              has_loving and has_embarrassed and has_pat_count)
    detail = ""
    if not passed:
        missing = []
        if not has_head_pat_return:
            missing.append("no TOUCH_HEAD_PAT return in touchPinsUpdate")
        if not has_giddy:
            missing.append("missing FACE_GIDDY")
        if not has_charmed:
            missing.append("missing FACE_CHARMED")
        if not has_loving:
            missing.append("missing FACE_LOVING")
        if not has_embarrassed:
            missing.append("missing FACE_EMBARRASSED")
        detail = "; ".join(missing)
    results.record("P1", "Head touch pat chain: giddy/charmed/loving/embarrassed", passed, detail)


# =============================================================================
# Property 2: IMU shake/knock/tilt patterns trigger correct emotions
# Validates: Requirements 3.3, 3.4, 3.5
# =============================================================================
def test_imu_emotion_triggers():
    """For all IMU acceleration sequences matching shake/knock/tilt, correct emotion triggers."""
    content_motion = read_file(EILIK_MOTION_CPP)
    content_ino = read_file(EILIK_BOT_INO)
    content_pins = read_file(PINS_H)

    # Observe: Shake detection logic — 3+ spikes within 800ms above SHAKE_SPIKE_G
    has_spike_count_3 = bool(re.search(r"spikeCount\s*>=\s*3", content_motion))
    has_800ms_window = bool(re.search(r"now\s*-\s*firstSpike\s*>\s*800", content_motion))
    shake_thresh_match = re.search(r"#define\s+SHAKE_SPIKE_G\s+([\d.]+)f?", content_pins)
    shake_thresh = float(shake_thresh_match.group(1)) if shake_thresh_match else None

    # Observe: Knock detection — single spike > KNOCK_MIN_G + 300ms quiet
    has_knock_quiet = bool(re.search(r"pendingKnock.*now\s*-\s*pendingKnock\s*>\s*300", content_motion, re.DOTALL))
    knock_thresh_match = re.search(r"#define\s+KNOCK_MIN_G\s+([\d.]+)f?", content_pins)
    knock_thresh = float(knock_thresh_match.group(1)) if knock_thresh_match else None

    # Observe: Tilt detection — >45° for >400ms
    has_tilt_angle = bool(re.search(r"TILT_DEG", content_motion))
    tilt_deg_match = re.search(r"#define\s+TILT_DEG\s+(\d+)", content_pins)
    tilt_deg = int(tilt_deg_match.group(1)) if tilt_deg_match else None
    has_tilt_400ms = bool(re.search(r"now\s*-\s*tiltSince\s*>\s*400", content_motion))

    # Observe: Reactions in .ino
    # Shake → confused/furious/crying escalation
    has_shake_confused = bool(re.search(r"MOTION_SHAKE.*?FACE_CONFUSED", content_ino, re.DOTALL))
    has_shake_furious = bool(re.search(r"MOTION_SHAKE.*?FACE_FURIOUS", content_ino, re.DOTALL))
    has_shake_crying = bool(re.search(r"MOTION_SHAKE.*?FACE_CRYING", content_ino, re.DOTALL))
    # Knock → FACE_WONDER
    has_knock_wonder = bool(re.search(r"MOTION_KNOCK.*?FACE_WONDER", content_ino, re.DOTALL))
    # Tilt → FACE_SCARED
    has_tilt_scared = bool(re.search(r"MOTION_TILT.*?FACE_SCARED", content_ino, re.DOTALL))

    checks = [
        (has_spike_count_3, "shake needs 3+ spikes"),
        (has_800ms_window, "800ms shake window"),
        (shake_thresh == 0.55, f"SHAKE_SPIKE_G == 0.55 (got {shake_thresh})"),
        (has_knock_quiet, "knock needs 300ms quiet"),
        (knock_thresh == 0.20, f"KNOCK_MIN_G == 0.20 (got {knock_thresh})"),
        (has_tilt_angle, "tilt uses TILT_DEG"),
        (tilt_deg == 45, f"TILT_DEG == 45 (got {tilt_deg})"),
        (has_tilt_400ms, "tilt needs >400ms hold"),
        (has_shake_confused, "shake → CONFUSED"),
        (has_shake_furious, "shake → FURIOUS"),
        (has_shake_crying, "shake → CRYING"),
        (has_knock_wonder, "knock → WONDER"),
        (has_tilt_scared, "tilt → SCARED"),
    ]

    failed_checks = [desc for ok, desc in checks if not ok]
    passed = len(failed_checks) == 0
    detail = "; ".join(failed_checks) if failed_checks else ""
    results.record("P2", "IMU shake/knock/tilt → correct emotion triggers", passed, detail)
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
