verma-suraj/xelulu/(notices)

Notices in the files:
Eillik/ESP32_Faces/EyeDrawer.h:
This program is free software: you can redistribute it and/or modify it under the terms of the GNU Affero General Public License as published by
the Free Software Foundation, either version 3 of the License, or (at your option) any later version.
